DuongNAD/Project_IoT/slides/preview/slide_07.png

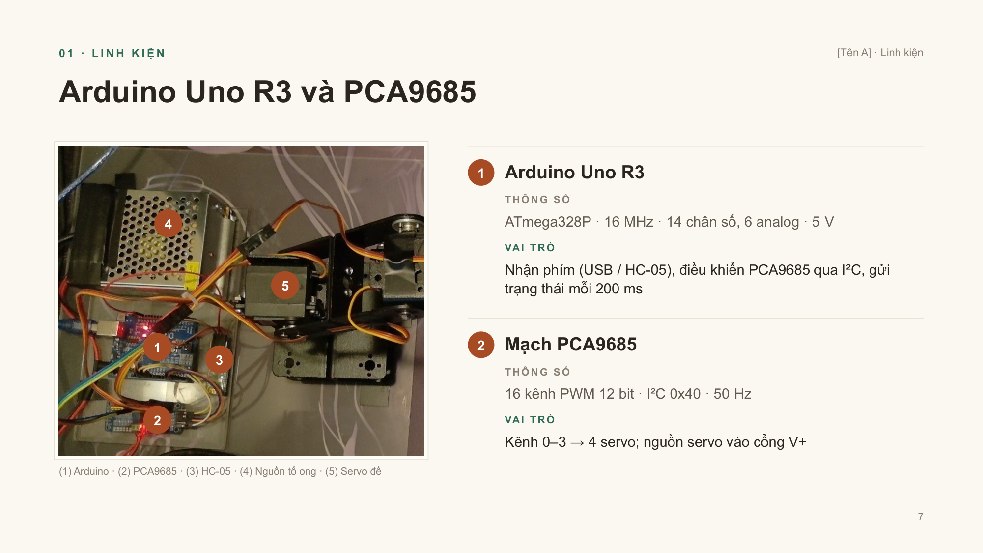
slides/preview/slide_07.png
