DuongNAD/Project_IoT/slides/preview/slide_13.png

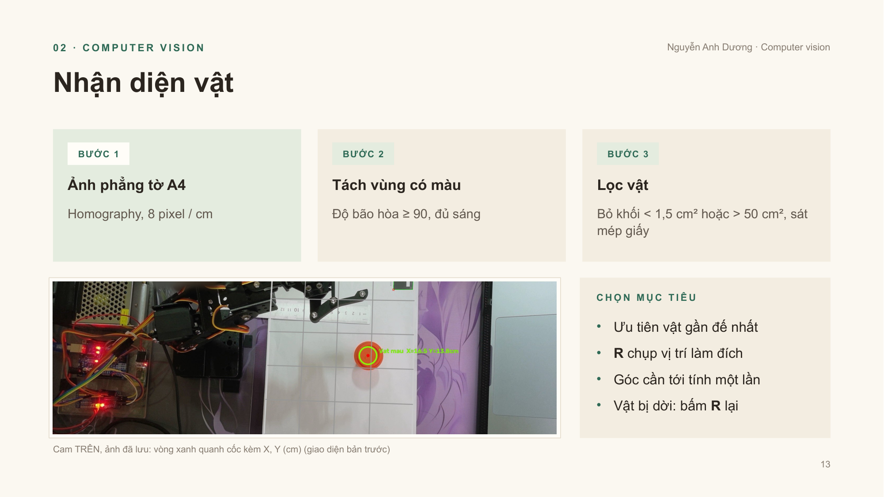
slides/preview/slide_13.png
