DuongNAD/Project_IoT/slides/05_SO_LIEU_VA_NGUON.md

# 05 · Số liệu và nguồn (nguồn sự thật duy nhất cho slide)

Mọi con số, tên linh kiện và nhận định trên slide **chỉ được lấy từ file này**. Kiểm tra lần cuối: **10/11/2026**, sau khi rút gọn mã phần 2
(`vision.py`, `cameras.py`, `screen.py`, `success.py`; bỏ YOLO, điện thoại, xoay hình, tráo camera). Ngày 11/11: đế khởi động ở 180°, điều khiển từ xa bằng máy Dell đưa lại ở dạng gọn (`share.py`, `remote.py`); phím R chụp đích một lần; rút gọn cổng USB (bỏ phần cho firmware cũ), bỏ phím C; bỏ bộ test tự động, nhóm kiểm tra bằng mắt (xem mục 11); các việc làm tay được thì bỏ code: tạo tờ ArUco, công cụ khớp hiệu chỉnh, hiệu chỉnh đế bằng chuột (phím B), chạy không cửa sổ, tự tìm cổng Arduino, báo Arduino reset, tìm camera theo tên. Bộ slide đã dựng: `Project_IoT_ThuyetTrinh.pptx` (26 slide, 3 phần cho 4 người, `build_slides.py`).

Kiểm lại bằng máy sau mỗi lần sửa mã: `.venv/bin/python -B slides/tools/check_facts.py` (so các hằng số ở mục 17 và mọi dẫn `file:dòng` trong các file `.md` với mã hiện tại).

Nhãn trạng thái:

| Nhãn | Nghĩa |
|---|---|
| **[CODE]** | đọc trực tiếp từ mã nguồn, firmware hoặc `calibration.json` (có dòng dẫn) |
| **[ĐO]** | đo hoặc quan sát trên phần cứng thật (ảnh, hoặc ghi chú của phiên làm việc ngày 02/11 khi không có ảnh) |
| **[MÔ PHỎNG]** | chạy trên ảnh đã lưu, hoặc với cánh tay mô phỏng (không cắm USB) |
| **[ƯỚC LƯỢNG]** | suy ra từ ảnh, sai số ± đã ghi; phải nói "khoảng" |
| **[CHƯA]** | chưa làm hoặc chưa kiểm chứng; chỉ được nói là "chưa" |

---

## 1. Phần cứng

| Mục | Giá trị | Nhãn | Nguồn |
|---|---|---|---|
| Vi điều khiển | Arduino Uno (board `arduino:avr:uno`) | CODE | `robot_arm_4dof/flash.sh:19`; `README.md` mục 1 |
| Mạch PWM | PCA9685, địa chỉ I²C 0x40, xung 50 Hz | CODE | `robot_arm_4dof.ino:8,90` |
| Servo | 4 × MG996R: kênh 0 đế, 1 vai, 2 khuỷu, 3 kẹp | CODE | `README.md` mục 1; `robot_arm_4dof.ino:26-29`; `control.py:44` |
| Bước mỗi phím | đế, vai, khuỷu **2°**; kẹp **5°** | CODE | `robot_arm_4dof.ino:13-14`; `control.py:51` |
| Giới hạn góc | đế 0–180°, vai 25–155°, khuỷu 25–155°, kẹp 95–**160°** | CODE | `control.py:45-50`; `robot_arm_4dof.ino:19-21,121-152` |
| Góc khởi động / Home | **180** / 90 / 90 / 95° (phím `H` đưa về): đế quay hết sang phải (nhìn theo cam NGANG) để cánh tay không che vật ở cam TRÊN; trước 11/11 là 90 / 90 / 90 / 95° | CODE | `robot_arm_4dof.ino:26-29,154-158`; `control.py:45-50` |
| Nguồn servo | nguồn tổ ong riêng 5–6 V vào cổng xanh PCA9685, **không** lấy từ cổng USB | CODE (tài liệu) | `README.md` mục 1 |
| Bluetooth | HC-05 qua `SoftwareSerial` chân D2/D3, 9600 baud; nhận phím từ máy Dell khi điều khiển từ xa (mục 5) | CODE | `robot_arm_4dof.ino:6,87` |
| Cổng USB tới laptop | Serial 9600 baud; cổng ghi tay khi chạy (`--port /dev/cu.usbmodem…` trên macOS, `--port COM3` trên Windows), không ghi thì chạy mô phỏng | CODE | `robot_arm_4dof.ino:86`; `control.py:186`; `main.py` (`--port`) |
| Gói trạng thái Arduino → laptop | JSON `{"t":…,"servo":[đế,vai,khuỷu,kẹp],"relax":0\|1,"armrelax":0\|1}`; gửi ngay sau mỗi phím và mỗi 200 ms (5 gói/giây danh định, **đo thực tế 4–5 gói/giây**) | CODE + ĐO | `robot_arm_4dof.ino:70-83,186-188,203-207` |
| **Góc servo báo về là góc LỆNH** | gói JSON in các biến `angleBase`, `angleShoulder`… mà firmware đã gán; MG996R không báo vị trí thật. "Đã tới góc" nghĩa là lệnh đã tới góc, **không** phải đã đo thấy cánh tay ở đó | CODE | `robot_arm_4dof.ino:70-83` |
| Cam TRÊN | OBSBOT Meet SE treo phía trên tờ giấy, nhìn xuống, 1920×1080 | CODE + ĐO | `README.md` mục 1; ghi chú phiên 02/11 (memory `project-iot-camera-setup`) |
| Cam NGANG | camera tích hợp MacBook đặt thấp trước tờ giấy, 1920×1080 | CODE + ĐO | `README.md` mục 1; `cameras.py:1-7` |
| Hệ điều hành và thư viện | macOS, Python ≥ 3.12, OpenCV, pyserial; chạy được cả trên Windows (camera mở bằng DirectShow, cổng `COMx`); camera chọn bằng chỉ số OpenCV (`--top`, `--side`); **mọi ảnh và số đo trong slide đều làm trên macOS** | CODE | `pyproject.toml`; `cameras.py:19-28` |

## 2. Tờ A4, hệ tọa độ và nhận diện vật

| Mục | Giá trị | Nhãn | Nguồn |
|---|---|---|---|
| Tờ giấy | A4 đặt ngang 29,7 × 21,0 cm, in đúng 100% (đo cạnh một mã phải đúng 2,8 cm) | CODE | `vision.py:16`; `README.md` mục 1 |
| Mã ArUco của tờ | 4 mã `DICT_4X4_50` (bộ mã có sẵn của OpenCV), ID 0–3, cạnh 2,8 cm, cách mép 0,25 cm, sát 4 góc; tờ in là `aruco_A4_clean.pdf`; dò mã bằng hàm có sẵn `cv2.aruco` | CODE | `vision.py:17-19` |
| Hệ tọa độ | gốc ở góc ngoài mã ID 0; X chạy ID 0 → ID 1 (29,7 cm); Y chạy ID 0 → ID 3 (21,0 cm); gắn với **tờ giấy**, không phụ thuộc camera nào nhìn | CODE | `README.md` mục 4; `calibration.py:5` |
| Homography | từ các mã ArUco 0–3 (cần ≥ 2 mã), cho **cả hai camera**; ảnh phẳng của tờ giấy dựng bằng `warpPerspective` | CODE | `vision.py:45-62,71` |
| Che mất mã | nhớ vị trí từng mã nên che 1–3 mã vẫn còn lưới; dời camera hoặc tờ giấy thì bấm `U` để quên | CODE + MÔ PHỎNG | `README.md` mục 4; `main.py:100-102` |
| **Cách tìm vật** | tách màu HSV trên ảnh phẳng của tờ giấy: độ bão hòa ≥ 90, sáng ≥ 60; bỏ khối < 1,5 cm² (nhiễu, dây điện) hoặc > 50 cm² (bàn tay, không lọt miệng kẹp), khối cách mép giấy dưới 1 cm (bỏ lọc "dính thân robot" ngày 12/11: đích chỉ chụp một lần khi bấm R) | CODE | `vision.py:68-91` |
| YOLO | **đã bỏ** ngày 10/11 khi rút gọn phần 2 (trước đó là tùy chọn `--yolo`, mặc định tắt, bản COCO chưa fine-tune, có nhận nhầm) | CODE | `README.md` mục 9 |
| Kích thước cốc đỏ số 3 | thân 34 mm, nắp ≈ 40 mm, cao 50 mm (độ cao dùng để bù thị sai) | ĐO | `vision.py:23` |
| Chọn vật (phím `R`) | bấm `R`: vật gần đế nhất trong ảnh lúc bấm thành đích, góc cần tới tính **một lần** lúc bấm, sau đó không theo camera nữa (tay kẹp che hay đẩy lệch vật cũng không đổi đích); vật bị dời thì bấm `R` lại; chưa bấm `R` thì chưa có lệnh. Bỏ ngày 11/11: theo dõi vật liên tục (trung bình 10 khung, nhớ 120 s khi bị che, `R` bỏ chốt) | CODE | `control.py:253-275` |
| **Hiệu chỉnh phối cảnh cam TRÊN** | cam treo cao ≈ 46 cm nhìn xuống; vật cao 5 cm hiện lệch ≈ 1 cm; công thức `p_thật = n + (p_đo − n)·(H − h)/H` (n: tâm ảnh, H: 46 cm, h: độ cao vật). Một phép đo ngày 02/11: cam TRÊN (20,6; 6,8) cm, cam MacBook (20,0; 7,8) cm, lệch **1,2 cm**; sau hiệu chỉnh còn **0,2 cm** | CODE + ĐO (một vị trí cốc) | `vision.py:22-23,76-89` |
| Độ cao 46 cm của cam TRÊN | ước từ ảnh (≈ 27 px/cm ở mặt bàn); không đo bằng thước | ƯỚC LƯỢNG | `vision.py:22`; ghi chú phiên 02/11 |

## 3. Khối điều khiển (`control.py`): từ vật tới phím cần bấm

| Mục | Giá trị | Nhãn | Nguồn |
|---|---|---|---|
| Việc của khối điều khiển | vật ở (X, Y) cm → góc ba servo cần tới (IK) → danh sách phím cần bấm; giữ cổng USB tới Arduino. **Không biết** thế nào là "xong" | CODE | `control.py:-1-11`; `README.md` (đầu trang, bảng hai nhóm) |
| Số đo cánh tay mặc định (`ARM_CONFIG`) | d₁ = 70 mm (mặt bàn → trục vai), L₂ = 105 mm (vai → khuỷu), L₃ = 100 mm (khuỷu → cổ tay), tâm hai ngón kẹp lệch L₄ᵣ = 65 mm ra trước và L₄z = 25 mm xuống dưới | CODE (số đo thước) | `control.py:26-31` |
| Góc chuẩn khi servo 90° (mặc định) | khâu L₂ nghiêng +45°, khâu L₃ gập −45° so với L₂; **thực tế khác** (xem mục 8) | CODE | `control.py:39-40` |
| Mô hình | đế quay θ₁ = atan2(y, x); vai + khuỷu giải tam giác hai khâu (nghiệm khuỷu hướng lên); **không có servo cổ tay** nên hướng ngón kẹp không chọn được | CODE | `control.py:60-96` |
| Điểm kẹp mục tiêu | cao **25 mm** (nửa thân cốc cao 50 mm) | CODE | `control.py:54` |
| Đổi sang servo | đế = 90 + θ₁; vai = 90 + (θ₂ − θ₂@90); khuỷu = 90 + (θ₃ − θ₃@90); làm tròn về bội số của bước (2°) quanh neo 90°, kẹp trong giới hạn | CODE | `control.py:99-116` |
| Đổi tọa độ | giấy (cm) ↔ hệ robot (mm) theo vị trí và hướng của đế | CODE | `control.py:119-131` |
| Phím và hướng | `A` / `D` xoay đế **sang phải / sang trái, nhìn theo cam NGANG (MacBook)**; `W` / `S` nâng / hạ vai; `I` / `K` khuỷu lên / xuống; `J` / `L` mở / khép kẹp; `H` Home; `X` kẹp nghỉ | CODE | `control.py:138-143`; `README.md` mục 2 |
| Lưu ý chú thích | chú thích trong firmware ghi `a (Trái)` theo hướng nhìn của chính robot; trên màn hình và slide dùng hướng nhìn theo cam NGANG, ngược lại | CODE | `robot_arm_4dof.ino:120`; `screen.py:51` |
| Kế hoạch bấm (`Plan`, `Move`) | mỗi servo một `Move` gồm phím, số lần (= độ lệch ÷ bước, làm tròn xuống), hướng, số độ; **kẹp không bao giờ nằm trong Plan** | CODE | `control.py:147-169,232-241` |
| Ngoài tầm với | IK báo `reachable = False` và dời vật thêm bao nhiêu mm; màn hình ghi `Vat ngoai tam voi` | CODE | `control.py:60-96`; `screen.py:21-25` |
| **Ví dụ tính được** | với `calibration.json` hiện tại, cốc ở **(20,1; 7,4) cm** → robot x = 240 mm, y = −73 mm → gợi ý **đế 74°, vai 58°, khuỷu 90°**. Từ tư thế 90/90/90: đế −16° = phím **D × 8**, vai −32° = phím **S × 16**, khuỷu 0 (đã đúng) | CODE (tính lại 02/11 23:07) | mục 16 |
| Ví dụ trên ảnh màn hình (slide 8) | khung camera thật 20:27: cốc ở **(16,5; 13,8) cm** → gợi ý **[đế 88°, vai 60°, khuỷu 84°]**; từ 90/90/90 (Home của bản trước 11/11): **S × 15** (hạ vai 30°), **K × 3** (khuỷu xuống 6°), đế lệch 2° nên `DA DUNG`; còn **18 lần bấm** | MÔ PHỎNG (chương trình chạy trên ảnh đã lưu; đế đổi sang hệ lúc chụp, xem mục 5) | ảnh `ui_screen_before.png`; `slides/tools/make_screen_images.py` |
| Cổng USB | 9600 baud, đọc nền; **mở cổng một lần** lúc chạy và không mở lại (mỗi lần mở cổng Uno tự reset); rút cáp USB thì chạy lại chương trình; Arduino reset thì nhìn thấy cánh tay giật về Home (không có cảnh báo trên màn hình) | CODE | `control.py:175-226` |
| Gửi phím | app chỉ gửi phím khi **người bấm**; không còn chế độ tự gửi (Auto-Step đã bỏ) | CODE | `control.py:277-283`; `main.py:90-103` |

## 4. Khối success (`success.py`): đã tới chưa?

| Mục | Giá trị | Nhãn | Nguồn |
|---|---|---|---|
| Việc của khối success | nhận `Plan` của khối điều khiển, trả lời một câu: ba servo đế / vai / khuỷu đã tới góc gợi ý chưa. **Không biết** gì về camera, IK hay cổng USB | CODE | `success.py:1-6` |
| Quy tắc "đã tới" | mỗi servo lệch **≤ 1 bước bấm (2°)** so với góc gợi ý (lệch 3° là chưa) | CODE | `success.py:11,27` |
| Quy tắc "một lần thành công" | cả ba servo đã tới và **giữ liên tục ≥ 1,0 giây** thì đếm thêm 1; giữ thêm không đếm nữa; lướt qua chưa đủ 1 s không đếm; rời góc rồi tới lại đủ lâu thì đếm lần hai | CODE | `success.py:12,38-56` |
| Kẹp **không tính** | kẹp lệch 55° vẫn XONG; bản đơn giản chỉ cần đưa đầu kẹp tới đúng chỗ của vật | CODE | `success.py:4` |
| Bốn trạng thái | `done` (xong) · `moving` (còn phải bấm) · `no_target` (chưa có đích: chưa bấm `R`) · `unreachable` (vật ngoài tầm); `no_target` được xét trước, rồi `unreachable` (trạng thái `relaxed` đã bỏ ngày 12/11 cùng phím `Z`); chưa có đích thì không được báo xong | CODE | `success.py:17,25-35` |
| Kết quả (`Result`) | `state`, `done`, `joints_ok` (3 giá trị), `next_move` (việc đầu tiên chưa xong theo thứ tự đế → vai → khuỷu), `remaining` (tổng số lần bấm còn lại), `count` | CODE | `success.py:15-22` |
| Vì sao dung sai 2° | "mô hình hình học chỉ chính xác cỡ đó"; bắt căn tới 0° chỉ làm người dùng đuổi theo nhiễu | CODE (chú thích) | `success.py:11` |
| Hai khối chỉ nói chuyện qua một đối tượng | `Plan` (khối điều khiển sinh ra, khối success đọc); cùng một `Plan` cho cùng một kết luận, không cần camera hay cổng USB | CODE | `README.md` (đầu trang) |
| **Giới hạn của "XONG"** | góc servo là **góc lệnh** (mục 1): XONG chứng minh phím đã được bấm đúng số lần, **không** chứng minh hai ngón kẹp thật đang ở sát vật. Độ đúng của gợi ý phụ thuộc mô hình hình học (mục 8) | CODE | `robot_arm_4dof.ino:70-83`; `success.py:30` |
| **Trạng thái thật** | **chưa có lần đếm thành công nào trên cánh tay thật**: bản này mới chạy trên ảnh đã lưu với cánh tay mô phỏng (`slides/tools/make_screen_images.py`); Arduino được rút ra lúc ≈ 22:40 | MÔ PHỎNG / CHƯA | ghi chú phiên 02/11; `ls logs` (không có thư mục) |

## 5. Màn hình (`screen.py`, `main.py`)

| Mục | Giá trị | Nhãn | Nguồn |
|---|---|---|---|
| Bố cục | cửa sổ rộng 1280 px: hai camera ở trên (mỗi ô 640 × 360), bên dưới **ô 1 · ĐIỀU KHIỂN** (trái) và **ô 2 · SUCCESS** (phải), chân trang; chỉ có chữ, không trang trí | CODE | `screen.py:1-10,45-75` |
| Ô 1 | lệnh to màu cam: `BAM D x8: SANG TRAI 16 do`; ba dòng servo (`DE (xoay): 90 -> 74 do bam D x8`), dòng đã tới ghi `DA DUNG` màu xanh | CODE | `screen.py:50-59` |
| Ô 2 | `CHUA XONG` + `con N lan bam`, hoặc **`XONG!`** màu xanh khi cả ba servo tới góc; `Thanh cong: N lan` | CODE | `screen.py:61-70` |
| Trạng thái khác | ô 1 ghi `Chua co dich: ... roi bam R`, `Vat ngoai tam voi` hoặc `Khong can bam them`; ô 2 ghi `CHUA XONG` | CODE | `screen.py:21-25` |
| Trên hai camera | vòng **DICH** (chỗ vật lúc bấm `R`) vẽ trên mặt giấy (dấu **KEP** đã bỏ ngày 12/11); lưới 5 cm; viền tờ giấy; dòng `Luoi A4: thay n/4 ma ArUco` | CODE | `main.py:65-71`; `vision.py:108-121,135-157` |
| Chân trang | trạng thái USB (`DA KET NOI` hoặc `MO PHONG`), hàng phím tắt | CODE | `screen.py:72-74` |
| **Điều khiển từ xa** | máy Dell cách ≈ 2 m: `remote.py` lấy ảnh màn hình Mac qua Wi-Fi (`share.py`, `http://<ip Mac>:8000/screen.jpg`, chỉ cho xem, không nhận lệnh) và gửi phím `A D W S I K J L H X` qua Bluetooth HC-05 thẳng tới Arduino; `H` phải bấm 2 lần trong 2 giây; `R` bấm trên bàn phím Mac. Mac vẫn nối USB để nhận góc servo và tính lệnh, success | CODE | `share.py`; `remote.py`; `main.py:106-118` |
| Điều khiển từ xa trên phần cứng | bản rút gọn 11/11 **chưa chạy với HC-05 và máy Dell thật** | CHƯA | — |
| Chữ **không dấu** | OpenCV `putText` không vẽ được dấu tiếng Việt: giữ nguyên, nói rõ khi thuyết trình | CODE | `screen.py:10` |
| Ảnh màn hình trên slide | `ui_screen_before.png` (khung camera 20:27) và `ui_screen_done.png` (khung 20:32:52, sau khi **mô phỏng** bấm 21 phím theo lệnh) là màn hình **thật của chương trình (giao diện trước khi rút gọn `screen.py` ngày 10/11, còn dấu `KEP` đã bỏ ngày 12/11; chạy lại `make_screen_images.py` trên Mac để có giao diện mới), chạy trên ảnh camera thật đã lưu, cánh tay MÔ PHỎNG** (chân trang ghi `USB Arduino: MO PHONG`, tiêu đề camera ghi `anh da luu`): không phải lần chạy trực tiếp. Ảnh chụp lúc tờ giấy còn hướng ban đầu còn `calibration.json` ghi theo tờ đã xoay 180°, nên script đổi đế về hệ lúc chụp rồi tự kiểm (dấu `KEP` đã hiệu chỉnh cách cốc ≤ 2 cm, không thì dừng). Hai ảnh cho cốc lệch 1,5 cm vì hai ngón kẹp che cốc ở khung 20:32:52 | MÔ PHỎNG | `slides/tools/make_screen_images.py` |

## 6. Firmware bảo vệ servo (tránh nóng)

| Mục | Giá trị | Nhãn | Nguồn |
|---|---|---|---|
| Nguyên nhân nóng | firmware cũ không ngắt xung PWM: kẹp giữ vật hoặc chạm chốt chặn thì servo bị ép liên tục; lệnh đóng cũ 175° ứng xung ≈ 2,74 ms, vượt dải 0,5–2,5 ms của MG996R | CODE (chú thích) | `robot_arm_4dof.ino:16-18,21`; `README.md` mục 6 |
| Giới hạn kẹp hiện tại | **160°** (xung ≈ 2,56 ms, **hơi vượt** dải danh định 2,5 ms); nâng từ 150° lên 160° theo chủ máy vì ở 150° khe giữa hai ngón bằng bề rộng nắp cốc nên không siết được; vẫn có tự nhả xung | CODE + ĐO | `robot_arm_4dof.ino:21`; ghi chú phiên 02/11 21:4x |
| Ngắt xung tự động | kẹp **mở hết cỡ (đúng 95°)** 5 giây không có lệnh kẹp → ngắt xung; kẹp **đã khép (> 95°)** quá 60 giây → ngắt xung (vật có thể tuột) | CODE | `robot_arm_4dof.ino:22-23,191-201` |
| Phím nghỉ | `X` nghỉ servo kẹp ngay; firmware vẫn còn lệnh `z` (nghỉ cả 4 servo) nhưng app không gửi phím này (bỏ ngày 12/11); chỉ phím di chuyển mới cấp xung lại | CODE | `robot_arm_4dof.ino:160-176`; `README.md` mục 6 |
| Cờ trong JSON | `relax` (kẹp nghỉ), `armrelax` (ba servo còn lại nghỉ) | CODE | `robot_arm_4dof.ino:78-82` |
| Chương trình biết tay đang nghỉ | đã bỏ ngày 12/11 cùng phím `Z`: app không còn trạng thái `relaxed`, chỉ đọc `servo` trong gói JSON | QUYẾT ĐỊNH | `success.py:25-35` |
| **Đã nạp và kiểm** | firmware cuối (phím Z, bước 2°/5°, giới hạn 160°) nạp lúc 21:42:45 và 21:54:48 ngày 02/11, kiểm trên mạch thật: banner kết thúc `+ Z (nghi het)`, JSON có `armrelax`. Trước đó (17:35) bản chống nóng kênh kẹp: `relax` chuyển 0 → 1 sau 5 giây ở 95° | ĐO (ghi chú phiên) | memory `project-iot-arduino-firmware`; `robot_arm_4dof.ino:99` |
| Kẹp đã ngắt xung thì tự khép | khi PWM kênh kẹp bị cắt, hai hàm rơi thành hình chữ V hẹp (khe ≈ 1–2 cm), trong khi kẹp có xung ở 95° thì mở rộng ≈ 7 cm. Hệ quả: ngắt xung sau 5 s ở 95° làm hàm sập nếu không bấm `J` lại | ƯỚC LƯỢNG (ảnh zoom ±30%) | ghi chú phiên 02/11 20:18 |
| Nhiệt độ servo | **chưa đo**; chưa có số "nguội đi bao nhiêu độ" | CHƯA | — |
| Màn hình cảnh báo "GIU 31s" | **không còn** (thuộc giao diện cũ đã bỏ) | — | `screen.py` không có |

## 7. Buổi thử trên cánh tay thật, 02/11/2026

| Mục | Giá trị | Nhãn | Nguồn |
|---|---|---|---|
| Thử 18:10–18:28 | một hướng tiếp cận, dừng trước khi kẹp. Kết luận "cốc ở mép tầm với, dời cốc 3 cm" **đã bị rút lại**; ảnh buổi này không dùng | — | ghi chú phiên (đính chính 20:25) |
| **Kẹp bằng bàn phím 20:32–20:36** | người bấm phím theo hình hai camera (và màn hình bản cũ): cốc đỏ ở giữa giấy được kẹp, chuyển sang trái, đặt xuống, lặp lại nhiều lần; cốc đổ khoảng 3 lần và được dựng lại bằng tay | ĐO | ảnh `demo_*` (khung cắt từ video, mỗi cặp cách 10 giây: 20:32:52, 20:33:02, 20:33:12) |
| Góc servo lúc kẹp | đế ≈ 85°, vai ≈ 60–65°, khuỷu ≈ 85–90°, kẹp ≈ 145–150°; đế ≈ 60° khi mang cốc sang trái (đọc từ màn hình bản cũ) | ĐO | ghi chú phiên 02/11 20:32–20:35 |
| Tay kẹp không giữ chắc cốc thon | ở 150° khe giữa hai ngón bằng bề rộng nắp cốc (≈ 3,9 cm) nên cốc bị đẩy ra; cốc thon dần xuống đáy nên hai mặt kẹp đẩy nó ra "như hạt dưa"; **nâng giới hạn lên 160° cũng chưa giữ chắc**. Cách chữa đề xuất: dán ma sát (băng keo hai mặt / xốp mỏng) lên mặt trong hai ngón, hoặc dùng vật thân thẳng | ĐO + CODE (tài liệu) | `README.md` mục 6; `robot_arm_4dof.ino:21`; ghi chú phiên 21:42–21:58 |
| **Quyết định của đề tài** | vì vậy "thành công" chỉ xét **ba góc servo đế / vai / khuỷu** tới góc gợi ý, kẹp không tính | QUYẾT ĐỊNH | `success.py:4`; ghi chú phiên 22:00 |
| Tự động | **không**: app chỉ gửi phím khi người bấm | CODE | mục 3 |
| Tỉ lệ thành công | **chưa đo**; kế hoạch 28/10 đặt mục tiêu ≥ 80% trên 30 lần, chưa chạy | CHƯA | kế hoạch PDF; không có thư mục `logs/` |

## 8. Mô hình lệch cánh tay thật và hiệu chỉnh bằng các lần "ôm" cốc

| Mục | Giá trị | Nhãn | Nguồn |
|---|---|---|---|
| **Mô hình mặc định lệch** | ba lần ôm đầu (người bấm phím cho hai ngón bao quanh cốc): servo [85, 60, 90] lúc 20:32:50, [80, 70, 75] lúc 20:46, [75, 85, 50] lúc 21:03:35. Mô hình mặc định đặt đầu kẹp ở (12,6; 17,7), (10,6; 16,3), (9,3; 13,4) cm, còn cốc thật ở (16,9; 14,4), (13,3; 14,0), (10,8; 7,7) cm → lệch **5,4 · 3,5 · 5,9 cm**, luôn về một phía (hệ thống) | CODE (tính lại 02/11 23:07) + ĐO (vị trí cốc đo bằng camera) | mục 16; ghi chú phiên 02/11 |
| Cùng ý với màn hình cũ | màn hình bản cũ lúc 20:32:05 báo `Sai so dau kep: 56 mm` khi cốc đã nằm giữa hai ngón kẹp thật | ĐO | ảnh `ui_status_bar.png` (không dùng trên slide) |
| Nguyên nhân (đã tìm ra) | (1) vị trí và hướng đế lệch so với mặc định; (2) hai góc chuẩn vai / khuỷu khi servo ở 90° khác 45° / −45° (phụ thuộc cách lắp cần servo, thước không đo được); (3) **càng kẹp gắn cứng vào khâu khuỷu** nên độ lệch của điểm kẹp quay theo khâu đó, trong khi mô hình cũ giữ độ lệch cố định theo phương ngang | CODE (tài liệu) | `calibration.py:16-20`; `README.md` mục 4 |
| Cách sửa | **hiệu chỉnh bằng trình diễn**: người đưa hai ngón kẹp bao quanh cốc, ghi góc ba servo + vị trí cốc; từ ≥ 2 mẫu cách nhau ≥ 5 cm, khớp 5 thông số (x, y, hướng của đế; hai góc chuẩn vai, khuỷu) bằng bình phương tối thiểu (Levenberg–Marquardt); kèm mô hình càng kẹp quay theo khâu khuỷu (gộp vào chiều dài khâu 3). Công cụ khớp `arm_fit.py` đã bỏ khỏi repo ngày 11/11 (còn trong lịch sử git); kết quả nằm trong `calibration.json` | CODE (lịch sử) | `calibration.py:2-12` |
| **Kết quả** | **10 mẫu**, sai số khớp (RMS trong mặt phẳng) **8,5 mm**, bỏ-một-mẫu (leave-one-out) **11,6 mm** | CODE (file) | `calibration.json` mục `arm_fit` |
| Giá trị đã lưu | đế (13,83; 31,67) cm, hướng −92,4°; θ₂@90 = 60,2° (mặc định 45°), θ₃@90 = −58,6° (mặc định −45°); càng kẹp gộp vào khâu 3: L₃ = 183,7 mm, L₄ᵣ = L₄z = 0 (mặc định 100 / 65 / 25 mm) | CODE (file) | `calibration.json`; `calibration.py:35-60` |
| **Hiệu lực hạn chế** | chỉ đúng với tờ giấy dùng lúc đo (tờ cũ in nhỏ hơn đúng cỡ ≈ 4,5%, nên mọi số cm đo trên đó lớn hơn thật ≈ 4,7%) và với vị trí robot lúc đo; **đổi tờ giấy hoặc dời robot thì phải đo lại** | CODE + ĐO | `README.md` mục 4; `calibration.json` mục `arm_fit.to_giay` |
| Ví dụ sau hiệu chỉnh | cốc (20,1; 7,4) → gợi ý [74°, 58°, 90°]. Hai tư thế người căn tay quanh cốc ở chỗ đó, [72, 54, 92] và [74, 60, 86], cho đầu kẹp theo mô hình ở (20,6; 7,5) và (19,6; 7,8) cm, cách cốc **0,5 và 0,6 cm**; gợi ý lệch chúng 0–4° mỗi servo. Chưa rõ hai tư thế này có nằm trong 10 mẫu khớp không: **chỉ nói "gần", không nói "kiểm độc lập"** | CODE (tính lại) + ĐO (tư thế, ghi chú phiên) | mục 16 |
| Ảnh minh họa (slide 11) | khung cam NGANG lúc ôm cốc 21:03:35, servo [75, 85, 50]: dấu mô hình mặc định cách cốc ≈ **5,3 cm**, dấu mô hình đã hiệu chỉnh ≈ **0,95 cm** (cốc đo từ cam ngang, ± 1 cm). Lần ôm này nằm trong bộ mẫu khớp: **không phải kiểm độc lập**; số 5,9 cm ở hàng trên dùng vị trí cốc ghi lúc ôm (cùng cỡ) | ĐO (ảnh) | ảnh `calib_before_after_side.jpg`; `slides/tools/make_screen_images.py` |
| Gợi ý trên ảnh 20:27 so với tư thế thật | gợi ý [88°, 60°, 84°] cho cốc ở (16,5; 13,8) cm, so với tư thế người thật sự ôm cốc lúc 20:32:50: [85°, 60°, 90°] (đọc từ màn hình bản cũ): lệch 3° / 0° / 6°. **Chưa rõ lần ôm 20:32 có trong 10 mẫu khớp không**: chỉ nói "gần", không nói "kiểm độc lập" | MÔ PHỎNG + ĐO | ảnh `ui_screen_before.png`; mục 7 |
| Đo lại khi dời robot | đo vị trí đế trên tờ giấy bằng thước rồi sửa tay mục `base` trong `calibration.json`; hiệu chỉnh bằng chuột (phím `B`) đã bỏ ngày 11/11 | QUYẾT ĐỊNH | `README.md` mục 4 |
| **Chưa làm** | chưa thử chuỗi đầy đủ trên cánh tay thật: bấm đúng theo gợi ý của bản mới rồi xem hai ngón có bao quanh cốc không; chưa hiệu chỉnh lại cho tờ giấy mới | CHƯA | — |

## 9. Tay kẹp phi tuyến

| Mục | Giá trị | Nhãn | Nguồn |
|---|---|---|---|
| Cơ cấu | kẹp song song hai ngón, **phi tuyến** theo góc servo | ĐO | ảnh `hw_gripper_95_vs_125.jpg` |
| Số đo | mở hết cỡ (95°): hai hàm cách ≈ 7,5 cm; từ 95° lên 125°: ngón vươn ra trước ≈ 1,7 cm nhưng khe chỉ hẹp ≈ 0,5 cm | ĐO (3 điểm 95 / 110 / 125°) | `README.md` mục 6; ghi chú phiên 02/11 18:2x |
| Ảnh zoom từ trên | khe giữa hai đầu ngón ≈ 7 cm ở 95°, ≈ 5–6 cm ở 125°, ≈ 3,3–4 cm ở 150° (độ lớn biểu kiến, ± 30% do phối cảnh) | ƯỚC LƯỢNG | ghi chú phiên 02/11 20:20 |
| Vật rộng ≈ 4 cm | (như cốc đỏ) bị đẩy ra khi khép tới 150–160° | ĐO | `README.md` mục 6 |
| Không nói | "cần 155–165° để kẹp" là ngoại suy từ 3 điểm, **chưa được xác nhận**; giới hạn 160° là quyết định của chủ máy, không phải góc kẹp "đúng" | — | mục 14 |

## 10. Lỗi tích hợp khó thấy

| Mục | Giá trị | Nhãn | Nguồn |
|---|---|---|---|
| Chỉ số camera trên macOS | `cv2.VideoCapture(i)` sắp camera theo `uniqueID`; danh sách của AVFoundation / `system_profiler` xếp camera "dùng gần nhất" lên đầu nên đổi thứ tự giữa các lần chạy (đã thấy: lúc `[OBSBOT, MacBook]`, lúc `[MacBook, OBSBOT]`; có lúc hai khung cùng là OBSBOT). Cách xử lý (từ 11/11): chọn camera bằng chỉ số khi chạy (`--top`, `--side`), nhìn hai khung hình, thấy đảo thì đổi hai số; trước đó chương trình tìm camera theo tên | ĐO + CODE | `cameras.py:1-7`; `README.md` mục 5 |
| Arduino Uno tự reset | mở rồi đóng cổng USB làm đường DTR hạ xuống rồi nâng lên → Uno reset → 4 servo giật về Home 180/90/90/95. Thường do **một chương trình thứ hai** mở cổng khi `main.py` đang chạy. Cách xử lý: chương trình chỉ mở cổng **một lần** lúc chạy và không mở lại; đừng mở cổng bằng chương trình khác khi `main.py` đang chạy; reset thì nhìn thấy cánh tay giật về Home | ĐO + CODE | `control.py:175-185`; `README.md` mục 6 |

## 11. Mã nguồn và cách kiểm tra

| Mục | Giá trị | Nhãn | Nguồn |
|---|---|---|---|
| Cách kiểm tra | **bằng mắt** khi chạy chương trình: lưới 5 cm có bám tờ giấy, vòng xanh có nằm trên cốc, bấm theo lệnh thì cánh tay đi đúng hướng. Bộ test tự động (100 test) đã bỏ ngày 11/11, còn trong lịch sử git | QUYẾT ĐỊNH | — |
| Quy mô | 7 module Python ≈ **823 dòng** (`main.py` 144 · `control.py` 286 · `success.py` 56 · `screen.py` 75 · `vision.py` 157 · `cameras.py` 45 · `calibration.py` 60) + điều khiển từ xa (`share.py` 66 · `remote.py` 99) + firmware 208 dòng. Phần 2 (vision, cameras, screen, success) từ 1 677 dòng (10/11) còn 377 dòng (12/11) | CODE | `wc -l` (11/11) |
| Chạy không cần phần cứng | `main.py --top a.jpg --side b.jpg` (không ghi `--port`): chương trình đọc ảnh như camera và mô phỏng cánh tay; chế độ không cửa sổ `--headless` đã bỏ ngày 11/11 | CODE | `README.md` mục 7; `cameras.py:19-35` |
| Mỗi khung hình là ba dòng | `plan = control.update(vision.objects)` → `result = success.update(plan)` → `build_screen(…, plan, result)` | CODE | `README.md` mục 3; `main.py:76-79` |
| Repo | `github.com/DuongNAD/Project_IoT`: nhánh `main` (`e3f2d85`, 03/11/2026) đã có bản hai khối (`control.py`, `success.py`, `screen.py`, `vision.py`, `cameras.py`, `calibration.py`, `arm_fit.py`, `tests/`, `README.md`) và phần gộp từ máy Windows. `captures/`, `calibration.json` và `slides/assets/real/` nằm trong `.gitignore`; riêng `slides/Project_IoT_ThuyetTrinh.pptx`, `.pdf` và `slides/preview/` **đang được git theo dõi và có nhúng ảnh thật** | CODE | `git log`; `.gitignore`; `slides/.gitignore` |
| Sao lưu bản trước khi đơn giản hóa | `~/Documents/project/Project_IoT_backup_truoc_don_gian_hoa_2026-11-02.tgz` (14 MB, ngoài repo) | CODE | `README.md` mục 9 |

## 12. Đã bỏ khi đơn giản hóa (02/11, khoảng 22:00–22:50)

Mục đích: mã và màn hình giải thích được trong một phút. Chỉ nhắc ở phụ lục I như lịch sử, **không** như tính năng hiện có.

| Đã bỏ | Thay bằng |
|---|---|
| quy trình gắp 5 bước (điểm chờ +60 mm, hạ, đóng kẹp, nâng +80 mm, kiểm 3 giây) | một đích duy nhất: ba servo tới góc gợi ý |
| kiểm tra thành công S1 (cam NGANG thấy vật nhấc ≥ 20 mm) và S2 (cam TRÊN thấy chỗ cũ không còn nguyên) | `success.py`: ba góc servo trong ±2°, giữ 1 s |
| `logs/attempts.csv` | số lần thành công đếm trên màn hình (`Thanh cong: N lan`) |
| Auto-Step (phím `P`, tự gửi phím) | app chỉ gửi phím người bấm |
| cửa sổ HƯỚNG DẪN GẮP và thanh gợi ý 4 servo | màn hình hai phần (điều khiển → success) |
| ước lượng tư thế cam NGANG (tiêu cự, độ cao, góc ngẩng) | không cần: vị trí vật chỉ lấy từ homography của tờ giấy |
| YOLO là mặc định | tách màu là mặc định; YOLO tùy chọn `--yolo` |
| hiệu chỉnh trong chương trình bằng phím `Y` / `E` | công cụ ngoài `arm_fit.py` (cũng bỏ ngày 11/11), kết quả lưu `calibration.json` |

Nguồn: `README.md` mục 9; các tệp bị xóa khỏi thư mục làm việc: `grasp_assist_4dof.py`, `guide_screen.py`, `test_ik.py` (`git status`).

## 13. Kế hoạch ngày 28/10 so với thực tế

Kế hoạch (`Kế hoạch Camera & Gợi ý gắp — Cánh tay robot IoT.pdf`, 28/10/2026) đặt giả định phần cứng chưa biết; phần cứng thật khác:

| | Kế hoạch 28/10 | Thực tế 02/11 |
|---|---|---|
| Vi điều khiển | ESP32 | Arduino Uno |
| Servo | 6 (có cổ tay gập, cổ tay xoay) | 4 (đế, vai, khuỷu, kẹp) |
| Camera | 2 webcam USB 1280×720 | OBSBOT Meet SE + MacBook, 1920×1080 |
| Giao tiếp | USB Serial 115200 baud + MQTT | USB Serial 9600 baud + HC-05 (phím từ máy Dell); **không có MQTT** |
| Nhận diện | ArUco chính; mở rộng YOLO26n-seg | ArUco 4 góc tờ giấy + tách màu (YOLO11s tùy chọn đã bỏ ngày 10/11) |
| Giám sát | dashboard Node-RED / web trên điện thoại | màn hình OpenCV hai phần (lệnh bấm → đã tới chưa) |
| Xác nhận | S1 + S2 (+ S3 cảm biến lực FSR) | **ba góc servo tới góc gợi ý**; không dùng camera để xác nhận gắp, **không có FSR** |
| Mục tiêu đo | ≥ 80% thành công / 30 lần; sai số định vị ≤ 3 mm; kết luận ≤ 2 s; ≥ 20 fps | **chưa đo** (sai số khớp mô hình 8,5 mm là số khác, xem mục 8) |

Kết quả `grep` MQTT, paho, ESP32, FSR, dashboard trong mã nguồn (`*.py`, `*.ino`, `*.toml`, `*.sh`): **không có kết quả**.

---

## 14. CẤM NÓI (và lý do)

| Không được viết hoặc nói | Vì sao | Được nói thay bằng |
|---|---|---|
| "Robot tự động gắp", "tự động hoàn toàn" | app chỉ cho biết bấm phím nào; người bấm; chế độ tự gửi phím đã bỏ | "Hệ thống chỉ cho bạn bấm phím nào, mấy lần; người bấm" |
| "Máy Dell điều khiển cánh tay qua Wi-Fi", "điều khiển từ xa đã chạy ổn trên cánh tay" | Wi-Fi chỉ mang ảnh màn hình; phím đi qua Bluetooth HC-05. Bản rút gọn 11/11 chưa chạy với HC-05 thật | "Dell xem màn hình qua Wi-Fi, gửi phím qua Bluetooth"; nếu chưa thử: "chưa thử trên phần cứng" |
| "Gắp thành công" cho một lần XONG | XONG = ba góc servo tới góc gợi ý (kẹp không tính, góc là góc lệnh); không có camera xác nhận vật được nhấc | "Thành công = ba servo tới góc gợi ý" |
| Bất kỳ **tỉ lệ thành công** nào (VD "9/10", "90%") | chưa có lần đếm nào trên cánh tay thật | "Chưa đo" |
| "Mô hình đã chính xác dưới 1 cm" | 8,5 mm là sai số khớp trên **chính 10 mẫu** (bỏ-một-mẫu 11,6 mm), chỉ cho tờ giấy cũ và vị trí robot lúc đo; chưa kiểm bằng cách bấm theo gợi ý trên cánh tay thật | "Sai số khớp 8,5 mm trên 10 lần ôm (bỏ-một-mẫu 11,6 mm); chưa thử bấm theo gợi ý trên cánh tay thật" |
| "Hiệu chỉnh dùng cho mọi tờ giấy / mọi vị trí robot" | `calibration.json` gắn với tờ giấy và chỗ đặt robot lúc đo | "Đổi tờ giấy hoặc dời robot thì phải đo lại" |
| "Servo hết nóng", "nhiệt độ giảm N°C" | chưa đo nhiệt độ | "Đã thêm ngắt xung, giới hạn góc và phím nghỉ; chưa đo nhiệt độ" |
| "Kẹp giữ cốc chắc", "nhấc cốc ổn định" | cốc thon bị đẩy ra ở 150–160°; cốc đổ khoảng 3 lần trong buổi 20:32–20:36 | "Kẹp chưa giữ chắc cốc thon nên đề tài chỉ xét ba góc servo" |
| S1/S2, "5 bước", Auto-Step, `attempts.csv`, phím `Y`/`E`, cửa sổ HƯỚNG DẪN GẮP như tính năng đang có | đã bỏ khi đơn giản hóa | chỉ nhắc ở phụ lục I như lịch sử, có sao lưu |
| "Phím `A` quay đế sang trái" | trên màn hình và slide, trái / phải **nhìn theo cam NGANG (MacBook)**: `A` = sang phải, `D` = sang trái | "A sang phải, D sang trái, nhìn theo cam ngang" |
| MQTT, dashboard, ESP32, 6 servo, FSR, YOLO26 là "đã làm" | chỉ có trong kế hoạch | chỉ nhắc ở phụ lục J như "điều chỉnh so với kế hoạch" |
| "Tìm vật bằng YOLO" | YOLO đã bỏ ngày 10/11; chương trình chỉ tách màu | "Tìm vật bằng tách màu trên ảnh phẳng của tờ giấy" |
| "Cốc nằm ở mép tầm với", "dời cốc gần đế 3 cm" | đã bị đính chính 20:25 | không nhắc |
| "Cần 155–165° để kẹp cốc" | ngoại suy từ 3 điểm, chưa xác nhận | "Giới hạn kẹp 160°; cốc thon vẫn bị đẩy ra" |
| "Phím Z chưa nạp" | **đã nạp và kiểm** lúc 21:42 và 21:54 | "Phím Z (nghỉ cả 4 servo) đã nạp và kiểm trên mạch" |
| Ảnh AI ở slide kết quả hay bằng chứng | gây hiểu nhầm | ảnh AI chỉ ở slide 2 và 14 và luôn ghi "Minh họa (AI)" |
| Gọi ảnh `ui_screen_*` là "lần chạy trực tiếp" | đó là màn hình thật chạy trên ảnh đã lưu, cánh tay mô phỏng | "Chạy trên ảnh thật đã lưu, cánh tay mô phỏng" |

## 15. Cần bạn xác nhận (không suy ra được từ máy)

1. Tên môn học hoặc sự kiện, ngày giờ, địa điểm, thời lượng được phép.
2. Tên và vai trò các thành viên; ai nói slide nào; ~~"nhóm 1 · điều khiển" và "nhóm 2 · success" là hai phần mã hay hai nhóm người?~~ Ngày 11/11 mã đổi tên thành **khối điều khiển / khối success** (slide gọi chúng là nhóm 1 và nhóm 2).
3. ~~Đã commit và push mã nguồn mới lên GitHub chưa?~~ Đã xong: `main` = `e3f2d85` (03/11/2026) có bản hai khối; slide 15 trỏ tới repo.
4. Giảng viên có **bắt buộc dashboard IoT / MQTT** hoặc **mô hình học máy** không (kế hoạch 28/10 còn hỏi điều này).
5. **Đã chạy bản mới trực tiếp với cánh tay thật chưa?** Nếu rồi, cho mình số `Thanh cong` và ảnh màn hình để đổi các dòng "chưa" ở slide 9, 11, 13.
6. Tờ giấy đang dùng là tờ cũ (in nhỏ) hay tờ mới? Hiệu chỉnh hiện tại chỉ đúng cho tờ cũ.
7. Có quay được video 20–30 giây không (slide 10).

## 16. Tái tạo các số tính được

Chạy từ thư mục dự án; chỉ đọc mã và `calibration.json`, **không** đụng camera hay cổng USB:

```bash
.venv/bin/python -B - <<'EOF'
import math, control as c
from calibration import apply_calibration

# 1. Mô hình MẶC ĐỊNH (chưa nạp calibration.json) trên ba lần ôm đầu: servo -> đầu kẹp theo mô hình, so với cốc đo bằng camera
hugs = {"20:32": ((85, 60, 90), (16.9, 14.4)), "20:46": ((80, 70, 75), (13.3, 14.0)), "21:03": ((75, 85, 50), (10.8, 7.7))}
for name, (servo, cup) in hugs.items():
    x, y, z = c.predict_tip(servo)
    print(name, servo, "-> (%.1f, %.1f) cm; cốc %s; lệch %.1f cm" % (x, y, cup, math.hypot(x - cup[0], y - cup[1])))   # 5.4, 3.5, 5.9

# 2. Nạp calibration.json rồi tính gợi ý cho cốc ở (20,1; 7,4) cm
apply_calibration(c.ARM_CONFIG)
rx, ry = c.table_cm_to_robot_mm(20.1, 7.4)                                  # -> 240, -73 (mm)
ik = c.ik_4dof_joint(rx, ry, c.GRASP_Z_MM)
goal = c.joint_to_servo(ik["theta1_deg"], ik["theta2_deg"], ik["theta3_deg"])
print("gợi ý", goal)                                                        # [74, 58, 90]
for m in c.plan_moves([90, 90, 90, 95], goal):
    print(m.label, m.key, m.steps, m.words, m.degrees)                      # D x8 (16°), S x16 (32°), khuỷu không phím
for pose in ((72, 54, 92), (74, 60, 86)):
    print(pose, "-> (%.1f, %.1f) cm" % c.predict_tip(pose)[:2])             # (20.6, 7.5) và (19.6, 7.8)
EOF
```

## 17. Khối kiểm tự động (đọc bởi `tools/check_facts.py`)

Mỗi dòng `tên = giá trị` được so với mã hiện tại. Sửa mã thì chạy `check_facts.py`; dòng nào báo `LỆCH` thì sửa ở **đây trước**, rồi sửa `build_slides.py`.

```facts
STEP_ARM = 2
STEP_GRIP = 5
GRIP_CLOSE_LIMIT = 160
GRIP_IDLE_RELAX_MS = 5000
GRIP_HOLD_MAX_MS = 60000
JSON_PERIOD_MS = 200
TOLERANCE_STEPS = 1
HOLD_S = 1.0
SERVO_STEPS = base:2 shoulder:2 elbow:2 grip:5
SERVO_LIMITS_GRIP = 95 160
GRASP_Z_MM = 25.0
ARM_DEFAULT = d1:70 L2:105 L3:100 L4_r:65 L4_z:25 theta2_90:45 theta3_90:-45
CAM_HEIGHT_CM = 46.0
CALIB_BASE = 13.83 31.67 -92.4
CALIB_THETA = 60.2 -58.6
CALIB_CLAW = 183.7 0.0 0.0
CALIB_FIT = n:10 rms:8.5 loo:11.6
PY_LINES = 823
FIRMWARE_LINES = 208
HUG_ERR_CM = 5.4 3.5 5.9
GOAL_CUP_20_1_7_4 = 74 58 90
KEYS_FROM_HOME = d:8 s:16
```

Ba dòng cuối chỉ được kiểm khi chạy `check_facts.py --deep`.
