DuongNAD/Project_IoT/slides/KetLuan.pptx

ĐỒ ÁN IOT · NHÓM 3

Kết luận

Qua đề tài này, nhóm hiểu rõ hơn cách thị giác máy tính xác định vị trí vật trong thế giới thật: dùng tờ A4 in mã ArUco làm hệ tọa độ, đổi pixel sang xăng-ti-mét bằng homography và tách vật theo màu. Nhóm cũng nắm được cách tính góc cho cánh tay 4 bậc tự do bằng động học ngược, và cách Arduino Uno, mạch PCA9685 và servo MG996R phối hợp với nhau. Khi ghép các phần lại, nhóm học được cách tìm và sửa lỗi tích hợp như thứ tự camera thay đổi hay Arduino tự khởi động lại, cách hiệu chỉnh mô hình từ số đo thật Đề tài là nền tảng để nhóm phát triển các hệ thống nhúng và IoT phức tạp hơn, như điều khiển vòng kín bằng camera.

Hệ thống hỗ trợ gắp vật cho cánh tay robot bằng computer vision

Notes: Để kết luận, em xin nói về những gì nhóm học được qua đề tài.

Về thị giác máy tính, nhóm hiểu cách xác định vị trí vật trong thế giới thật: tờ A4 in bốn mã ArUco làm hệ tọa độ chung, homography đổi pixel sang xăng-ti-mét, và tách vật theo màu. Về điều khiển, nhóm nắm được cách tính góc cho cánh tay bốn bậc tự do bằng động học ngược, và cách Arduino Uno, mạch PCA9685 và servo MG996R phối hợp với nhau.

Khi ghép các phần lại, nhóm gặp những lỗi chỉ xuất hiện khi chạy cả hệ thống: thứ tự camera trên macOS thay đổi giữa các lần chạy, và Arduino tự khởi động lại khi cổng USB được mở lại. Nhóm cũng học cách hiệu chỉnh mô hình cánh tay từ số đo thật.

Đề tài là nền tảng để nhóm phát triển các hệ thống nhúng và IoT phức tạp hơn, ví dụ dùng camera đo vị trí đầu kẹp để điều khiển vòng kín.

Nếu được hỏi: phần khó nhất là gì? Làm cho mô hình hình học khớp với cánh tay thật: mô hình mặc định lệch 3,5 đến 5,9 cm, sau hiệu chỉnh từ 10 mẫu còn sai số khớp 8,5 mm.

Nguồn: 05_SO_LIEU_VA_NGUON.md mục 2, 8, 10, 11; README.md.

## Slide 2

ĐỒ ÁN IOT · NHÓM 3

Tóm tắt và hỏi đáp

1

Vị trí vật theo cm

Tờ A4 in 4 mã ArUco là hệ tọa độ chung cho hai camera; tách màu tìm vật, bù thị sai

TIẾP THEO

- Chạy bản mới trên cánh tay thật, đếm số lần XONG
- Tay kẹp giữ chắc vật thon
- Đo vị trí đầu kẹp bằng camera (vòng kín)

2

Bấm phím nào, mấy lần

Động học ngược tính góc 3 servo; mô hình hiệu chỉnh từ 10 mẫu, sai số khớp 8,5 mm

3

Đã tới đúng góc chưa

Ba servo lệch ≤ 2°, giữ 1 giây; XONG là góc đã ra lệnh, không phải đã gắp

Cảm ơn thầy cô và các bạn đã lắng nghe

Nguyễn Anh Dương · Nguyễn Minh Hiển · Trần Trọng Nghĩa · Phạm Trương Vũ · hỏi đáp

github.com/DuongNAD/Project_IoT

Notes: Tóm tắt lại, hệ thống của nhóm trả lời ba câu hỏi khi điều khiển cánh tay bằng bàn phím.

Một: vật ở đâu. Tờ A4 in bốn mã ArUco là hệ tọa độ chung cho hai camera; chương trình tách màu để tìm vật và bù thị sai, cho vị trí theo xăng-ti-mét. Hai: bấm phím nào, mấy lần. Động học ngược tính góc ba servo; mô hình cánh tay được hiệu chỉnh từ 10 mẫu, sai số khớp 8,5 mm. Ba: đã tới đúng góc chưa. Ba servo lệch không quá 2 độ và giữ 1 giây thì báo XONG; XONG nghĩa là góc đã ra lệnh tới góc gợi ý, không có nghĩa là đã gắp được vật.

Việc tiếp theo: chạy bản mới trên cánh tay thật để có số lần XONG đầu tiên, cải thiện tay kẹp để giữ chắc vật thon, và đo vị trí đầu kẹp bằng camera để có phản hồi vòng kín.

Nhóm em cảm ơn thầy cô và các bạn đã lắng nghe, và xin nhận câu hỏi; câu hỏi phần nào thì thành viên phụ trách phần đó trả lời. Mã nguồn có trên GitHub theo đường dẫn trên slide.

Nếu được hỏi: hệ thống đã gắp thành công bao nhiêu lần? Nhóm chưa có số liệu về tỉ lệ thành công. Trong buổi thử ngày 2/11, người điều khiển bấm phím đã kẹp và chuyển được cốc. Vì sao không cho chương trình tự điều khiển? Mô hình chỉ khớp cánh tay thật ở mức khoảng 1 cm và tay kẹp chưa giữ chắc vật thon, nên nhóm chọn hướng hỗ trợ người điều khiển.

Nguồn: README.md; 05_SO_LIEU_VA_NGUON.md mục 4 đến 8, 14.
