DuongNAD/Project_IoT/slides/Phan2_LuongDuLieu_Code.pptx

PHẦN 02

02

PHẦN NÀY GỒM

Sơ đồ luồng dữ liệu

Vòng lặp mỗi khung hình · main.py

Đọc camera · cameras.py

Hệ tọa độ từ tờ A4 · vision.py

Nhận diện vật · vision.py

Điều kiện hoàn thành · success.py

Màn hình · screen.py

Thử nghiệm, kết quả, hạn chế

01

02

03

Computer vision &
Hỗ trợ gắp

Nguyễn Anh Dương – Phạm Trương Vũ

04

05

06

07

08

01 Linh kiện

02 Computer vision & Hỗ trợ gắp

03 Code điều khiển

Notes: Phần hai do Nguyễn Anh Dương và Phạm Trương Vũ trình bày. Nguyễn Anh Dương trình bày computer vision: sơ đồ luồng dữ liệu của cả chương trình, vòng lặp mỗi khung hình, cách đọc camera, hệ tọa độ từ tờ A4 và nhận diện vật. Phạm Trương Vũ trình bày hỗ trợ gắp: điều kiện hoàn thành, màn hình, rồi thử nghiệm, cách kiểm tra bằng mắt, kết quả và hạn chế.

Mỗi slide code lấy nguyên văn từ mã nguồn trên GitHub, có ghi tên tệp và số dòng ở góc trên khung code.

Nguồn: main.py, cameras.py, vision.py, success.py, screen.py (nhánh main).

## Slide 2

02 · COMPUTER VISION & HỖ TRỢ GẮP

Sơ đồ luồng dữ liệu

Nguyễn Anh Dương · Computer vision

CAMERA · cameras.py

Camera.get_raw_frame()

Dương

mảng numpy cao × rộng × 3 (BGR), mỗi camera một ảnh; cam TRÊN để tìm vật, cam NGANG để người nhìn

ảnh

VISION · vision.py

Vision.process_frame(ảnh)

ảnh (BGR)

Dương

vision.objects

danh sách vật [{"name", "x_cm", "y_cm", "px"}]: tọa độ trên tờ A4 (cm), đã bù thị sai

vision.objects

ĐIỀU KHIỂN · control.py

Control.update(objects)

phần 3

Arduino · USB 9600

phím ↓ · JSON góc ↑

plan

now: 4 góc servo hiện tại · goal: 3 góc cần tới · moves: phím, số lần, hướng, độ · found, reachable

Plan

SUCCESS · success.py

Success.update(plan)

Vũ

state, done, joints_ok, next_move, remaining (số lần bấm còn lại), count

Lặp lại mỗi khung hình: main.py · App.render()

Result

MÀN HÌNH · screen.py

build_screen(..., plan, result)

result

Vũ

Notes: Đây là sơ đồ luồng dữ liệu của chương trình trên laptop. Mỗi khung hình, dữ liệu đi một chiều qua năm khối, đọc từ trên xuống; mũi tên ghi tên biến thật trong mã.

Hai camera cho ảnh. vision.py dò bốn mã ArUco để có lưới tọa độ, rồi tìm vật có màu trên ảnh cam TRÊN; kết quả là vision.objects, danh sách vật với tọa độ X, Y theo xăng-ti-mét trên tờ A4. control.py, phần ba, tính góc servo cần tới và phím cần bấm, đóng gói thành một đối tượng Plan; góc cần tới chỉ có sau khi người điều khiển bấm R để chụp vị trí vật. success.py chỉ đọc Plan và trả về Result: đã tới chưa, còn bao nhiêu lần bấm, đã thành công mấy lần. screen.py vẽ hai camera và hai ô chữ từ Plan và Result.

Bên phải: người dùng bấm phím, phím được gửi xuống Arduino qua USB 9600 baud; Arduino gửi lại góc servo dạng JSON năm lần mỗi giây, khối điều khiển dùng góc này làm góc hiện tại. Khi điều khiển từ xa, máy Dell xem đúng màn hình này qua Wi-Fi (share.py) và gửi phím thẳng tới Arduino qua Bluetooth HC-05; phím R vẫn bấm trên Mac.

Nếu được hỏi: vì sao chia thành các khối như vậy? Mỗi khối chỉ nhận một loại dữ liệu và trả một loại dữ liệu, nên làm và sửa riêng được từng khối; ví dụ success.py chỉ cần một Plan, không cần camera hay Arduino. Dữ liệu có được lưu lại không? Không; mỗi khung hình tính lại từ đầu, chỉ có vị trí mã ArUco, đích đã chụp bằng phím R và số lần thành công được nhớ.

Nguồn: main.py:73-80; success.py:16-22; robot_arm_4dof.ino (gói JSON mỗi 200 ms).

## Slide 3

02 · COMPUTER VISION & HỖ TRỢ GẮP

Vòng lặp mỗi khung hình · main.py

Nguyễn Anh Dương · Computer vision

1

Đọc khung camera

2

vision

3

control → Plan

4

success → Result

5

Vẽ màn hình

main.py · dòng 56–63, 73–80

def _frame(self, cam, mode):
"""Khung camera đã vẽ lớp phủ (mã ArUco, lưới 5 cm, vật). Mất tín hiệu: hiện "Dang cho tin hieu" và
quên vật cũ."""
raw = cam.get_raw_frame()
if raw is None:
if mode == "topdown":
self.vision.objects = [] # Không có hình thì không gợi ý theo vật đã thấy từ trước
return cam.waiting_image()
return self.vision.process_frame(raw, mode=mode)
def render(self):
"""Dựng một khung màn hình: (ảnh màn hình, Plan của control, Result của success)."""
left, right = self._frame(self.cam_side, "side"), self._frame(self.cam_top, "topdown")
plan = self.control.update(self.vision.objects) # Khối điều khiển: vật ở đâu -> góc cần tới -> bấm
phím gì
result = self.success.update(plan) # Khối success: đã tới chưa
titles = (f"CAM NGANG: {self.cam_side.label}", f"CAM TREN: {self.cam_top.label} (nhin tu tren)")
screen = build_screen(self._with_target(left, "side", plan), self._with_target(right, "topdown",
plan), plan, result, titles=titles)
return screen, plan, result

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
Notes: Đây là phần chạy ở mỗi khung hình trong main.py, nối các khối của sơ đồ trước.

Hàm _frame lấy ảnh của một camera. Số 1: đọc khung mới nhất của camera; nếu chưa có hình hoặc mất tín hiệu thì hiện ô "Dang cho tin hieu" và xóa danh sách vật cũ, để không gợi ý theo dữ liệu đã cũ. Số 2: ảnh được đưa vào vision.process_frame để dò mã ArUco và tìm vật.

Hàm render: số 3, khối điều khiển nhận vision.objects và trả về plan; số 4, khối success nhận plan và trả về result; số 5, build_screen vẽ màn hình từ hai ảnh camera, plan và result.

Nếu được hỏi: một giây chạy bao nhiêu khung? Tùy camera và máy: mỗi vòng đọc một khung của mỗi camera rồi xử lý ngay. Mất tín hiệu thì sao? Ô camera hiện "Dang cho tin hieu"; cắm lại cáp rồi chạy lại chương trình.

Nguồn: main.py:56-63,73-80.

## Slide 4

02 · COMPUTER VISION & HỖ TRỢ GẮP

Đọc camera · cameras.py

Nguyễn Anh Dương · Computer vision

1

Ảnh tĩnh để chạy thử

2

Mở camera theo chỉ số

3

Đọc khung mới nhất

cameras.py · dòng 19–28, 30–35

def __init__(self, source, role):
self.role = role
self.label = f"camera {source}" if source.isdigit() else os.path.basename(source)
self.cap = self.image = None
if source.lower().endswith((".png", ".jpg", ".jpeg")): # Ảnh tĩnh: lần đọc nào cũng trả lại đúng
ảnh đó
self.image = cv2.imread(source)
elif source.isdigit(): # Windows mở qua DirectShow (cv2.CAP_DSHOW), macOS dùng mặc định của OpenCV
index = int(source)
self.cap = cv2.VideoCapture(index, cv2.CAP_DSHOW) if sys.platform == "win32" else
cv2.VideoCapture(index)
self.cap.set(cv2.CAP_PROP_BUFFERSIZE, 1) # Giữ ít khung trong bộ đệm để hình không bị trễ
def get_raw_frame(self):
"""Khung mới nhất của camera, None nếu chưa mở được camera hoặc mất tín hiệu."""
if self.image is not None:
return self.image.copy()
ok, frame = self.cap.read() if self.cap is not None else (False, None)
return frame if ok else None

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
Notes: Phần này trả lời: hai camera được đọc thế nào.

Số 1: nguồn có thể là một ảnh .png hoặc .jpg; lần đọc nào cũng trả lại đúng ảnh đó, để chạy thử không cần camera. Số 2: camera mở theo chỉ số OpenCV: số ghi ở --top là cam TRÊN, số ghi ở --side là cam NGANG; trên Windows mở qua DirectShow. Bộ đệm chỉ giữ một khung để hình không bị trễ. Số 3: mỗi vòng lặp, get_raw_frame đọc khung mới nhất; không có hình thì trả về None và main.py hiện ô "Dang cho tin hieu".

Nếu được hỏi: camera nào là cam TRÊN? Chọn bằng chỉ số khi chạy, ví dụ --top 0 --side 1; macOS có thể đổi thứ tự camera giữa các lần chạy, nên nhìn hai khung hình, thấy đảo thì chạy lại với hai số đổi chỗ. Rút cáp camera thì sao? Ô camera hiện "Dang cho tin hieu"; cắm lại rồi chạy lại chương trình, bản này không tự mở lại camera.

Nguồn: cameras.py:19-28,30-35.

## Slide 5

02 · COMPUTER VISION & HỖ TRỢ GẮP

Hệ tọa độ từ tờ A4 · vision.py

Nguyễn Anh Dương · Computer vision

1

1

Góc mã theo cm

2

Dò mã ArUco

3

Nhớ mã bị che

4

Tính homography

vision.py · dòng 26–31, 45–62

def marker_corners_cm(i):
"""4 góc (cm) của mã ID i (0-3) theo thứ tự OpenCV trả về: trên-trái, trên-phải, dưới-phải, dưới-trái."""
s, m = MARKER_SIZE_CM, MARKER_MARGIN_CM
x = m if i in (0, 3) else SHEET_W_CM - m - s
y = m if i in (0, 1) else SHEET_H_CM - m - s
return np.float32([[x, y], [x + s, y], [x + s, y + s], [x, y + s]])
class Sheet:
def __init__(self):
self.markers = {} # ID mã -> 4 góc pixel lần cuối thấy (mã đang bị che thì dùng vị trí đã nhớ)
self.n_seen = 0 # Số mã thấy trong khung vừa xử lý
self.H_px2cm = self.H_cm2px = None
def update(self, frame):
corners, ids, _ = DETECTOR.detectMarkers(frame)
ids = [] if ids is None else ids.ravel()
seen = {int(i): c.reshape(4, 2) for c, i in zip(corners, ids) if i in (0, 1, 2, 3)}
self.markers.update(seen)
self.n_seen = len(seen)
if len(self.markers) >= 2: # 2 mã = 8 góc, đủ tính homography
px = np.concatenate(list(self.markers.values()))
cm = np.concatenate([marker_corners_cm(i) for i in self.markers])
self.H_px2cm = cv2.findHomography(px, cm)[0]
self.H_cm2px = np.linalg.inv(self.H_px2cm)
return corners

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
Notes: Phần này dựng hệ tọa độ xăng-ti-mét trên tờ A4 cho cả hai camera.

Số 1: marker_corners_cm cho tọa độ thật bốn góc của mỗi mã ArUco trên tờ giấy: mã cạnh 2,8 cm, cách mép giấy 0,25 cm, gốc tọa độ ở góc ngoài mã số 0. Số 2: mỗi khung hình, OpenCV dò các mã ArUco và trả về bốn góc pixel của từng mã. Số 3: vị trí mã được nhớ trong self.markers; khi cánh tay che mất một vài mã, chương trình dùng vị trí đã nhớ. Số 4: có từ hai mã trở lên, tức tám cặp điểm pixel và xăng-ti-mét, findHomography tính ma trận đổi pixel sang xăng-ti-mét; ma trận nghịch đảo đổi ngược lại để vẽ lưới.

Nếu được hỏi: vì sao hai mã là đủ? Homography cần ít nhất bốn cặp điểm; mỗi mã cho bốn góc, hai mã cho tám. Dời camera thì sao? Bấm phím U để quên vị trí mã đã nhớ và dò lại.

Nguồn: vision.py:26-31,45-62.

## Slide 6

02 · COMPUTER VISION

Nhận diện vật

Nguyễn Anh Dương · Computer vision

Ảnh phẳng tờ A4

Homography, 8 pixel / cm

BƯỚC 1

Tách vùng có màu

Độ bão hòa ≥ 90, đủ sáng

BƯỚC 2

Lọc vật

Bỏ khối < 1,5 cm² hoặc > 50 cm², sát mép giấy

BƯỚC 3

Cam TRÊN, ảnh đã lưu: vòng xanh quanh cốc kèm X, Y (cm) (giao diện bản trước)

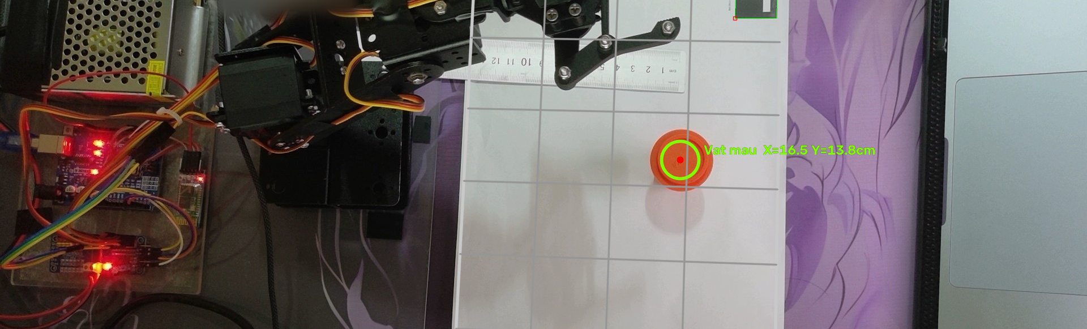
[picture p3: figure]

CHỌN MỤC TIÊU

- Ưu tiên vật gần đế nhất
- R chụp vị trí làm đích
- Góc cần tới tính một lần
- Vật bị dời: bấm R lại

Notes: Sau khi có hệ tọa độ, chương trình tìm vật bằng cách tách màu, gồm ba bước. Bước một: dùng homography dựng ảnh phẳng của tờ A4, mỗi xăng-ti-mét là 8 pixel. Bước hai: giữ các vùng có màu đậm như cốc đỏ; giấy trắng, bóng xám và thân robot đen bị bỏ. Bước ba: lọc vật. Khối nhỏ hơn 1,5 cm² là nhiễu hoặc dây điện; khối lớn hơn 50 cm² là bàn tay, không lọt miệng kẹp; khối sát mép giấy là vật thò từ ngoài vào.

Tâm của khối màu đổi ra xăng-ti-mét, rồi được bù thị sai như slide trước. Ảnh bên dưới là khung camera trên: vòng xanh quanh cốc kèm tọa độ X, Y.

Khi có nhiều vật, vật gần đế nhất được chọn. Người điều khiển bấm phím R để chụp vị trí vật lúc đó làm đích; góc cần tới được tính một lần và không theo camera nữa, nên khi tay kẹp che hoặc đẩy lệch vật, đích không đổi. Vật bị dời thì bấm R lại.

Slide sau là đoạn code thật của ba bước này trong vision.py.

Nếu được hỏi: vì sao không dùng YOLO? Bản trước có YOLO11 nhưng hay nhận nhầm bộ phận robot, nên nhóm bỏ để mã đơn giản; tách màu đủ cho cốc màu đậm. Vật màu trắng hoặc xám thì sao? Chưa nhận được; đây là một hạn chế. Vì sao phải bấm R mà không theo camera liên tục? Khi tay kẹp tiến vào, nó che và đẩy cốc nên vị trí camera thấy bị nhảy; chụp một lần thì đích đứng yên và mã đơn giản hơn.

Nguồn: vision.py:68-91; control.py:253-263 (phím R).

## Slide 7

02 · COMPUTER VISION & HỖ TRỢ GẮP

Nhận diện vật · vision.py

Nguyễn Anh Dương · Computer vision

1

Ảnh phẳng tờ A4

2

Tách vùng có màu

3

Lọc vật

4

Bù thị sai

vision.py · dòng 68–91

def find_objects(frame, sheet):
"""Danh sách vật [{"name", "x_cm", "y_cm", "px"}]; px là tâm vật trên ảnh, để vẽ."""
W, H = round(SHEET_W_CM * PPC), round(SHEET_H_CM * PPC)
flat = cv2.warpPerspective(frame, np.diag([PPC, PPC, 1.0]) @ sheet.H_px2cm, (W, H)) # Ảnh phẳng tờ giấy: 1
cm = PPC pixel
hsv = cv2.cvtColor(flat, cv2.COLOR_BGR2HSV)
colored = cv2.inRange(hsv, (0, 90, 60), (180, 255, 255)) # Có màu: độ bão hòa >= 90, đủ
sáng
colored = cv2.morphologyEx(colored, cv2.MORPH_OPEN, np.ones((5, 5), np.uint8)) # Bỏ nhiễu và dây điện mảnh
h, w = frame.shape[:2]
nadir = px_to_cm(sheet.H_px2cm, w / 2, h / 2) # Điểm cam TREN nhìn thẳng xuống = tâm ảnh
k = (CAM_HEIGHT_CM - OBJECT_HEIGHT_CM) / CAM_HEIGHT_CM if CAM_HEIGHT_CM > 0 else 1.0
objects = []
for c in cv2.findContours(colored, cv2.RETR_EXTERNAL, cv2.CHAIN_APPROX_SIMPLE)[0]:
x, y, bw, bh = cv2.boundingRect(c)
if not 1.5 <= cv2.contourArea(c) / PPC**2 <= 50:
continue # Nhỏ hơn 1,5 cm² là nhiễu; to hơn 50 cm² là bàn tay, không lọt miệng kẹp
if x < PPC or y < PPC or x + bw > W - PPC or y + bh > H - PPC:
continue # Sát mép giấy (dưới 1 cm): tay hoặc đồ vật thò từ ngoài vào
m = cv2.moments(c)
top = (m["m10"] / m["m00"] / PPC, m["m01"] / m["m00"] / PPC) # Tâm khối màu (cm) = nắp vật nhìn từ trên
# Bù thị sai: vị trí thật = nadir + (vị trí đo - nadir) * (H - h) / H

x_cm, y_cm = (nadir[j] + (top[j] - nadir[j]) * k for j in (0, 1))
objects.append({"name": "Vat mau", "x_cm": x_cm, "y_cm": y_cm, "px": cm_to_px(sheet.H_cm2px, *top)})
return objects

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
Notes: Sau khi có homography, find_objects tìm vật trên ảnh cam TRÊN.

Số 1: warpPerspective dựng ảnh phẳng của tờ A4, mỗi xăng-ti-mét là 8 pixel, nên mọi phép đo sau đó tính thẳng bằng xăng-ti-mét. Số 2: chuyển sang không gian màu HSV và giữ các điểm có độ bão hòa từ 90 trở lên; giấy trắng, bóng xám và thân robot đen bị bỏ. Phép mở ảnh bỏ nhiễu và dây điện mảnh.

Số 3: lọc từng khối màu. Nhỏ hơn 1,5 cm² là nhiễu; lớn hơn 50 cm² là bàn tay, không lọt miệng kẹp; cách mép giấy dưới 1 cm là vật thò từ ngoài vào.

Số 4: bù thị sai. Cam TRÊN treo cao 46 cm, nắp cốc cao 5 cm nên bị lệch ra xa tâm ảnh. Vị trí thật bằng điểm nhìn thẳng xuống cộng khoảng cách đo được nhân với (46 − 5) / 46. Ở một vị trí đã đo, sai lệch giữa hai camera giảm từ 1,2 cm xuống 0,2 cm.

Nếu được hỏi: vật màu trắng hoặc xám thì sao? Chưa nhận được, đây là một hạn chế. Vì sao không dùng YOLO? Bản trước có YOLO nhưng hay nhận nhầm bộ phận robot, nên nhóm bỏ để mã đơn giản.

Nguồn: vision.py:68-91.

## Slide 8

02 · COMPUTER VISION & HỖ TRỢ GẮP

Điều kiện hoàn thành · success.py

Phạm Trương Vũ · Hỗ trợ gắp

1

1

Lệch ≤ 2°, giữ 1 giây

2

Servo nào đã tới

3

Trạng thái

4

Đếm lần thành công

success.py · dòng 11–12, 25–35, 46–56

TOLERANCE_STEPS = 1 # Lệch không quá 1 bước bấm (2°) là "đã tới": mô hình hình học chỉ chính xác cỡ đó
HOLD_S = 1.0 # Giữ đúng liên tục 1 giây mới đếm 1 lần thành công (khỏi đếm khi chỉ lướt qua)
def check(plan):
"""Đánh giá một Plan (không nhớ gì giữa hai lần gọi)."""
joints = [m.degrees <= TOLERANCE_STEPS * m.step for m in plan.moves]
pending = [m for m, ok in zip(plan.moves, joints) if not ok]
if not plan.found:
state = "no_target"
elif not plan.reachable:
state = "unreachable"
else:
state = "moving" if pending else "done"
return Result(state, state == "done", joints, pending[0] if pending else None, sum(m.steps for m in pending))
def update(self, plan, now=None):
now = time.time() if now is None else now
result = check(plan)
if result.done:
self.since = now if self.since is None else self.since
if not self.counted and now - self.since >= HOLD_S:
self.count, self.counted = self.count + 1, True
else:
self.since, self.counted = None, False
result.count = self.count
return result

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
Notes: Em là Phạm Trương Vũ, trình bày phần hỗ trợ gắp, bắt đầu từ success.py.

Số 1: hai hằng số. Một servo được coi là đã tới nếu lệch không quá một bước bấm, tức 2 độ; cả ba servo phải giữ đúng liên tục 1 giây mới tính một lần thành công. Số 2: hàm check đọc Plan của khối điều khiển, so từng servo đế, vai, khuỷu với góc gợi ý, và cộng số lần bấm còn lại. Số 3: xếp trạng thái theo ưu tiên: chưa có đích (chưa bấm R), vật ngoài tầm với, còn phải bấm, hoặc xong. Hàm check không nhớ gì giữa hai lần gọi.

Số 4: lớp Success gọi check mỗi khung hình và đếm số lần thành công: bắt đầu tính giờ khi vừa xong, đủ 1 giây thì cộng một, giữ thêm không cộng nữa, rời góc thì tính lại từ đầu.

Nếu được hỏi: vì sao không xét tay kẹp? Kẹp chưa giữ chắc vật thon, nên đề tài chỉ xét ba góc servo. XONG có nghĩa là đã gắp được không? Không; XONG nghĩa là ba góc đã ra lệnh tới góc gợi ý, vì MG996R không báo vị trí thật.

Nguồn: success.py:11-12,25-35,46-56.

## Slide 9

02 · COMPUTER VISION & HỖ TRỢ GẮP

Màn hình · screen.py

Phạm Trương Vũ · Hỗ trợ gắp

1

Hai camera

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
Ô 1: lệnh bấm phím

3

Ba dòng servo

4

Ô 2: XONG / CHUA XONG

screen.py · dòng 45–70

def build_screen(view_left, view_right, plan, result, titles=("CAM NGANG", "CAM TREN")):
img = np.full((SCREEN_H, SCREEN_W, 3), 30, np.uint8)
img[:CAM_H] = np.hstack([cam_cell(view_left, titles[0]), cam_cell(view_right, titles[1])])
y = CAM_H + 40
# Ô 1: ĐIỀU KHIỂN

put(img, "1. DIEU KHIEN (trai / phai nhin theo cam NGANG)", 20, y, 0.8, ORANGE)
if result.state == "moving":
m = result.next_move
put(img, f"BAM {m.key.upper()} x{m.steps}: {m.words} {m.degrees} do", 20, y + 50, 1.2, ORANGE, 3)
else:
put(img, MESSAGES[result.state], 20, y + 50)
for i, (m, ok) in enumerate(zip(plan.moves, result.joints_ok)): # Đế, vai, khuỷu
todo = "DA DUNG" if ok else f"bam {m.key.upper()} x{m.steps}"
put(img, f"{m.label}: {m.now} -> {m.goal} do {todo}", 20, y + 100 + 36 * i, 0.7, GREEN if ok else WHITE)
# Ô 2: SUCCESS

x = 840
put(img, "2. SUCCESS", x, y, 0.8, GREEN if result.done else ORANGE)
if result.done:
put(img, "XONG!", x, y + 70, 2.0, GREEN, 5)
else:
put(img, "CHUA XONG", x, y + 60, 1.2, ORANGE, 3)
if result.state == "moving":
put(img, f"con {result.remaining} lan bam", x, y + 100)
put(img, f"Thanh cong: {result.count} lan", x, y + 150)

1

2

3

4

Notes: screen.py chỉ vẽ, không tính gì; mọi chữ trên màn hình lấy từ Plan và Result.

Số 1: ghép hai ảnh camera thành hàng trên, mỗi ô 640 × 360. Số 2: ô một, điều khiển: nếu còn phải bấm thì hiện lệnh lớn, ví dụ "BAM S x15: HA XUONG 30 do"; các trạng thái khác hiện một câu nhắc. Số 3: ba dòng servo đế, vai, khuỷu với góc hiện tại, góc đích, và phím cần bấm; dòng đã tới ghi DA DUNG màu xanh. Số 4: ô hai, success: XONG màu xanh khi cả ba servo đã tới, không thì CHUA XONG kèm số lần bấm còn lại, và số lần thành công.

Nếu được hỏi: vì sao chữ không dấu? Phông chữ của OpenCV không vẽ được dấu tiếng Việt. Trái, phải theo hướng nào? Theo cam NGANG đặt trước robot: phím A sang phải, D sang trái.

Nguồn: screen.py:45-70.
