DuongNAD/Project_IoT/slides/Project_IoT_ThuyetTrinh.pptx

Ảnh từ hai camera của hệ thống · 02/11/2026

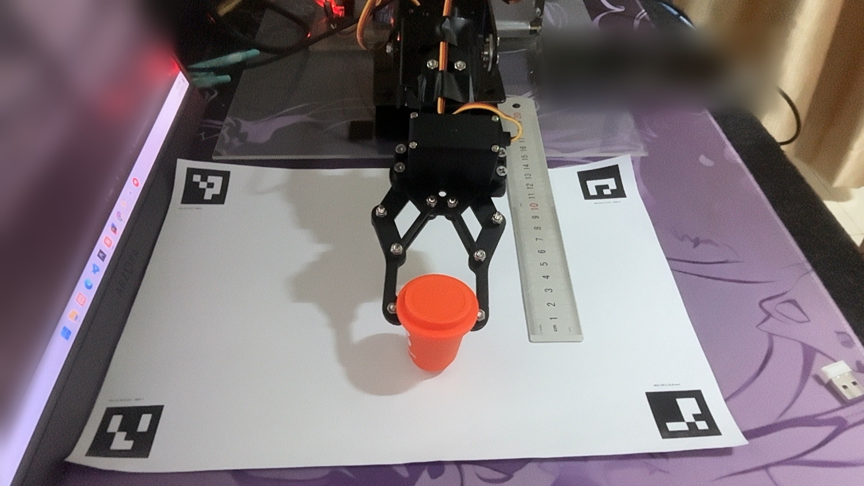
[picture p4: figure]

ĐỒ ÁN IOT · [MÔN HỌC] · [NGÀY BÁO CÁO]

Hệ thống hỗ trợ gắp vật cho cánh tay robot 4 bậc tự do bằng thị giác máy tính

Hai camera · gợi ý phím bấm · kiểm tra góc servo

NHÓM THỰC HIỆN

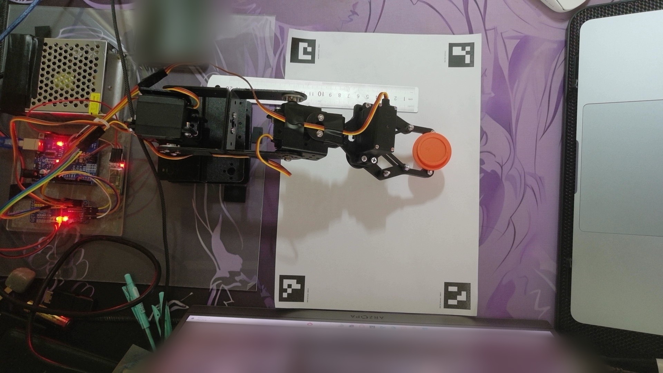
[picture p5: figure]

[Tên A]
Linh kiện

Phạm Trương Vũ
Hỗ trợ gắp

Nguyễn Anh Dương
Computer vision

[Tên C]
Code điều khiển

Giảng viên hướng dẫn: [...] · Lớp: [...]

Notes: Em chào thầy cô và các bạn. Nhóm em gồm bốn thành viên, xin trình bày đề tài: hệ thống hỗ trợ gắp vật cho cánh tay robot bốn bậc tự do bằng thị giác máy tính. Hai camera xác định vị trí vật; chương trình gợi ý phím cần bấm và kiểm tra ba servo đã tới góc gợi ý hay chưa.

Hai ảnh bên phải được chụp từ hai camera của hệ thống trong buổi thử ngày 2/11.

Nếu được hỏi: vì sao chọn đề tài này? [...điền lý do của nhóm].

Nguồn: ảnh demo_06_grip_side, demo_06_grip_top (khung cắt từ video buổi thử 02/11/2026, 20:32:52).

## Slide 2

NHÓM 4 NGƯỜI

Thành viên và phân công

01 · LINH KIỆN

[Tên A]

Linh kiện, sơ đồ mạch, lắp ráp cánh tay và camera

Arduino Uno · PCA9685 · MG996R

Slide 3–10 · ≈ 5 phút

02 · COMPUTER VISION

Nguyễn Anh Dương

Hệ tọa độ từ tờ A4, nhận diện vật

vision.py · cameras.py

Slide 11–13 · ≈ 2 phút

02 · HỖ TRỢ GẮP

Phạm Trương Vũ

Điều kiện hoàn thành, giao diện, thử nghiệm

success.py · screen.py

Slide 14–18 · ≈ 4 phút

03 · CODE ĐIỀU KHIỂN

[Tên C]

Firmware Arduino, động học ngược, lệnh bấm phím, hiệu chỉnh

robot_arm_4dof.ino · control.py

Slide 19–24 · ≈ 4 phút

Thứ tự trình bày: phần cứng → computer vision & hỗ trợ gắp → điều khiển

2

Notes: Nhóm có bốn thành viên. [Tên A] phụ trách linh kiện, sơ đồ mạch và lắp ráp. Nguyễn Anh Dương phụ trách computer vision: hệ tọa độ từ tờ A4 và nhận diện vật. Phạm Trương Vũ phụ trách hỗ trợ gắp: khối success, giao diện và thử nghiệm; Nguyễn Anh Dương và Phạm Trương Vũ cùng thực hiện và cùng trình bày phần hai. [Tên C] phụ trách firmware Arduino và code điều khiển trên laptop.

Bài trình bày gồm ba phần: phần cứng; computer vision và hỗ trợ gắp; code điều khiển. Mở đầu, [Tên A] trình bày bài toán, sơ đồ khối và phần linh kiện.

Nếu được hỏi: ai làm firmware? [Tên C]. Phần hai chia thế nào? Hai bạn làm chung; khi trình bày, Nguyễn Anh Dương nói phần computer vision, Phạm Trương Vũ nói phần hỗ trợ gắp.

Nguồn: README.md (các khối của mã); phân công do nhóm tự khai.

## Slide 3

MỞ ĐẦU

Bài toán

[Tên A] · Linh kiện

BA CÂU HỎI KHI ĐIỀU KHIỂN BẰNG BÀN PHÍM

Vật ở đâu trên bàn?

KHÓ KHĂN

Mỗi phím chỉ quay 2°
Khó ước lượng độ sâu bằng mắt
Cần mô hình khớp cánh tay thật

VÍ DỤ Ở SLIDE 22

1

Bấm phím nào, bao nhiêu lần?

02 · COMPUTER VISION

2

03 · ĐIỀU KHIỂN

Đã tới đúng góc chưa?

3

D

× 8

S

× 16

= 24 lần bấm

02 · HỖ TRỢ GẮP

Hệ thống gợi ý; người dùng bấm phím.

3

Notes: Em là [Tên A], phụ trách linh kiện. Em xin mở đầu bằng bài toán.

Cánh tay có bốn servo, điều khiển bằng bàn phím; mỗi lần bấm, một servo quay 2 độ. Người điều khiển cần biết ba điều: vật ở đâu, cần bấm phím nào và bao nhiêu lần, và cánh tay đã tới đúng góc chưa.

Khó khăn là mắt người khó ước lượng độ sâu, và mỗi bước chỉ 2 độ nên một lần tiếp cận có thể cần hơn 20 lần bấm, như ví dụ 24 lần ở phần điều khiển. Ngoài ra, gợi ý chỉ chính xác khi mô hình hình học khớp với cánh tay thật.

Hệ thống giải quyết ba câu hỏi bằng ba khối: computer vision, điều khiển và success. Hệ thống chỉ gợi ý; người dùng là người bấm phím.

Nếu được hỏi: vì sao không để chương trình tự điều khiển? Mô hình hình học hiện chỉ khớp cánh tay thật ở mức khoảng 1 cm và tay kẹp chưa giữ chắc vật thon, nên nhóm chọn hướng hỗ trợ người điều khiển. Bản trước có chế độ tự gửi phím; nhóm đã bỏ để mã nguồn đơn giản hơn.

Nguồn: README.md mục 3; control.py; success.py.

## Slide 4

MỞ ĐẦU

Sơ đồ khối hệ thống

[Tên A] · Linh kiện

người dùng bấm phím

CẢM BIẾN

Hai camera

OBSBOT (trên), MacBook (ngang)

NHÌN · vision.py

Tìm vật

ArUco, tách màu
→ (X, Y) cm

phím · USB 9600 baud

02

ĐIỀU KHIỂN · control.py

Điều khiển

góc 3 servo
→ phím cần bấm

03

SUCCESS · success.py

Success

kiểm tra góc 3 servo

02

MÀN HÌNH · screen.py

Hiển thị

lệnh bấm, kết quả

ảnh

(X, Y)

Plan

Result

PLAN NỐI HAI KHỐI

Góc hiện tại, góc cần tới, lệnh bấm. Khối điều khiển tạo, khối success đọc.

Arduino Uno

nhận phím, gửi JSON

JSON ~5 gói/giây

PCA9685

I²C 0x40 · xung 50 Hz

4 servo MG996R

đế · vai · khuỷu · kẹp

01

plan = self.control.update(self.vision.objects) # khối điều khiển
result = self.success.update(plan) # khối success
screen = build_screen(..., plan, result) # màn hình (main.py:76-79)

4

Notes: Đây là sơ đồ khối của hệ thống, đọc từ trái sang phải; số trên mỗi khối là phần trình bày tương ứng.

Hai camera cùng quan sát tờ A4: OBSBOT đặt phía trên để tính vị trí vật, camera MacBook đặt phía trước để quan sát độ cao của tay kẹp. Khối computer vision dò bốn mã ArUco để đổi pixel sang xăng-ti-mét, rồi tách màu để xác định vị trí X, Y của vật.

Khối điều khiển tính góc cần tới của ba servo và lập danh sách phím cần bấm. Khối success kiểm tra ba servo đã tới các góc đó chưa. Hai khối trao đổi qua một đối tượng duy nhất là Plan, nên có thể làm và sửa riêng từng khối. Ba dòng mã bên dưới là phần chương trình chạy ở mỗi khung hình.

Người dùng bấm phím theo gợi ý. Phím được gửi xuống Arduino qua USB ở 9600 baud; Arduino điều khiển bốn servo qua PCA9685 và gửi lại gói JSON chứa bốn góc servo, khoảng 5 gói mỗi giây. Phần cứng này là phần một, em trình bày tiếp theo.

Nếu được hỏi: chương trình có tự gửi phím không? Không, chỉ gửi khi người dùng bấm. Có dùng Bluetooth không? Có: khi điều khiển từ xa, máy Dell xem màn hình Mac qua Wi-Fi và gửi phím qua module HC-05 ở chân D2, D3; Mac vẫn nối cáp USB để nhận góc servo.

Nguồn: README.md (sơ đồ đầu trang, mục 1 và 3); main.py:76-79; robot_arm_4dof.ino:6,8,86,203-207; control.py (ArduinoSerialLink).

## Slide 5

PHẦN 01 / 03

01

PHẦN NÀY GỒM

Danh sách linh kiện

Arduino Uno R3 và PCA9685

Servo, nguồn, HC-05, camera

Sơ đồ mạch

Bảo vệ servo kẹp

6

7

Linh kiện

[Tên A]

8

9

10

01 Linh kiện

02 Computer vision & Hỗ trợ gắp

03 Code điều khiển

5

Notes: Tiếp theo là phần linh kiện, gồm: danh sách linh kiện, giới thiệu các linh kiện chính, sơ đồ mạch và giải pháp bảo vệ servo kẹp. Mỗi linh kiện được trình bày theo thông số và vai trò trong hệ thống.

Nếu được hỏi: phần này nằm ở đâu trong mã nguồn? Xem tên tệp trên slide nhóm (slide 2).

Nguồn: phân công của nhóm; README.md (các khối của mã).

## Slide 6

01 · LINH KIỆN

Danh sách linh kiện

[Tên A] · Linh kiện

1

LINH KIỆN

Arduino Uno R3

SL

1

VAI TRÒ

Vi điều khiển chính

Tạo xung PWM cho servo

2

Mạch PCA9685 (16 kênh PWM)

1

Đế, vai, khuỷu, kẹp

3

4

Servo MG996R

Nguồn tổ ong 5–6 V

4

1

Cấp nguồn cho servo

Nhận phím từ máy Dell

5

Module Bluetooth HC-05

1

6

7

Khung cánh tay 4 bậc tự do, tay kẹp

Camera OBSBOT Meet SE

1

1

Cơ khí

Camera phía trên

8

Camera MacBook (có sẵn)

1

Camera phía trước

Hệ tọa độ (cm)

Chạy chương trình, cấp nguồn Arduino

9

10

Tờ A4 in 4 mã ArUco

Laptop, cáp USB, dây cắm

1

—

6

Notes: Đây là danh sách linh kiện. Arduino Uno R3 là vi điều khiển chính: nhận phím từ laptop và điều khiển mạch PCA9685. PCA9685 tạo xung PWM cho bốn servo MG996R ở đế, vai, khuỷu và kẹp. Nguồn tổ ong 5–6 V cấp riêng cho servo. Module HC-05 dùng để nhận phím qua Bluetooth, không bắt buộc. Phần quan sát gồm camera OBSBOT phía trên, camera MacBook phía trước và tờ A4 in bốn mã ArUco. Laptop chạy chương trình Python và cấp nguồn cho Arduino qua USB.

Nếu được hỏi: mua linh kiện ở đâu, giá bao nhiêu? [...điền nếu thầy cô hỏi]. Khung cánh tay làm bằng vật liệu gì? [...điền].

Nguồn: README.md mục 1; robot_arm_4dof/robot_arm_4dof.ino:1-8,86-90; robot_arm_4dof/flash.sh:19 (arduino:avr:uno); cameras.py.

## Slide 7

01 · LINH KIỆN

Arduino Uno R3 và PCA9685

[Tên A] · Linh kiện

(1) Arduino · (2) PCA9685 · (3) HC-05 · (4) Nguồn tổ ong · (5) Servo đế

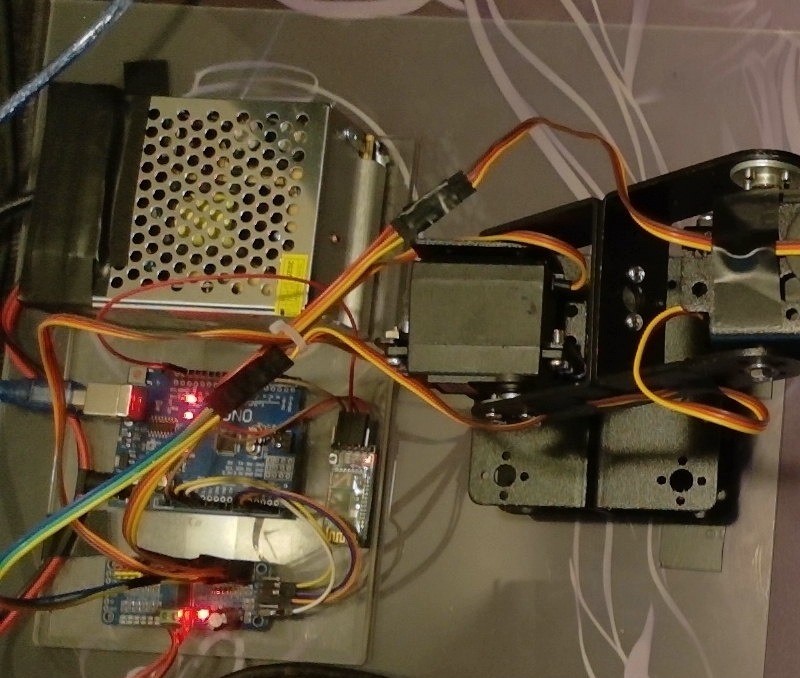
[picture p6: figure]

1

Arduino Uno R3

THÔNG SỐ

4

ATmega328P · 16 MHz · 14 chân số, 6 analog · 5 V

5

VAI TRÒ

Nhận phím (USB / HC-05), điều khiển PCA9685 qua I²C, gửi trạng thái mỗi 200 ms

1

3

2

Mạch PCA9685

THÔNG SỐ

2

16 kênh PWM 12 bit · I²C 0x40 · 50 Hz

VAI TRÒ

Kênh 0–3 → 4 servo; nguồn servo vào cổng V+

7

Notes: Ảnh bên trái là mạch của nhóm, các linh kiện được đánh số: (1) Arduino Uno R3, (2) PCA9685, (3) HC-05, (4) nguồn tổ ong, (5) servo MG996R ở đế.

Arduino Uno R3 dùng vi điều khiển ATmega328P, 16 MHz, 14 chân số và 6 chân analog, cấp nguồn 5 V qua USB. Trong hệ thống, Arduino nhận phím từ Mac qua USB ở 9600 baud hoặc từ máy Dell qua HC-05, giới hạn góc servo, gửi lệnh cho PCA9685 qua I²C, và gửi gói JSON chứa bốn góc servo mỗi 200 ms.

PCA9685 là mạch 16 kênh PWM 12 bit, giao tiếp I²C ở địa chỉ 0x40, đặt tần số 50 Hz cho servo. Kênh 0 đến 3 nối với đế, vai, khuỷu và kẹp; góc 0–180 độ được đổi thành độ rộng xung 125–575 trên thang 4096. Nguồn servo cấp vào cổng V+ của mạch.

Nếu được hỏi: vì sao dùng PCA9685 thay vì nối servo trực tiếp vào Arduino? PCA9685 tạo xung cho nhiều servo cùng lúc và có cổng nguồn riêng cho servo; Arduino chỉ cần gửi lệnh qua hai dây I²C.

Nguồn: robot_arm_4dof.ino:1-12,41-45,86-90 (Wire, Adafruit_PWMServoDriver 0x40, setPWMFreq 50, SERVOMIN 125, SERVOMAX 575); README.md mục 1; thông số Arduino Uno R3 theo trang sản phẩm của Arduino; ảnh hw_electronics.

## Slide 8

01 · LINH KIỆN

Servo, nguồn, HC-05 và camera

[Tên A] · Linh kiện

Servo MG996R × 4

Bánh răng kim loại · 0–180° · xung 0,5–2,5 ms

Đế, vai, khuỷu, kẹp · mỗi phím 2° (kẹp 5°)

Nguồn tổ ong 5–6 V

Nguồn xung 5–6 V

Cấp riêng cho servo qua PCA9685 · chung GND

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
Module Bluetooth HC-05

Bluetooth SPP · UART 9600 baud

Nối D2, D3 · nhận phím từ máy Dell

Hai camera 1920 × 1080

OBSBOT Meet SE (trên) · camera MacBook (ngang)

Cùng quan sát tờ A4 có 4 mã ArUco

8

Notes: Tiếp theo là các linh kiện còn lại. Bốn servo MG996R dùng bánh răng kim loại, góc quay 0–180 độ, độ rộng xung 0,5–2,5 ms. Mỗi lần bấm, đế, vai và khuỷu quay 2 độ, kẹp quay 5 độ; tám phím bên dưới là cặp phím của từng servo. Servo này không phản hồi vị trí, nên trạng thái XONG ở phần hỗ trợ gắp dựa trên góc đã ra lệnh.

Nguồn tổ ong 5–6 V cấp riêng cho servo qua cổng V+ của PCA9685, vì servo tiêu thụ dòng lớn; GND được nối chung.

HC-05 là module Bluetooth nối chân D2, D3 của Arduino. Firmware nhận phím từ HC-05 giống như từ USB. Khi điều khiển từ xa, máy Dell cách khoảng 2 m gửi phím qua HC-05; Mac vẫn nối USB để nhận góc servo và tính lệnh.

Hai camera có độ phân giải 1920 × 1080: OBSBOT Meet SE đặt phía trên để tính vị trí vật, camera MacBook đặt phía trước để quan sát độ cao tay kẹp.

Nếu được hỏi: mô-men xoắn của MG996R là bao nhiêu? Theo datasheet khoảng 10 kg·cm ở 6 V; nhóm chưa đo. Vì sao không dùng servo có phản hồi vị trí? Ngoài phạm vi linh kiện hiện có; đây là một hướng phát triển.

Nguồn: robot_arm_4dof.ino:5-6,13-21,86-87,121-152; README.md mục 1; cameras.py; datasheet MG996R (dải xung).

## Slide 9

01 · LINH KIỆN

Sơ đồ mạch

[Tên A] · Linh kiện

Laptop

MacBook · main.py

USB 9600 baud

phím ↓ JSON ↑

Arduino Uno R3

5V

GND

A4 · SDA

A5 · SCL

D2 · RX

D3 · TX

USB

PCA9685

4 SERVO MG996R

Kênh 0 · Đế

A/D

I²C

VCC

GND

kênh 0

kênh 1

Kênh 1 · Vai

W/S

USB

SDA

SCL

kênh 2

kênh 3

V+ / GND · cổng xanh

Kênh 2 · Khuỷu

Kênh 3 · Kẹp

mỗi servo 3 dây: xung, V+, GND

I/K

J/L

Cam TRÊN

OBSBOT Meet SE

Cam NGANG: camera MacBook

Nguồn tổ ong

5–6 V cho servo

tín hiệu: I²C, xung servo

nguồn servo 5–6 V

USB, 5 V logic

HC-05 (máy Dell)

TXD → D2 · RXD ← D3

Theo firmware và README; I²C của Arduino Uno: A4 (SDA), A5 (SCL).

GND (nối chung)

HC-05 (máy Dell)

9

Notes: Đây là sơ đồ đấu dây. Laptop nối Arduino qua USB ở 9600 baud: phím đi xuống, gói JSON đi lên; cáp này cũng cấp nguồn cho Arduino. Arduino nối PCA9685 bằng bốn dây: 5 V, GND, SDA ở chân A4 và SCL ở chân A5.

PCA9685 xuất xung ở kênh 0–3 cho bốn servo đế, vai, khuỷu và kẹp; mỗi servo có ba dây: tín hiệu, V+ và GND. Nguồn tổ ong 5–6 V cấp vào cổng V+ của PCA9685, chỉ dùng cho servo. HC-05 nối TXD vào D2 và RXD vào D3 của Arduino. Camera OBSBOT nối laptop qua USB. GND của Arduino, PCA9685 và nguồn servo được nối chung.

Nếu được hỏi: vì sao dùng A4 và A5? Đây là hai chân I²C (SDA, SCL) của Arduino Uno. Chân RXD của HC-05 có dùng cầu chia áp không? [...điền theo mạch thật]. Vì sao phải nối chung GND? Để tín hiệu xung và nguồn servo có cùng mức tham chiếu.

Nguồn: robot_arm_4dof.ino:1-8,86-90 (Wire, SoftwareSerial BT(2, 3), PCA9685 0x40); README.md mục 1 (nguồn riêng vào cổng xanh); ảnh hw_electronics.

## Slide 10

01 · LINH KIỆN

Bảo vệ servo kẹp khỏi quá nhiệt

[Tên A] · Linh kiện

NGUYÊN NHÂN

Firmware cũ giữ xung liên tục

Kẹp bị chặn, servo vẫn chịu tải

Lệnh 175°: xung vượt mức 2,5 ms

ĐÃ NẠP VÀ KIỂM TRA TRÊN MẠCH (02/11)

GIẢI PHÁP TRONG FIRMWARE

Giới hạn góc kẹp 160°, bước 5°

Mở hết (95°), 5 s không có lệnh → ngắt xung

Khép liên tục quá 60 s → ngắt xung

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
nghỉ kẹp

10

Notes: Phần cuối của linh kiện là bảo vệ servo kẹp khỏi quá nhiệt. Có hai nguyên nhân: firmware cũ giữ xung PWM liên tục, nên khi kẹp bị chặn servo vẫn chịu tải; và lệnh đóng 175 độ tương ứng xung khoảng 2,74 ms, vượt dải 0,5–2,5 ms của MG996R.

Firmware mới có các biện pháp: giới hạn góc kẹp 160 độ; mở hết mà 5 giây không có lệnh thì ngắt xung; khép liên tục quá 60 giây cũng ngắt xung; và phím X cho servo kẹp nghỉ.

Firmware này đã được nạp và kiểm tra trên mạch ngày 2/11. Nhóm chưa đo nhiệt độ servo sau thay đổi.

Tiếp theo, Nguyễn Anh Dương và Phạm Trương Vũ trình bày phần computer vision và hỗ trợ gắp.

Nếu được hỏi: Giới hạn 160 độ có vượt dải xung không? Có, xung khoảng 2,56 ms, hơi vượt dải danh định 2,5 ms; nhóm chấp nhận để kẹp chặt hơn, kèm cơ chế tự ngắt xung sau 60 giây. Vì sao khi ngắt xung lúc mở hết thì hàm kẹp khép lại? Khi mất xung, hai hàm kẹp khép thành hình chữ V hẹp, khe còn khoảng 1–2 cm (ước lượng từ ảnh), nên khi tiếp cận cần bấm J để mở lại.

Nguồn: robot_arm_4dof.ino:16-23,160-176,191-201; README.md mục 6; 05_SO_LIEU_VA_NGUON.md mục 6.

## Slide 11

PHẦN 02 / 03

02

PHẦN NÀY GỒM

Hệ tọa độ từ tờ A4

Nhận diện vật

Điều kiện hoàn thành

Thử nghiệm trên cánh tay thật

Kiểm tra

Kết quả

Hạn chế, hướng phát triển

12

13

Computer vision &
Hỗ trợ gắp

Nguyễn Anh Dương – Phạm Trương Vũ

14

15

16

17

18

01 Linh kiện

02 Computer vision & Hỗ trợ gắp

03 Code điều khiển

11

Notes: Em là Nguyễn Anh Dương. Phần hai do em và Phạm Trương Vũ trình bày, gồm hai nửa. Nửa đầu em trình bày computer vision: xác định vị trí vật trên bàn theo xăng-ti-mét, gồm hệ tọa độ từ tờ A4 với bốn mã ArUco và nhận diện vật. Nửa sau Phạm Trương Vũ trình bày hỗ trợ gắp: điều kiện hoàn thành, thử nghiệm trên cánh tay thật, cách kiểm tra bằng mắt, kết quả, hạn chế và hướng phát triển.

Nếu được hỏi: phần này nằm ở đâu trong mã nguồn? Xem tên tệp trên slide nhóm (slide 2).

Nguồn: phân công của nhóm; README.md (các khối của mã).

## Slide 12

02 · COMPUTER VISION

Hệ tọa độ từ tờ A4 và mã ArUco

Nguyễn Anh Dương · Computer vision

Cam TRÊN: lưới 5 cm; cốc ở X = 16,5 cm, Y = 13,8 cm (giao diện bản trước)

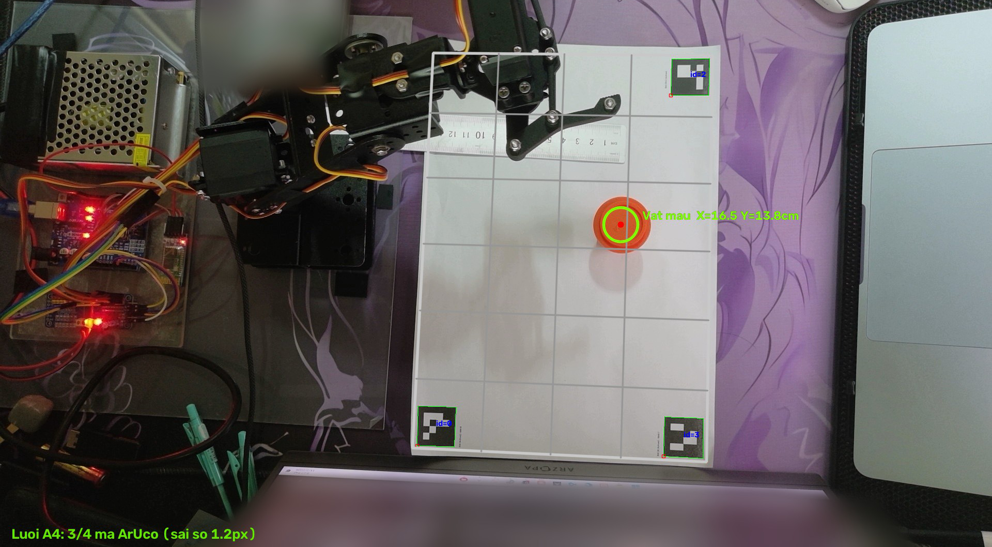
[picture p7: figure]

Cam NGANG: cùng lưới tọa độ

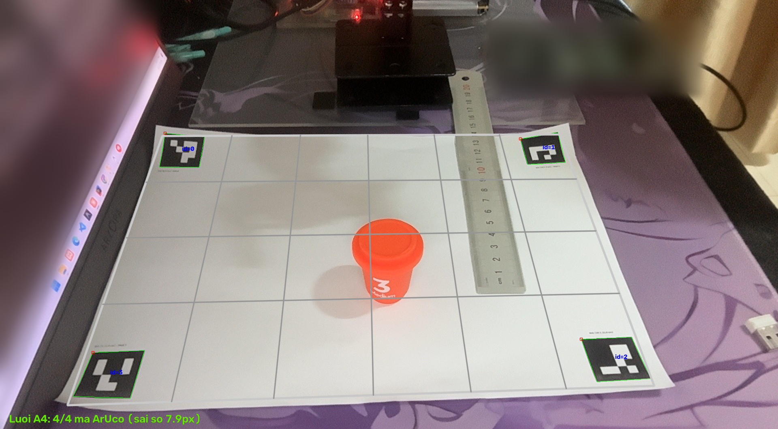
[picture p8: figure]

1

4 mã ở 4 góc

DICT_4X4_50 · ID 0–3
cạnh 2,8 cm

2

Homography

pixel ↔ cm, hai camera

3

Khi mã bị che

dùng vị trí đã lưu

4

Bù thị sai

sai lệch 1,2 → 0,2 cm
(một phép đo)

12

Notes: Trước hết, hệ thống cần biết vị trí vật theo xăng-ti-mét. Nhóm in tờ A4 có bốn mã ArUco ở bốn góc; mỗi mã có số định danh, và OpenCV xác định được bốn góc của từng mã.

Từ kích thước thật của tờ giấy, 29,7 × 21 cm, chương trình tính phép biến đổi homography để đổi pixel sang tọa độ trên tờ giấy, cho cả hai camera. Gốc tọa độ đặt ở mã số 0. Khi một vài mã bị che, chương trình dùng vị trí đã lưu.

Camera phía trên đặt cao khoảng 46 cm, nên phần trên của vật cao 5 cm bị lệch khoảng 1 cm so với vị trí thật; đây là sai số thị sai. Nhóm bù sai số này theo độ cao vật; ở một vị trí đã đo, sai lệch giữa hai camera giảm từ 1,2 cm xuống 0,2 cm. Hai ảnh là lưới tọa độ chương trình vẽ trên khung hình camera đã lưu.

Nếu được hỏi: vì sao dùng ArUco? Mã có số định danh, xác định rõ bốn góc, nhận được khi nhìn nghiêng và có sẵn trong OpenCV. Tờ giấy là hệ quy chiếu chung cho cả hai camera, nên khi đổi vị trí camera không cần đo lại bằng thước. Độ cao 46 cm đo thế nào? Ước lượng từ ảnh, chưa đo bằng thước; con số 0,2 cm là kết quả của một phép đo.

Nguồn: vision.py:16-23,45-62,76-89; README.md mục 4.

## Slide 13

02 · COMPUTER VISION

Nhận diện vật

Nguyễn Anh Dương · Computer vision

Ảnh phẳng tờ A4

Homography, 8 pixel / cm

BƯỚC 1

Tách vùng có màu

Độ bão hòa ≥ 90, đủ sáng

BƯỚC 2

Lọc vật

Bỏ khối < 1,5 cm² hoặc > 50 cm², sát mép giấy

BƯỚC 3

Cam TRÊN, ảnh đã lưu: vòng xanh quanh cốc kèm X, Y (cm) (giao diện bản trước)


CHỌN MỤC TIÊU

- Ưu tiên vật gần đế nhất
- R chụp vị trí làm đích
- Góc cần tới tính một lần
- Vật bị dời: bấm R lại

13

Notes: Sau khi có hệ tọa độ, chương trình tìm vật bằng cách tách màu, gồm ba bước. Bước một: dùng homography dựng ảnh phẳng của tờ A4, mỗi xăng-ti-mét là 8 pixel. Bước hai: giữ các vùng có màu đậm như cốc đỏ; giấy trắng, bóng xám và thân robot đen bị bỏ. Bước ba: lọc vật. Khối nhỏ hơn 1,5 cm² là nhiễu hoặc dây điện; khối lớn hơn 50 cm² là bàn tay, không lọt miệng kẹp; khối sát mép giấy là vật thò từ ngoài vào.

Tâm của khối màu đổi ra xăng-ti-mét, rồi được bù thị sai như slide trước. Ảnh bên dưới là khung camera trên: vòng xanh quanh cốc kèm tọa độ X, Y.

Khi có nhiều vật, vật gần đế nhất được chọn. Người điều khiển bấm phím R để chụp vị trí vật lúc đó làm đích; góc cần tới được tính một lần và không theo camera nữa, nên khi tay kẹp che hoặc đẩy lệch vật, đích không đổi. Vật bị dời thì bấm R lại.

Tiếp theo, Phạm Trương Vũ trình bày nửa sau của phần này: hỗ trợ gắp.

Nếu được hỏi: vì sao không dùng YOLO? Bản trước có YOLO11 nhưng hay nhận nhầm bộ phận robot, nên nhóm bỏ để mã đơn giản; tách màu đủ cho cốc màu đậm. Vật màu trắng hoặc xám thì sao? Chưa nhận được; đây là một hạn chế. Vì sao phải bấm R mà không theo camera liên tục? Khi tay kẹp tiến vào, nó che và đẩy cốc nên vị trí camera thấy bị nhảy; chụp một lần thì đích đứng yên và mã đơn giản hơn.

Nguồn: vision.py:68-91; control.py:253-263 (phím R).

## Slide 14

02 · HỖ TRỢ GẮP

Điều kiện hoàn thành

Phạm Trương Vũ · Hỗ trợ gắp

sai lệch tối đa mỗi servo

± 2°

Mô phỏng trên ảnh đã lưu: đủ phím → XONG (giao diện bản trước)

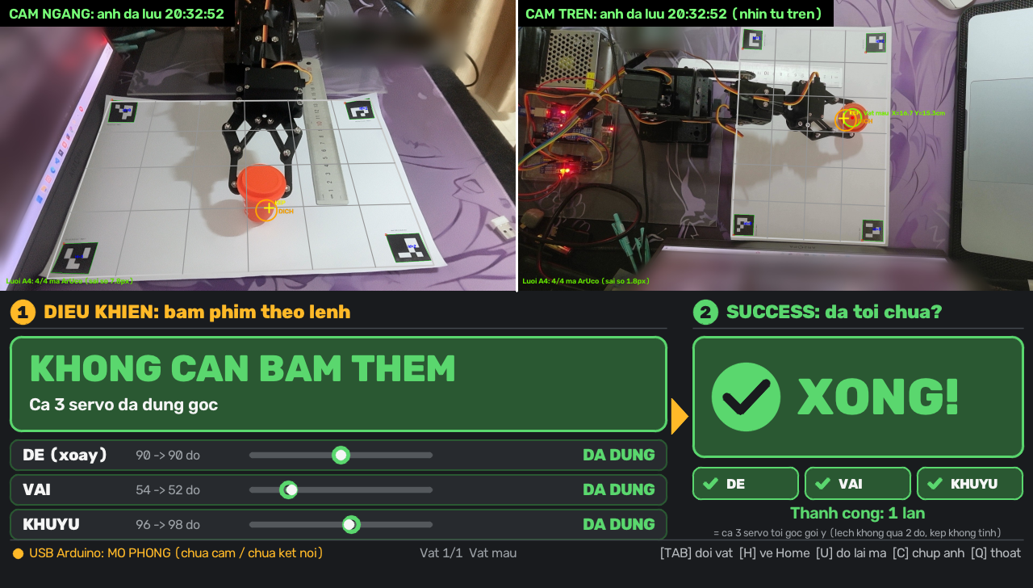
[picture p9: figure]

đế, vai, khuỷu (không xét kẹp)

3 servo

giữ liên tục để tính 1 lần

1 giây

KIỂM TRA: NHÌN Ô SUCCESS TRÊN MÀN HÌNH

PHẠM VI

Không xét tay kẹp: vật thon dễ trượt khi kẹp

LƯU Ý

XONG dựa trên góc đã ra lệnh; servo không phản hồi vị trí

14

Notes: Em là Phạm Trương Vũ, trình bày phần hỗ trợ gắp. Khối success kiểm tra ba servo đế, vai, khuỷu đã tới góc mà khối điều khiển gợi ý hay chưa; cách tính góc gợi ý được [Tên C] trình bày ở phần ba. Khối này chỉ đọc Plan, không phụ thuộc vào camera, động học hay cổng USB.

Điều kiện gồm ba ý. Mỗi servo lệch không quá một bước bấm, tức 2 độ; nhóm chọn 2 độ vì mô hình hình học cũng chỉ chính xác ở mức đó. Chỉ xét ba servo của cánh tay, không xét tay kẹp. Cả ba phải giữ đúng liên tục 1 giây mới tính thêm một lần hoàn thành.

Tay kẹp không được xét vì cốc thử nghiệm thon dần về đáy: khi khép đến 150–160 độ, cốc bị đẩy ra; trong buổi thử cốc bị đổ khoảng 3 lần.

Lưu ý: trạng thái XONG nghĩa là ba góc đã ra lệnh đạt mục tiêu, vì MG996R không phản hồi vị trí thật. Ảnh bên phải là mô phỏng trên ảnh đã lưu; bản này chưa được đếm trên cánh tay thật.

Nếu được hỏi: vì sao cần giữ 1 giây? Để trường hợp đi qua mục tiêu không bị tính. Có kiểm tra bằng camera không? Bản trước có, dựa trên hai camera; nhóm đã bỏ để mã đơn giản hơn. Số lần hoàn thành hiển thị ở đâu? Ở dòng Thanh cong: N lan trong ô success; chưa ghi ra file. Khi chưa bấm R? Không báo XONG; trạng thái là chưa có đích.

Nguồn: success.py:11-12,15-56; robot_arm_4dof.ino:70-83; README.md mục 6; ảnh ui_screen_done (tạo bằng slides/tools/make_screen_images.py).

## Slide 15

02 · HỖ TRỢ GẮP

Thử nghiệm trên cánh tay thật

Phạm Trương Vũ · Hỗ trợ gắp

CAM
NGANG

20:32:52 · KẸP

20:33:02 · CHUYỂN SANG TRÁI

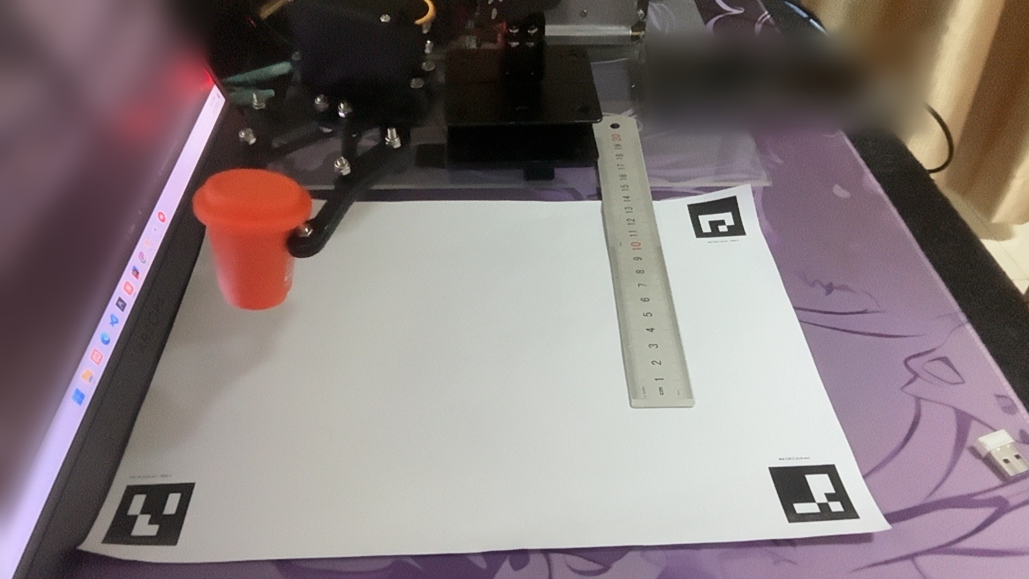
[picture p10: figure]

20:33:12 · ĐẶT XUỐNG

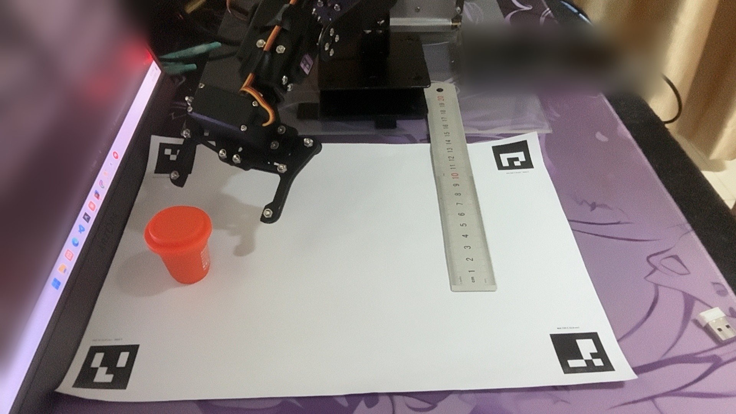
[picture p11: figure]

CAM
TRÊN

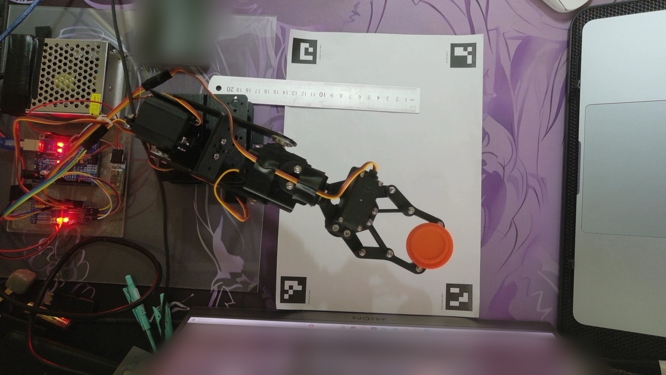
[picture p12: figure]
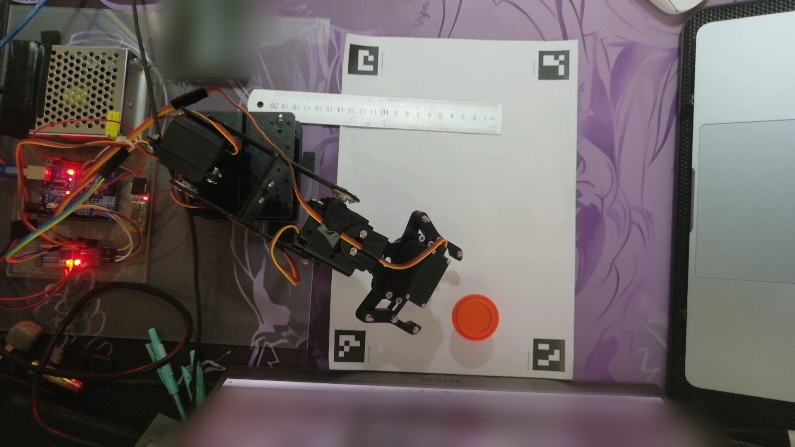
[picture p13: figure]

ĐIỀU KHIỂN BẰNG BÀN PHÍM

02/11/2026 · ba khung hình cách nhau 10 giây · giao diện bản trước

15

Notes: Đây là buổi thử trên cánh tay thật ngày 2/11. Ba cột cách nhau 10 giây; hàng trên là camera ngang, hàng dưới là camera phía trên: cốc nằm giữa hai ngón kẹp, được chuyển sang trái, rồi đặt xuống. Nhóm thực hiện thao tác này nhiều lần.

Người điều khiển bấm phím dựa trên hình ảnh từ hai camera, với giao diện bản trước khi đơn giản hóa. Trong buổi thử, cốc bị đổ khoảng 3 lần và được dựng lại bằng tay. Nhóm chưa có số liệu tỉ lệ thành công.

Góc servo lúc kẹp, đọc từ giao diện bản cũ: đế khoảng 85, vai 60–65, khuỷu 85–90 độ. Các mẫu đặt kẹp quanh cốc trong buổi này cũng là dữ liệu [Tên C] dùng để hiệu chỉnh mô hình ở phần ba.

Nếu được hỏi: có video không? [...điền: có / không; nếu có thì chiếu đoạn 20–30 giây]. Kẹp có giữ chắc không? Chưa: cốc thon bị đẩy ra khi khép đến 150–160 độ.

Nguồn: ảnh demo_06, demo_07, demo_08 (khung cắt từ video 02/11/2026, 20:32:52 đến 20:33:12); 05_SO_LIEU_VA_NGUON.md mục 7.

## Slide 16

02 · HỖ TRỢ GẮP

Kiểm tra

Phạm Trương Vũ · Hỗ trợ gắp

1

CHẠY CHƯƠNG TRÌNH, KIỂM TRA BỐN ĐIỀU

Lưới 5 cm bám tờ giấy: góc dưới ghi Luoi A4: thay 4/4 ma ArUco

Vòng xanh nằm trên cốc, kèm X, Y (cm)

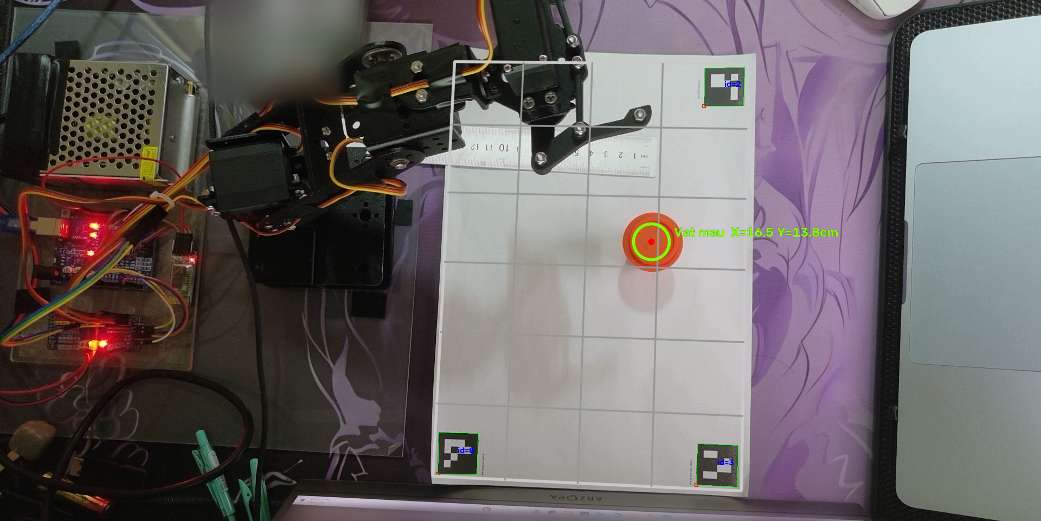
[picture p14: figure]

2

3

Bấm R: hiện lệnh to; bấm đúng phím thì số lần bấm giảm dần

1–2 · Cam TRÊN: lưới 5 cm, vòng xanh quanh cốc

3–4 · Đủ phím → XONG (mô phỏng) (giao diện bản trước)

4

XONG; giữ 1 giây thì Thanh cong cộng 1

CHƯA ĐO TỈ LỆ THÀNH CÔNG

16

Notes: Nhóm kiểm tra hệ thống khi chạy chương trình, theo bốn điều.

Một: lưới 5 cm phải bám đúng tờ giấy, góc dưới ghi Luoi A4: thay 4/4 ma ArUco; lưới lệch là homography sai. Hai: đặt cốc lên giấy, vòng xanh phải nằm trên cốc, kèm tọa độ X, Y theo xăng-ti-mét. Ba: bấm R để chụp đích; ô một hiện lệnh to, ví dụ BAM D x8, và bấm đúng phím thì số lần bấm giảm dần. Bốn: đủ phím thì hiện XONG, giữ 1 giây thì Thanh cong cộng một.

Ảnh trên là khung cam TRÊN với lưới và vòng xanh; ảnh dưới là màn hình khi đủ phím, chạy trên ảnh đã lưu với cánh tay mô phỏng. Nhóm chưa đo tỉ lệ thành công trên cánh tay thật.

Nếu được hỏi: có test tự động không? Không; nhóm kiểm tra bằng cách chạy chương trình và quan sát. Làm sao biết vị trí cốc đúng? So hai camera: sau bù thị sai, hai camera đo cùng một cốc lệch nhau 0,2 cm ở một vị trí đã đo. Làm sao biết góc gợi ý đúng? Bấm theo lệnh tới XONG rồi nhìn hai ngón kẹp có ôm được cốc không; sai số của mô hình nằm ở slide hiệu chỉnh.

Nguồn: README.md mục 7; 05_SO_LIEU_VA_NGUON.md mục 2 và 11; ảnh sw_annot_top, ui_screen_done.

## Slide 17

02 · HỖ TRỢ GẮP

Kết quả

Phạm Trương Vũ · Hỗ trợ gắp

ĐÃ THỰC HIỆN

- Hệ tọa độ chung cho hai camera
- Kẹp, di chuyển cốc trên cánh tay thật (02/11)
- Hiệu chỉnh mô hình từ 10 mẫu
- Firmware bảo vệ servo kẹp đã nạp, kiểm tra
- Giao diện gợi ý phím, kiểm tra góc

CHƯA THỰC HIỆN

- Đếm XONG trên cánh tay thật (bản mới)
- Kiểm tra gợi ý mới trên phần cứng
- Kẹp chắc vật thon
- Đo nhiệt độ servo
- Hiệu chỉnh cho tờ giấy mới
- Dashboard IoT / MQTT

thử trên
cánh tay thật

02/11

0,2 cm

lệch giữa 2 camera
sau bù thị sai

8,5 mm

sai số hiệu chỉnh
trên 10 mẫu

17

Notes: Slide này tổng hợp những việc đã thực hiện và chưa thực hiện.

Đã thực hiện: hệ tọa độ chung cho hai camera; kẹp và di chuyển cốc trên cánh tay thật bằng bàn phím; hiệu chỉnh mô hình từ 10 mẫu với sai số 8,5 mm, chi tiết ở phần ba; firmware bảo vệ servo kẹp đã nạp và kiểm tra; giao diện gợi ý phím và kiểm tra góc. Nhóm kiểm tra bằng mắt khi chạy chương trình: lưới 5 cm có bám tờ giấy không, vòng xanh có nằm trên cốc không, bấm theo lệnh thì cánh tay có đi đúng hướng không. Sau bù thị sai, hai camera đo cùng một cốc chỉ lệch nhau 0,2 cm (đo ở một vị trí, ngày 2/11).

Chưa thực hiện: đếm số lần XONG trên cánh tay thật với bản mới; kiểm tra gợi ý mới trên phần cứng; kẹp chắc vật thon; đo nhiệt độ servo; hiệu chỉnh cho tờ giấy mới; dashboard IoT qua MQTT và cảm biến lực, vốn có trong kế hoạch ngày 28/10.

Nếu được hỏi: vì sao chưa chạy bản mới trên cánh tay thật? Mã được đơn giản hóa sau buổi thử 2/11, lần gần nhất ngày 12/11; thử nghiệm bản mới trên cánh tay thật là bước tiếp theo. Kiểm tra thế nào? Bằng mắt khi chạy chương trình, với hai camera và cánh tay thật; chưa có số liệu tỉ lệ thành công. Có bắt buộc dashboard IoT không? [...điền theo yêu cầu đề bài]; nếu có, nhóm có thể thêm MQTT từ gói JSON hiện có.

Nguồn: 05_SO_LIEU_VA_NGUON.md mục 4, 6, 7, 8, 11, 13; 05_SO_LIEU_VA_NGUON.md mục 2 (bù thị sai) và mục 11 (cách kiểm tra).

## Slide 18

02 · HỖ TRỢ GẮP

Hạn chế và hướng phát triển

Phạm Trương Vũ · Hỗ trợ gắp

HẠN CHẾ

- Điều khiển vòng hở (không phản hồi vị trí)
- Hiệu chỉnh phụ thuộc vị trí giấy và robot
- Tay kẹp chưa giữ chắc vật thon
- Chỉ nhận vật có màu trên giấy trắng
- Chưa có số liệu tỉ lệ hoàn thành

HƯỚNG PHÁT TRIỂN

Thử nghiệm bản mới trên cánh tay thật

Cải thiện tay kẹp, đưa kẹp vào success

Hiệu chỉnh lại khi đổi tờ giấy

Phản hồi vị trí đầu kẹp bằng camera

Dashboard IoT (MQTT) từ dữ liệu JSON

1

2

3

4

5

- Thứ tự camera macOS thay đổi: chọn lại chỉ số khi chạy
- Arduino tự reset khi mở lại cổng USB: giữ một kết nối

LỖI TÍCH HỢP ĐÃ XỬ LÝ

18

Notes: Hệ thống hiện có năm hạn chế. Thứ nhất, điều khiển vòng hở: trạng thái XONG dựa trên góc đã ra lệnh vì MG996R không phản hồi vị trí. Thứ hai, kết quả hiệu chỉnh phụ thuộc vị trí tờ giấy và robot. Thứ ba, tay kẹp chưa giữ chắc vật thon. Thứ tư, chương trình chỉ nhận vật có màu đậm đặt trên giấy trắng. Thứ năm, chưa có số liệu tỉ lệ hoàn thành và nhiệt độ servo.

Hướng phát triển: thử nghiệm bản mới trên cánh tay thật và đếm số lần XONG; cải thiện tay kẹp, ví dụ tăng ma sát hoặc dùng vật thân thẳng, rồi đưa kẹp vào điều kiện success; hiệu chỉnh lại khi đổi tờ giấy; đo vị trí đầu kẹp bằng camera để có phản hồi vòng kín; và thêm dashboard IoT qua MQTT nếu đề bài yêu cầu.

Dòng dưới là hai lỗi tích hợp đã xử lý: thứ tự camera trên macOS thay đổi giữa các lần chạy, nên người chạy chọn lại chỉ số camera khi cần; Arduino Uno tự khởi động lại mỗi khi cổng USB được mở lại, nên chương trình giữ một kết nối duy nhất.

Tiếp theo, [Tên C] trình bày phần code điều khiển.

Nếu được hỏi: biết Arduino vừa reset bằng cách nào? Nhìn cánh tay: cả 4 servo giật về Home, đế quay hết sang phải. Vì sao camera đổi thứ tự? OpenCV đánh số camera theo uniqueID, còn danh sách của hệ điều hành xếp camera dùng gần nhất lên đầu. Rút cáp camera hoặc USB giữa chừng thì sao? Bản đơn giản không tự nối lại: cắm lại cáp rồi chạy lại chương trình. Đo đầu kẹp bằng camera thế nào? Ví dụ dán mã ArUco lên càng kẹp và dùng homography của tờ giấy; đây là hướng đề xuất, chưa thực hiện. Có thể chuyển sang tự gửi phím không? Về kỹ thuật là gửi phím theo Plan; nhóm chỉ thực hiện khi đo được độ lệch còn lại.

Nguồn: 05_SO_LIEU_VA_NGUON.md mục 4, 6, 8, 9, 10, 13; cameras.py:1-7,19-35; control.py (ArduinoSerialLink: giữ một kết nối); README.md mục 5 và 6.

## Slide 19

PHẦN 03 / 03

03

PHẦN NÀY GỒM

Lưu đồ thuật toán

Code firmware

Động học ngược

Giao diện chương trình

Hiệu chỉnh mô hình

20

21

Code điều khiển

[Tên C]

22

23

24

01 Linh kiện

02 Computer vision & Hỗ trợ gắp

03 Code điều khiển

19

Notes: Em là [Tên C], phụ trách code điều khiển: firmware trên Arduino và khối điều khiển trên laptop. Phần này gồm lưu đồ thuật toán, code firmware, động học ngược, giao diện chương trình và hiệu chỉnh mô hình cánh tay.

Nếu được hỏi: phần này nằm ở đâu trong mã nguồn? Xem tên tệp trên slide nhóm (slide 2).

Nguồn: phân công của nhóm; README.md (các khối của mã).

## Slide 20

03 · CODE ĐIỀU KHIỂN

Lưu đồ thuật toán

[Tên C] · Code điều khiển

FIRMWARE ARDUINO · ROBOT_ARM_4DOF.INO

Bắt đầu

CHƯƠNG TRÌNH LAPTOP · MAIN.PY, MỖI KHUNG HÌNH

Đọc ảnh hai camera

setup(): USB, HC-05 9600 baud
PCA9685 50 Hz · servo 180/90/90/95

Có phím?

vision.py: tờ A4 và vật → (X, Y) cm

control.py: động học ngược → Plan

lặp lại
mỗi khung hình

có

Đổi góc (có giới hạn)
xuất xung · gửi JSON

Kẹp quá hạn?

không

có

mở 5 s / khép 60 s
→ ngắt xung kẹp

success.py: kiểm tra 3 servo → Result

không

screen.py: hiển thị lệnh và kết quả

Đủ 200 ms?

có

Gửi JSON trạng thái

Khi bấm phím: control.press() gửi ký tự xuống Arduino qua USB

loop()

20

Notes: Bên trái là lưu đồ firmware trên Arduino. Hàm setup mở cổng USB và HC-05 ở 9600 baud, đặt PCA9685 ở 50 Hz và đưa bốn servo về 180, 90, 90, 95 độ; đế quay hết sang phải để cánh tay không che vật ở camera phía trên. Vòng lặp loop thực hiện ba việc: khi có phím thì đổi góc trong giới hạn, xuất xung và gửi trạng thái; khi kẹp giữ quá thời gian thì ngắt xung; và cứ 200 ms gửi một gói JSON.

Bên phải là chương trình Python trên laptop, chạy ở mỗi khung hình: đọc hai camera, tìm tờ giấy và vật, tính góc và lệnh bấm phím, kiểm tra điều kiện hoàn thành, rồi hiển thị. Khi người dùng bấm phím, main.py gọi hàm press của khối điều khiển để gửi ký tự xuống Arduino qua USB; nếu chưa kết nối Arduino, chương trình chạy ở chế độ mô phỏng.

Nếu được hỏi: vì sao firmware đọc HC-05 trước USB? Để phím từ Bluetooth không bị bỏ qua khi USB cũng có dữ liệu; mỗi vòng chỉ đọc một ký tự. Vì sao không gửi trực tiếp lệnh góc? Để Arduino chỉ cần xử lý từng phím, giống khi điều khiển bằng tay.

Nguồn: robot_arm_4dof.ino:84-208; main.py:73-80,90-103; control.py:277-283 (press); success.py.

## Slide 21

03 · CODE ĐIỀU KHIỂN

Code firmware Arduino

[Tên C] · Code điều khiển

1 · NHẬN PHÍM, ĐỔI GÓC (LOOP)

char cmd = 0;
if (BT.available()) {
cmd = BT.read(); // HC-05
} else if (Serial.available()) {
cmd = Serial.read(); // cáp USB
}
switch (cmd) {
case 'a': case 'A':
angleBase = constrain(angleBase + STEP_ARM, 0, 180);
break;
... // d, w, s, i, k, j, l, h, x, z
}
setServoAngle(0, angleBase);

2 · GÓC → XUNG, GỬI TRẠNG THÁI

void setServoAngle(uint8_t channel, int angle) {
int pulse = map(angle, 0, 180, SERVOMIN, SERVOMAX);
pwm.setPWM(channel, 0, pulse);
}
if (millis() - lastReportMs >= 200) {
lastReportMs = millis();
sendServoState(); // 5 lần mỗi giây
}
// ví dụ một gói JSON gửi lên:
// {"t":5120,"servo":[90,90,90,95],
// "relax":0,"armrelax":0}

bước mỗi lần bấm

2° / 5°

xung ứng với 0–180°

125 → 575

USB và HC-05

9600 baud

21

Notes: Đây là phần code chính của firmware, đã rút gọn. Bên trái: mỗi vòng lặp đọc một ký tự, ưu tiên HC-05 rồi đến USB; lệnh switch đổi góc theo từng phím, qua hàm constrain để giữ trong giới hạn: đế 0–180 độ, vai và khuỷu 25–155 độ, kẹp 95–160 độ; sau đó xuất góc mới ra servo.

Bên phải: hàm setServoAngle đổi góc thành độ rộng xung bằng hàm map, từ 125 đến 575, rồi gửi cho PCA9685. Cứ 200 ms, firmware gửi một gói JSON như dòng ví dụ, gồm thời gian chạy, bốn góc servo và hai cờ báo servo kẹp hoặc cả cánh tay đang nghỉ. Chương trình trên laptop đọc gói này để biết góc hiện tại.

Nếu được hỏi: vì sao dùng JSON? Dễ đọc bằng Python và có thể thêm cờ trạng thái. Thời gian chạy t dùng làm gì? Khi t trở về gần 0 nghĩa là Arduino vừa khởi động lại. Dòng JSON trên slide là ví dụ đúng định dạng, giá trị t là giả định.

Nguồn: robot_arm_4dof.ino:9-14,41-45,69-83,101-150,203-207.

## Slide 22

03 · CODE ĐIỀU KHIỂN

Động học ngược

[Tên C] · Code điều khiển

L3 = 100

θ3

L4r = 65

1

Đổi (X, Y) cm sang tọa độ robot (mm)

L4z = 25

2

Đế: θ1 = atan2(y, x)

L2 = 105

θ2

điểm kẹp

3

Vai, khuỷu: tam giác hai khâu, khuỷu hướng lên

4

Làm tròn 2°; số lần bấm = độ lệch ÷ 2°

d1 = 70

VÍ DỤ · CỐC Ở (20,1; 7,4) CM

đế 74° · vai 58° · khuỷu 90°

theo mô hình đã hiệu chỉnh (slide 24)

Mô hình mặc định (mm) · vai 90° ↔ θ2 = 45° · khuỷu 90° ↔ θ3 = −45°

mặt bàn

Từ 90/90/90:

D

× 8

S

× 16

khuỷu đã đúng

22

Notes: Khi biết vị trí X, Y của vật, khối điều khiển tính góc cần tới của ba servo; đây là bài toán động học ngược.

Hình bên trái là cánh tay nhìn ngang: trục vai cao 70 mm so với mặt bàn, khâu vai dài 105 mm, khâu khuỷu dài 100 mm, tâm kẹp lệch 65 mm ra trước và 25 mm xuống dưới. Đây là số đo bằng thước của mô hình mặc định; các thông số này được hiệu chỉnh ở cuối phần.

Thuật toán có bốn bước: đổi tọa độ trên giấy sang tọa độ robot; tính góc đế bằng atan2(y, x); giải tam giác hai khâu cho vai và khuỷu, chọn nghiệm khuỷu hướng lên, với điểm kẹp cao 25 mm; cuối cùng đổi sang góc servo, làm tròn theo bước 2 độ, và số lần bấm bằng độ lệch chia 2.

Ví dụ, cốc ở (20,1; 7,4) cm cho góc gợi ý: đế 74, vai 58, khuỷu 90 độ. Từ tư thế 90/90/90, cần bấm D 8 lần và S 16 lần; khuỷu đã đúng góc. Cánh tay không có servo cổ tay nên không điều chỉnh được hướng tay kẹp.

Nếu được hỏi: công thức được kiểm tra thế nào? Lấy góc servo lúc hai ngón kẹp ôm cốc thật, tính ngược ra chỗ đầu kẹp theo mô hình rồi so với vị trí cốc (ảnh ở slide hiệu chỉnh); chương trình không vẽ dấu này lên màn hình. Vì sao chọn nghiệm khuỷu hướng lên? Tam giác hai khâu có hai nghiệm; chọn một chiều cố định để mỗi điểm chỉ có một bộ góc. Vật ngoài tầm với thì sao? Giao diện báo VAT NGOAI TAM VOI và khoảng cách cần dời vật lại gần.

Nguồn: control.py:26-54,60-116,119-131,147-169; 05_SO_LIEU_VA_NGUON.md mục 3 và 16 (ví dụ tính lại bằng check_facts.py --deep).

## Slide 23

03 · CODE ĐIỀU KHIỂN

Giao diện chương trình

[Tên C] · Code điều khiển

Chạy trên ảnh camera đã lưu, cánh tay mô phỏng; chữ không dấu do OpenCV (giao diện bản trước)

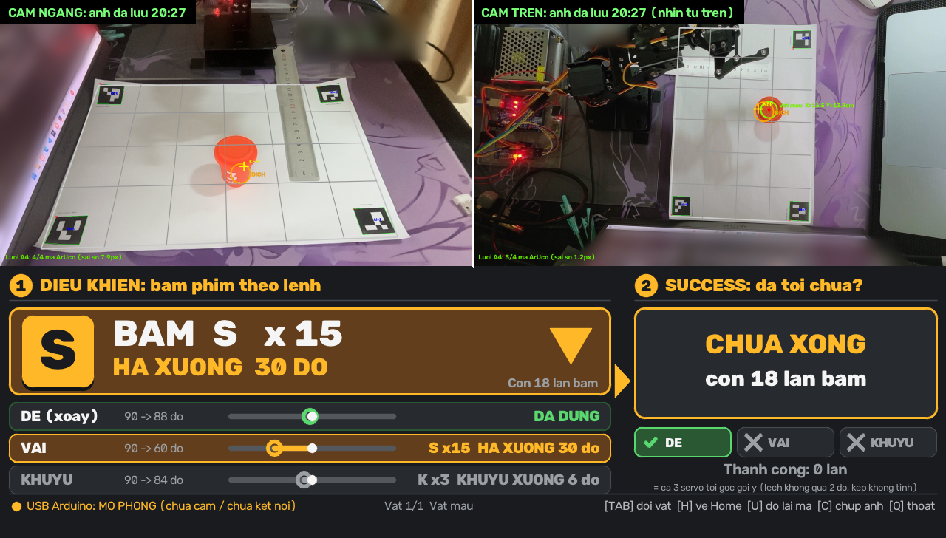
[picture p15: figure]

1

Ô điều khiển

phím, số lần, góc hiện tại → góc đích

2

Ô success

XONG khi cả ba servo tới góc

TRÁI / PHẢI THEO CAM NGANG

W S vai · I K khuỷu · mỗi lần 2°

Ví dụ: BẤM S × 15, còn 18 lần

A

sang phải

D

sang trái

23

Notes: Đây là giao diện chương trình, chạy trên ảnh camera đã lưu với cánh tay mô phỏng. Hai khung camera phía trên có lưới tọa độ và vòng DICH quanh vật; ảnh chụp từ bản trước nên còn dấu KEP vàng, bản hiện tại đã bỏ dấu này.

Bên dưới là hai ô nối nhau. Ô một lấy từ Plan của khối điều khiển: một lệnh chính. Trong ảnh, cốc ở (16,5; 13,8) cm, lệnh là bấm S 15 lần để hạ vai 30 độ, tổng còn 18 lần bấm. Ba hàng bên dưới là ba servo; hàng đã đạt ghi ĐÃ ĐÚNG, như hàng đế chỉ lệch 2 độ. Ô hai lấy từ kết quả của khối success: CHƯA XONG kèm số lần bấm còn lại, hoặc XONG.

Chữ không dấu vì OpenCV không hiển thị được dấu tiếng Việt. Trái, phải tính theo camera MacBook đặt trước robot: phím A quay đế sang phải, phím D sang trái.

Nếu được hỏi: chương trình có tự gửi phím không? Không; chỉ gửi khi người dùng bấm. Vì sao chỉ hiển thị một lệnh chính? Để người điều khiển thực hiện ngay, không cần đọc bảng số. Thứ tự lệnh thế nào? Đế, rồi vai, rồi khuỷu; servo đã đạt được bỏ qua. Ảnh đã lưu thì gợi ý lấy từ đâu? Chương trình đọc khung hình đã lưu như camera đang chạy; cánh tay mô phỏng đặt ở 90/90/90.

Nguồn: screen.py:45-75; main.py:65-80; control.py:138-143; ảnh ui_screen_before (tạo bằng slides/tools/make_screen_images.py).

## Slide 24

03 · CODE ĐIỀU KHIỂN

Hiệu chỉnh mô hình cánh tay

[Tên C] · Code điều khiển

SAI LỆCH CỦA MÔ HÌNH MẶC ĐỊNH

5,4 cm

mẫu 20:32 · servo [85, 60, 90]

Mẫu 21:03 (thuộc tập khớp): MAC DINH lệch ≈ 5 cm, SAU HIEU CHINH ≈ 1 cm

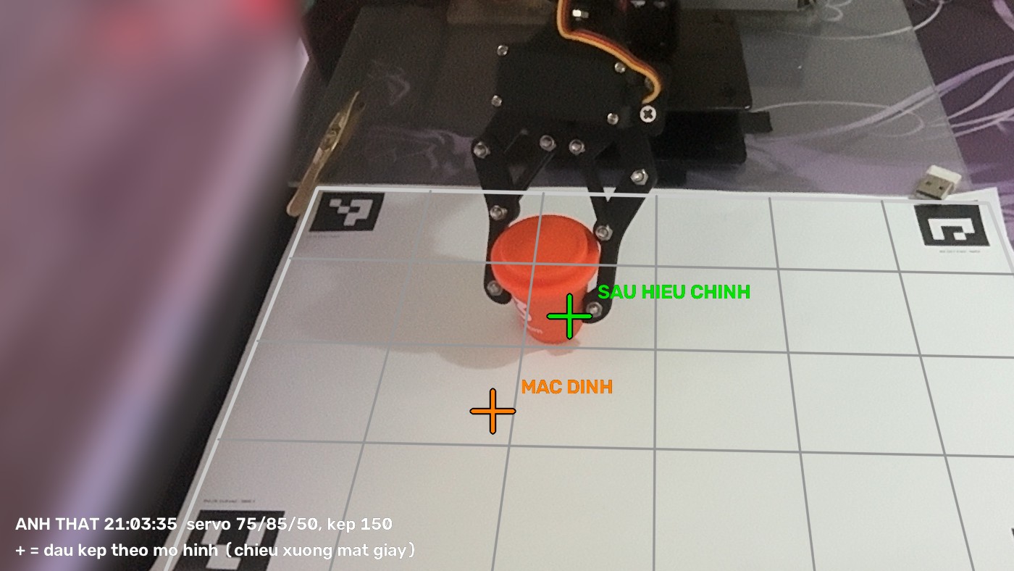
[picture p16: figure]

3,5 cm

mẫu 20:46 · servo [80, 70, 75]

5,9 cm

mẫu 21:03 · servo [75, 85, 50]

Sai lệch có hệ thống, hiệu chỉnh được

CÁCH HIỆU CHỈNH

1

2

Đặt kẹp quanh cốc; ghi góc servo và vị trí cốc

10 mẫu; khớp thông số mô hình (bình phương tối thiểu)

3

Lưu vào calibration.json

sai số khớp RMS
trên 10 mẫu

8,5 mm

11,6 mm

bỏ-một-mẫu
(leave-one-out)

24

Notes: Gợi ý trên màn hình được tính từ mô hình cánh tay, không đo trực tiếp bằng camera, nên độ chính xác của gợi ý phụ thuộc vào mô hình.

Trong buổi thử, người điều khiển đặt hai ngón kẹp quanh cốc, nhóm ghi lại ba góc servo và vị trí cốc. Với ba mẫu đầu, đầu kẹp theo mô hình mặc định cách cốc 5,4 cm, 3,5 cm và 5,9 cm, cùng chiều và cùng độ lớn, tức là sai lệch có hệ thống.

Nhóm hiệu chỉnh bằng 10 mẫu ở các vị trí khác nhau: khớp lại vị trí và hướng đế, góc chuẩn của vai và khuỷu, và độ lệch của càng kẹp, bằng phương pháp bình phương tối thiểu. Sai số khớp còn 8,5 mm, và 11,6 mm khi kiểm tra bỏ-một-mẫu. Trong ảnh, dấu màu cam là mô hình mặc định, dấu màu xanh là sau hiệu chỉnh; mẫu này thuộc tập khớp nên chỉ dùng để minh họa.

Lưu ý: 8,5 mm là sai số trên chính các mẫu dùng để khớp; gợi ý mới chưa được thử trên cánh tay thật; và kết quả hiệu chỉnh chỉ áp dụng cho vị trí tờ giấy và robot lúc đo.

Em xin hết phần code điều khiển. Tiếp theo là phần tổng kết.

Nếu được hỏi: nguyên nhân sai lệch là gì? Có ba: vị trí và hướng đế khác mặc định; góc chuẩn của vai và khuỷu phụ thuộc cách lắp cần servo, thước không đo được; và càng kẹp gắn cứng vào khâu khuỷu nên điểm kẹp quay theo khâu, trong khi mô hình cũ giữ độ lệch cố định. Vì sao không đo lại bằng thước? Thước đo được chiều dài khâu nhưng không đo được góc lắp cần servo; hiệu chỉnh từ các mẫu xử lý được cả hai.

Nguồn: calibration.json (mục arm, claw, arm_fit); calibration.py:2-12,35-60; 05_SO_LIEU_VA_NGUON.md mục 8 và 16; ảnh calib_before_after_side.

## Slide 25

ĐỒ ÁN IOT · NHÓM 3

Kết luận

Qua đề tài này, nhóm hiểu rõ hơn cách thị giác máy tính xác định vị trí vật trong thế giới thật: dùng tờ A4 in mã ArUco làm hệ tọa độ, đổi pixel sang xăng-ti-mét bằng homography và tách vật theo màu. Nhóm cũng nắm được cách tính góc cho cánh tay 4 bậc tự do bằng động học ngược, và cách Arduino Uno, mạch PCA9685 và servo MG996R phối hợp với nhau. Khi ghép các phần lại, nhóm học được cách tìm và sửa lỗi tích hợp như thứ tự camera thay đổi hay Arduino tự khởi động lại, cách hiệu chỉnh mô hình từ số đo thật Đề tài là nền tảng để nhóm phát triển các hệ thống nhúng và IoT phức tạp hơn, như điều khiển vòng kín bằng camera.

Hệ thống hỗ trợ gắp vật cho cánh tay robot bằng computer vision

25

Notes: Để kết luận, em xin nói về những gì nhóm học được qua đề tài.

Về thị giác máy tính, nhóm hiểu cách xác định vị trí vật trong thế giới thật: tờ A4 in bốn mã ArUco làm hệ tọa độ chung, homography đổi pixel sang xăng-ti-mét, và tách vật theo màu. Về điều khiển, nhóm nắm được cách tính góc cho cánh tay bốn bậc tự do bằng động học ngược, và cách Arduino Uno, mạch PCA9685 và servo MG996R phối hợp với nhau.

Khi ghép các phần lại, nhóm gặp những lỗi chỉ xuất hiện khi chạy cả hệ thống: thứ tự camera trên macOS thay đổi giữa các lần chạy, và Arduino tự khởi động lại khi cổng USB được mở lại. Nhóm cũng học cách hiệu chỉnh mô hình cánh tay từ số đo thật.

Đề tài là nền tảng để nhóm phát triển các hệ thống nhúng và IoT phức tạp hơn, ví dụ dùng camera đo vị trí đầu kẹp để điều khiển vòng kín.

Nếu được hỏi: phần khó nhất là gì? Làm cho mô hình hình học khớp với cánh tay thật: mô hình mặc định lệch 3,5 đến 5,9 cm, sau hiệu chỉnh từ 10 mẫu còn sai số khớp 8,5 mm.

Nguồn: 05_SO_LIEU_VA_NGUON.md mục 2, 8, 10, 11; README.md.

## Slide 26

ĐỒ ÁN IOT · NHÓM 3

Tóm tắt và hỏi đáp

1

Vị trí vật theo cm

Tờ A4 in 4 mã ArUco là hệ tọa độ chung cho hai camera; tách màu tìm vật, bù thị sai

TIẾP THEO

- Chạy bản mới trên cánh tay thật, đếm số lần XONG
- Tay kẹp giữ chắc vật thon
- Đo vị trí đầu kẹp bằng camera (vòng kín)

2

Bấm phím nào, mấy lần

Động học ngược tính góc 3 servo; mô hình hiệu chỉnh từ 10 mẫu, sai số khớp 8,5 mm

3

Đã tới đúng góc chưa

Ba servo lệch ≤ 2°, giữ 1 giây; XONG là góc đã ra lệnh, không phải đã gắp

Cảm ơn thầy cô và các bạn đã lắng nghe

Nguyễn Anh Dương · Nguyễn Minh Hiển · Trần Trọng Nghĩa · Phạm Trương Vũ · hỏi đáp

github.com/DuongNAD/Project_IoT

26

Notes: Tóm tắt lại, hệ thống của nhóm trả lời ba câu hỏi khi điều khiển cánh tay bằng bàn phím.

Một: vật ở đâu. Tờ A4 in bốn mã ArUco là hệ tọa độ chung cho hai camera; chương trình tách màu để tìm vật và bù thị sai, cho vị trí theo xăng-ti-mét. Hai: bấm phím nào, mấy lần. Động học ngược tính góc ba servo; mô hình cánh tay được hiệu chỉnh từ 10 mẫu, sai số khớp 8,5 mm. Ba: đã tới đúng góc chưa. Ba servo lệch không quá 2 độ và giữ 1 giây thì báo XONG; XONG nghĩa là góc đã ra lệnh tới góc gợi ý, không có nghĩa là đã gắp được vật.

Việc tiếp theo: chạy bản mới trên cánh tay thật để có số lần XONG đầu tiên, cải thiện tay kẹp để giữ chắc vật thon, và đo vị trí đầu kẹp bằng camera để có phản hồi vòng kín.

Nhóm em cảm ơn thầy cô và các bạn đã lắng nghe, và xin nhận câu hỏi; câu hỏi phần nào thì thành viên phụ trách phần đó trả lời. Mã nguồn có trên GitHub theo đường dẫn trên slide.

Nếu được hỏi: hệ thống đã gắp thành công bao nhiêu lần? Nhóm chưa có số liệu về tỉ lệ thành công. Trong buổi thử ngày 2/11, người điều khiển bấm phím đã kẹp và chuyển được cốc. Vì sao không cho chương trình tự điều khiển? Mô hình chỉ khớp cánh tay thật ở mức khoảng 1 cm và tay kẹp chưa giữ chắc vật thon, nên nhóm chọn hướng hỗ trợ người điều khiển.

Nguồn: README.md; 05_SO_LIEU_VA_NGUON.md mục 4 đến 8, 14.
