DuongNAD/Project_IoT/aruco_A4_clean.pdf

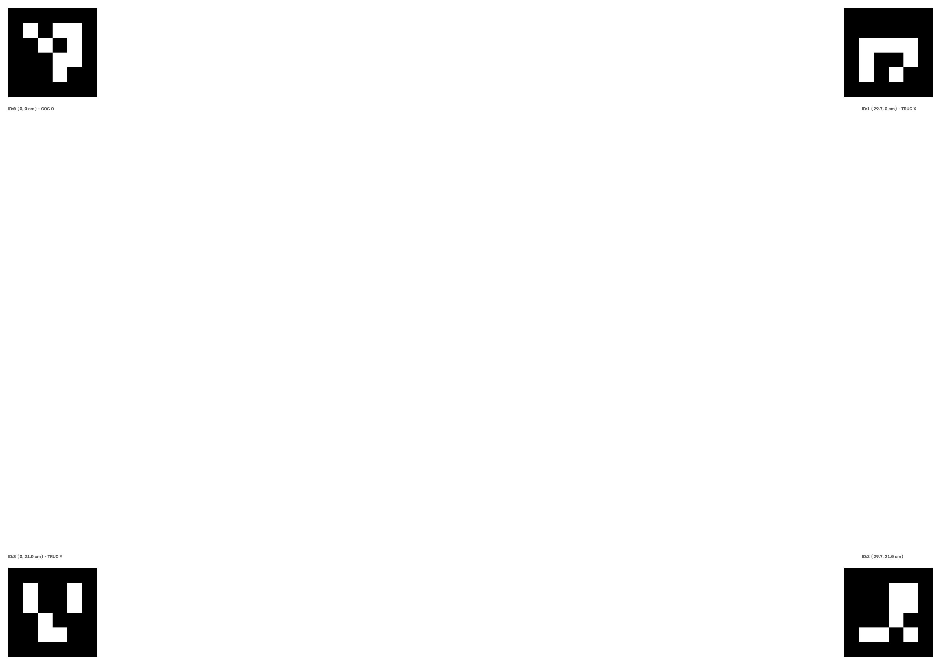
[picture p17: page 1]
