DuongNAD/Project_IoT/slides/preview/slide_01.png

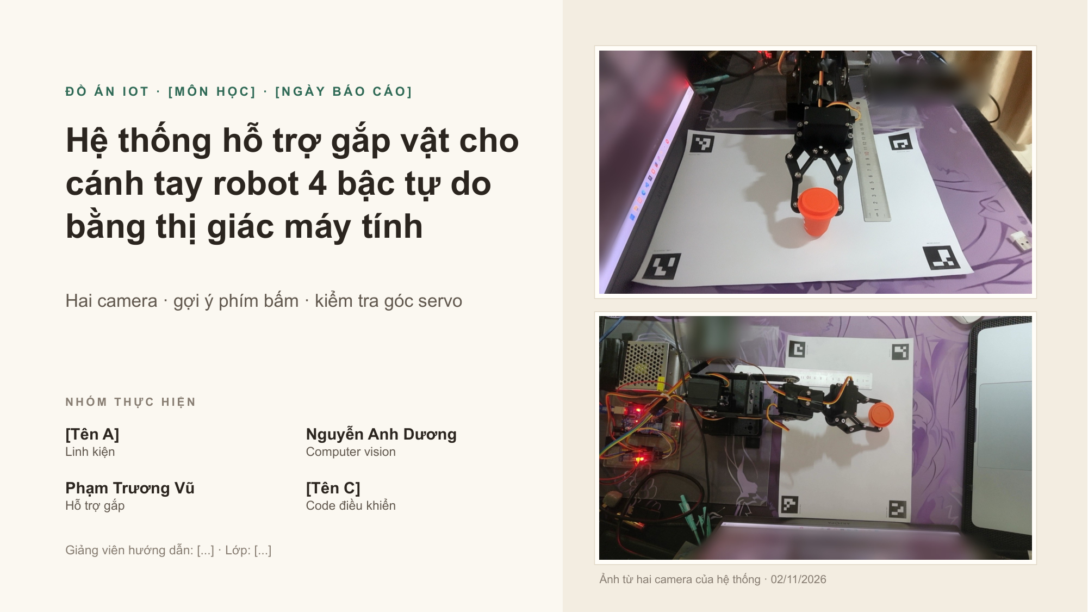
slides/preview/slide_01.png
