DuongNAD/Project_IoT/slides/preview/slide_02.png

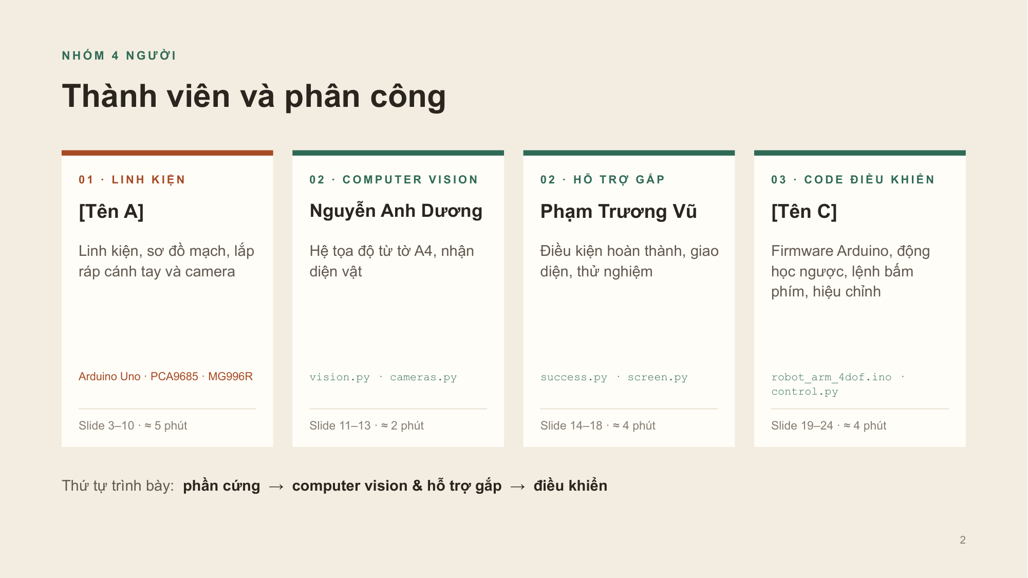
slides/preview/slide_02.png
