DuongNAD/Project_IoT/slides/preview/slide_03.png

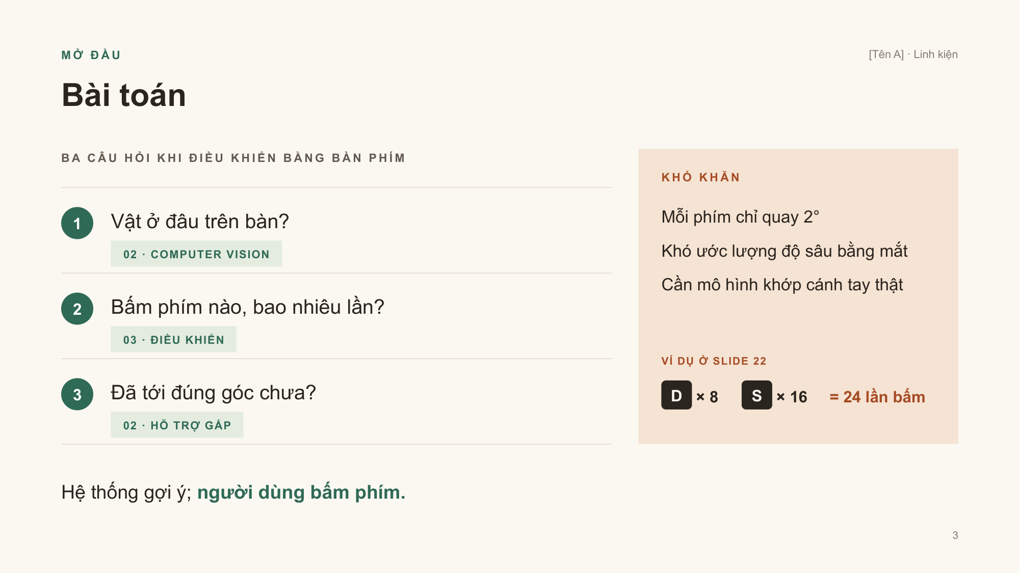
slides/preview/slide_03.png
