DuongNAD/Project_IoT/slides/preview/slide_04.png

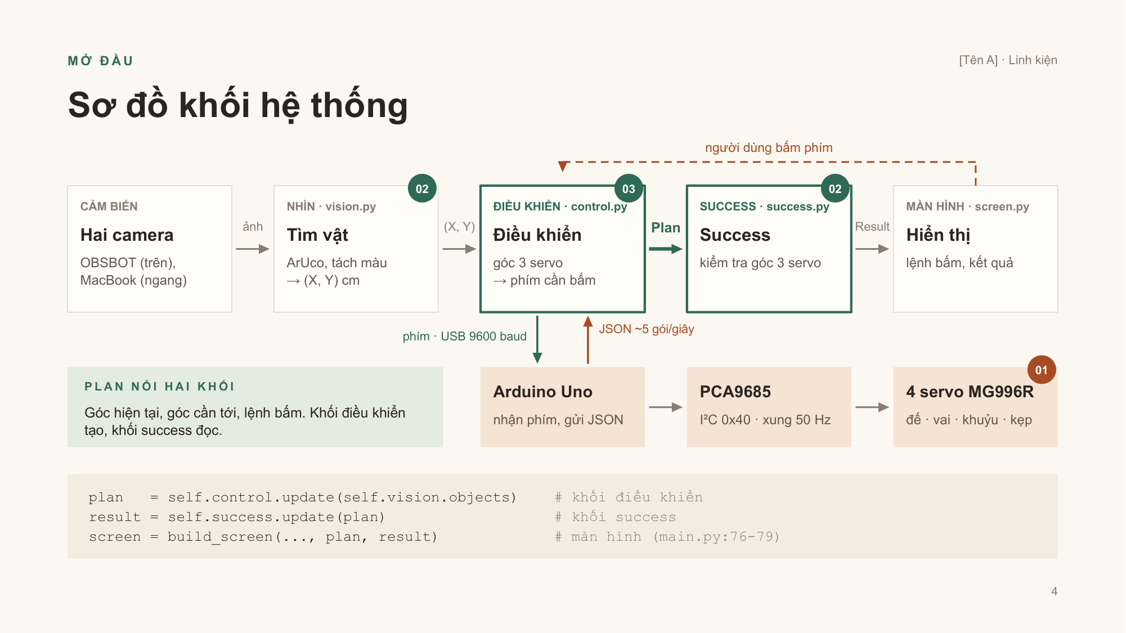
slides/preview/slide_04.png
