DuongNAD/Project_IoT/slides/preview/slide_05.png

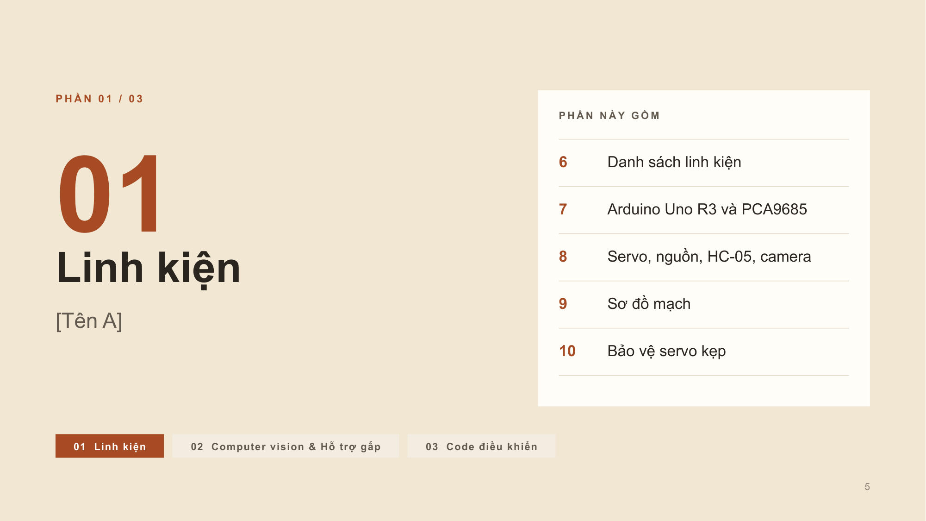
slides/preview/slide_05.png
