DuongNAD/Project_IoT/slides/preview/slide_06.png

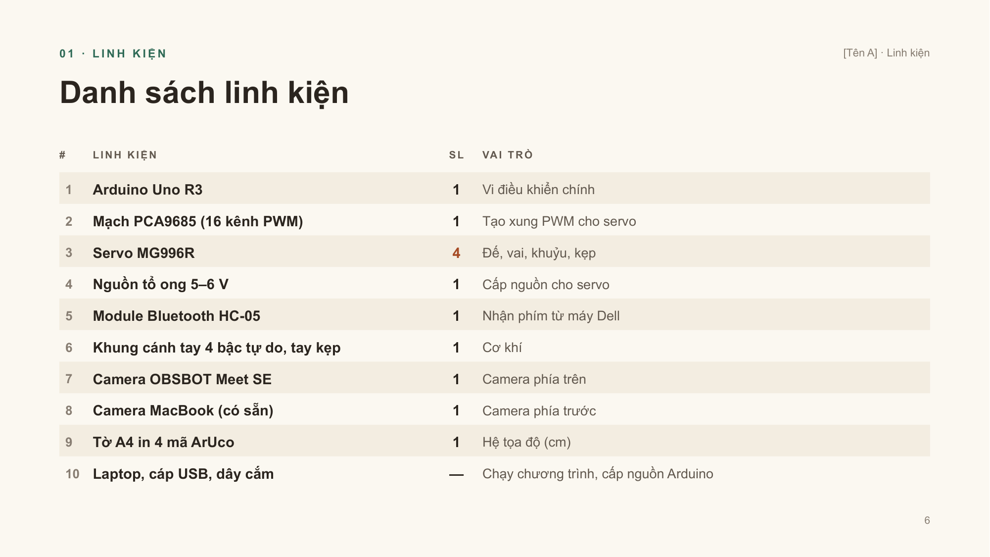
slides/preview/slide_06.png
