DuongNAD/Project_IoT/slides/preview/slide_08.png

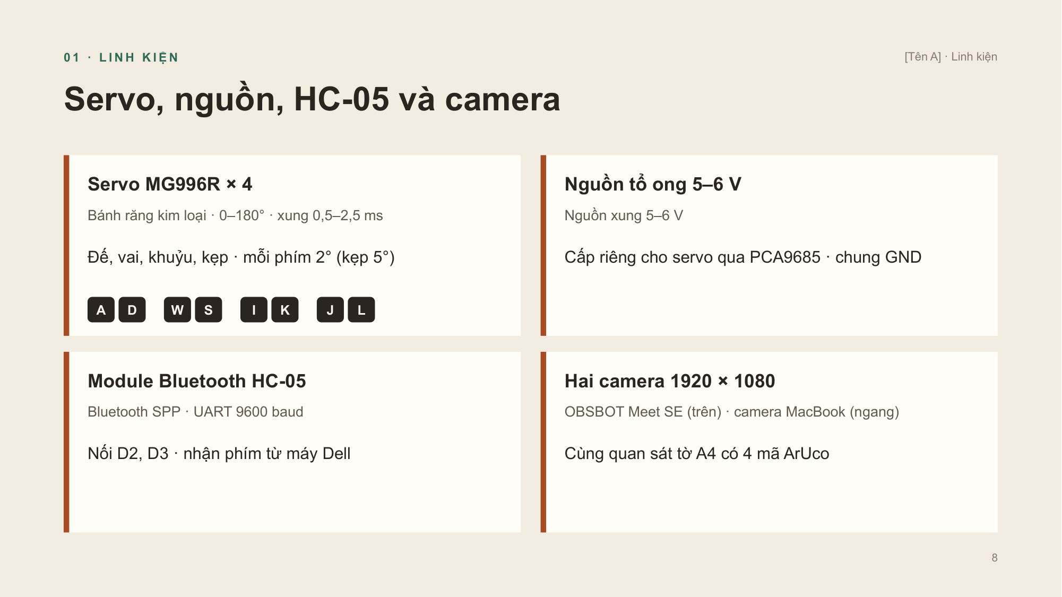
slides/preview/slide_08.png
