DuongNAD/Project_IoT/slides/preview/slide_09.png

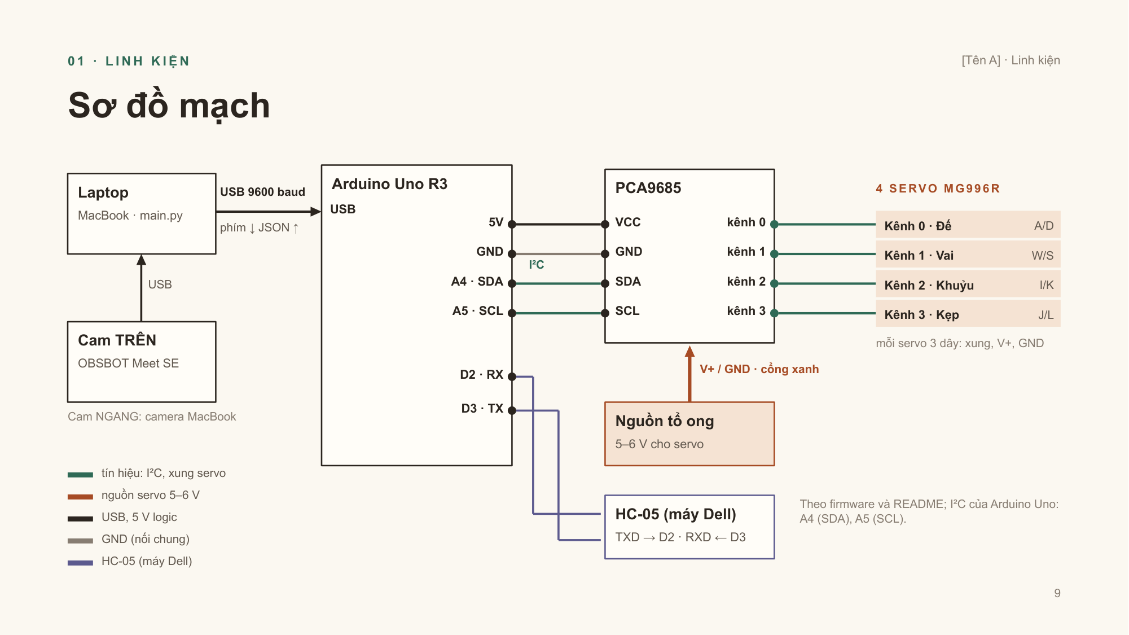
slides/preview/slide_09.png
