DuongNAD/Project_IoT/slides/preview/slide_10.png

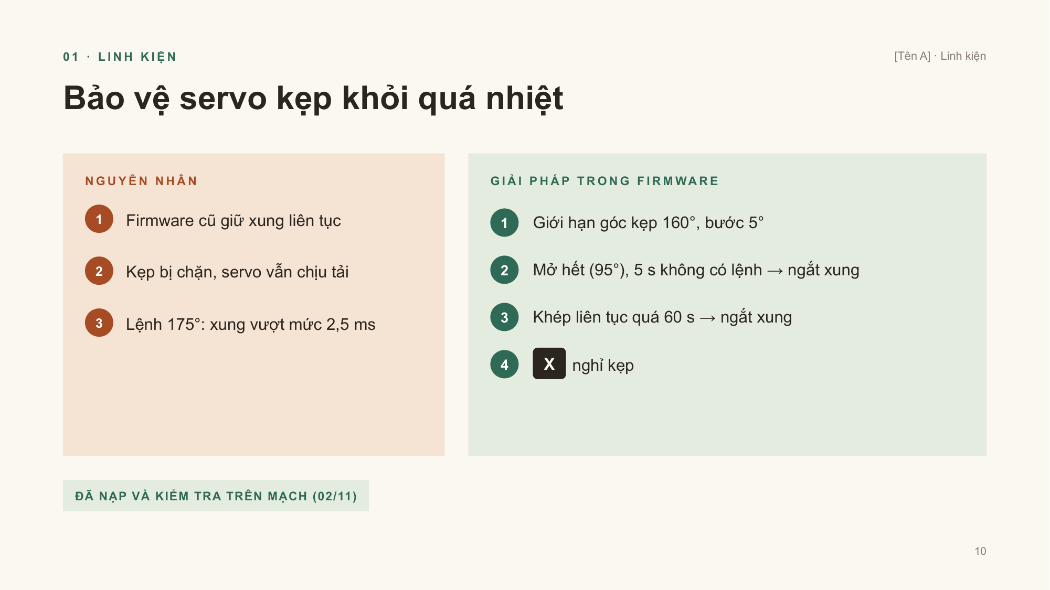
slides/preview/slide_10.png
