DuongNAD/Project_IoT/slides/preview/slide_11.png

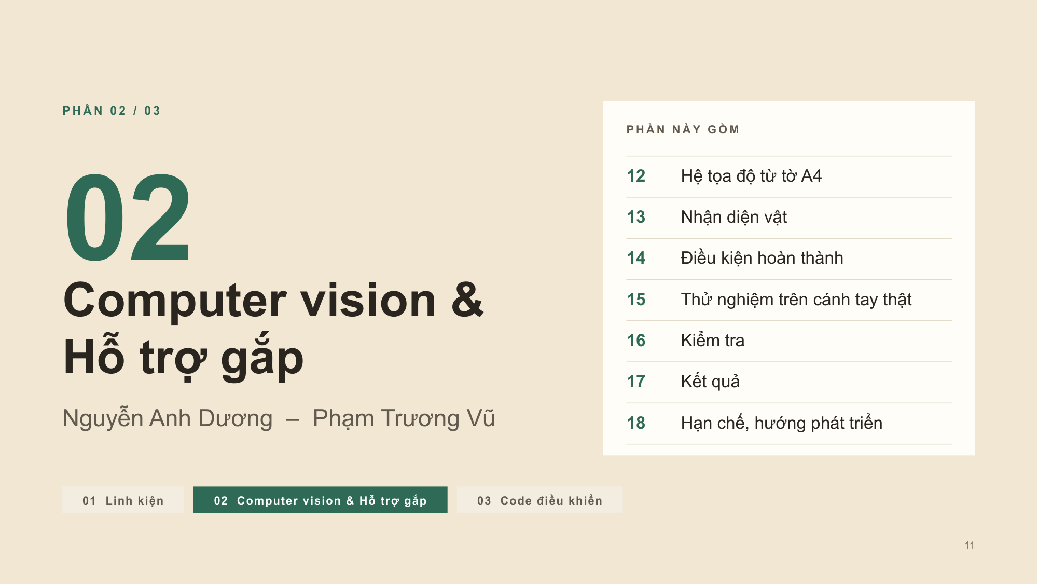
slides/preview/slide_11.png
