DuongNAD/Project_IoT/slides/preview/slide_12.png

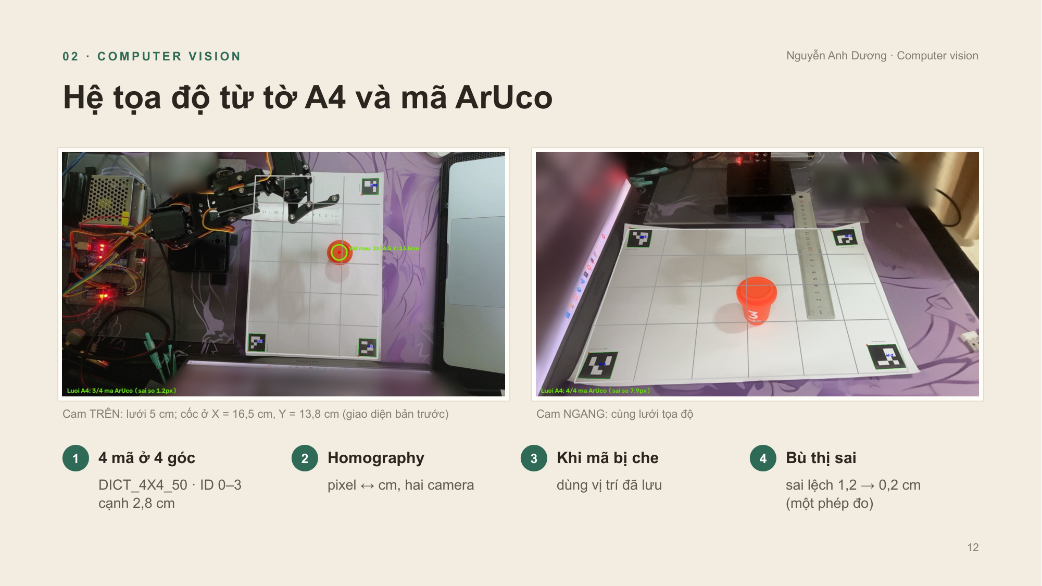
slides/preview/slide_12.png
