DuongNAD/Project_IoT/slides/preview/slide_14.png

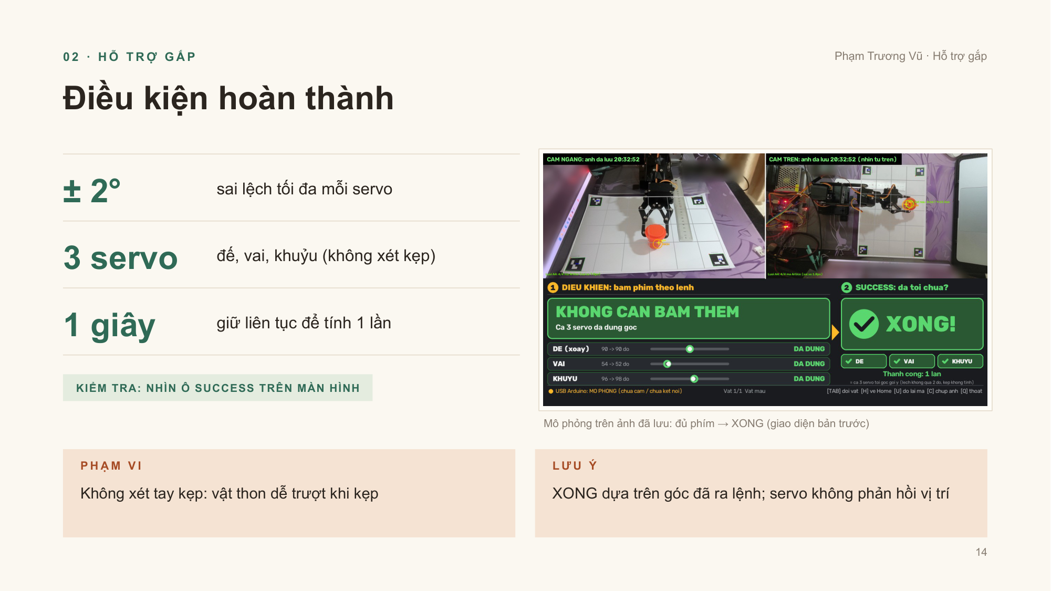
slides/preview/slide_14.png
