DuongNAD/Project_IoT/slides/preview/slide_15.png

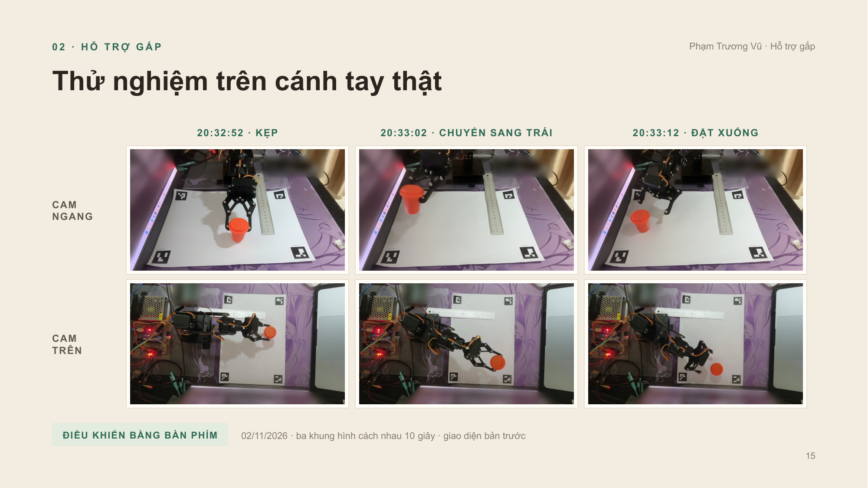
slides/preview/slide_15.png
