DuongNAD/Project_IoT/slides/preview/slide_16.png

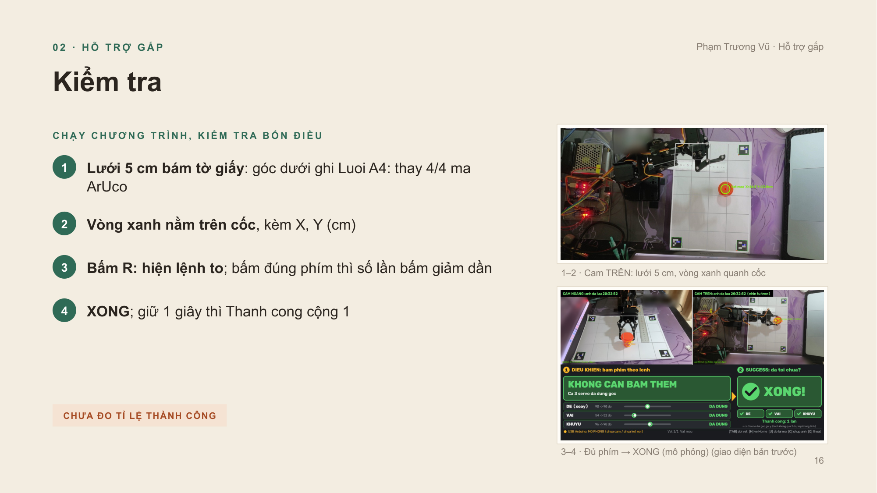
slides/preview/slide_16.png
