DuongNAD/Project_IoT/slides/preview/slide_17.png

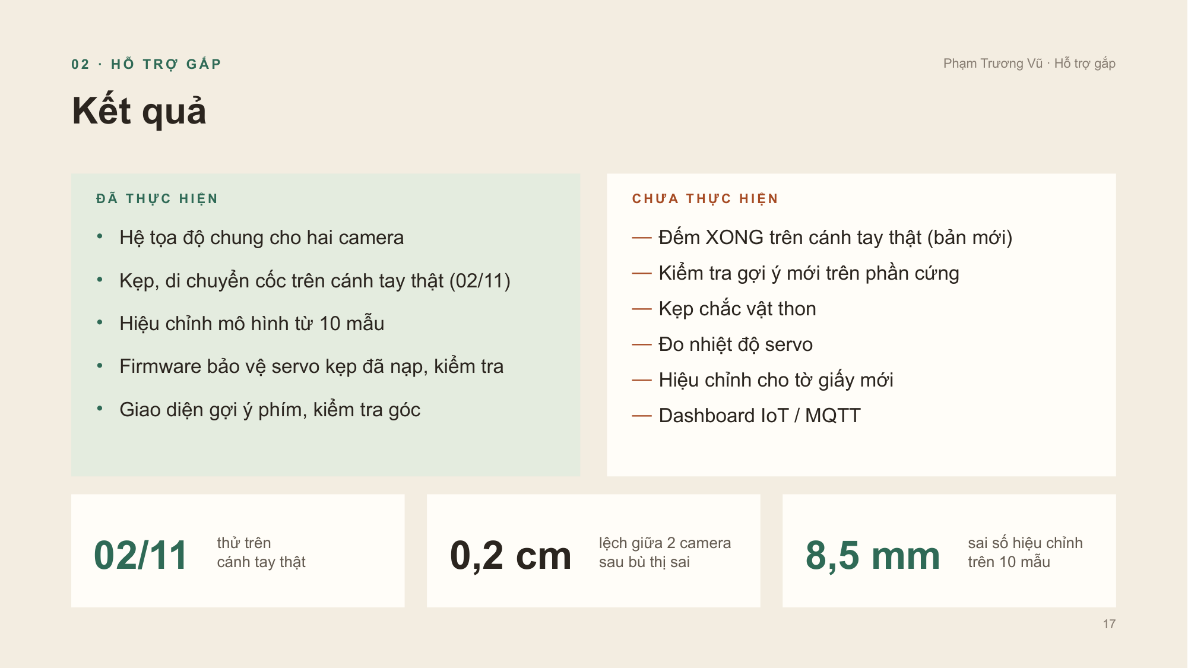
slides/preview/slide_17.png
