DuongNAD/Project_IoT/slides/preview/slide_18.png

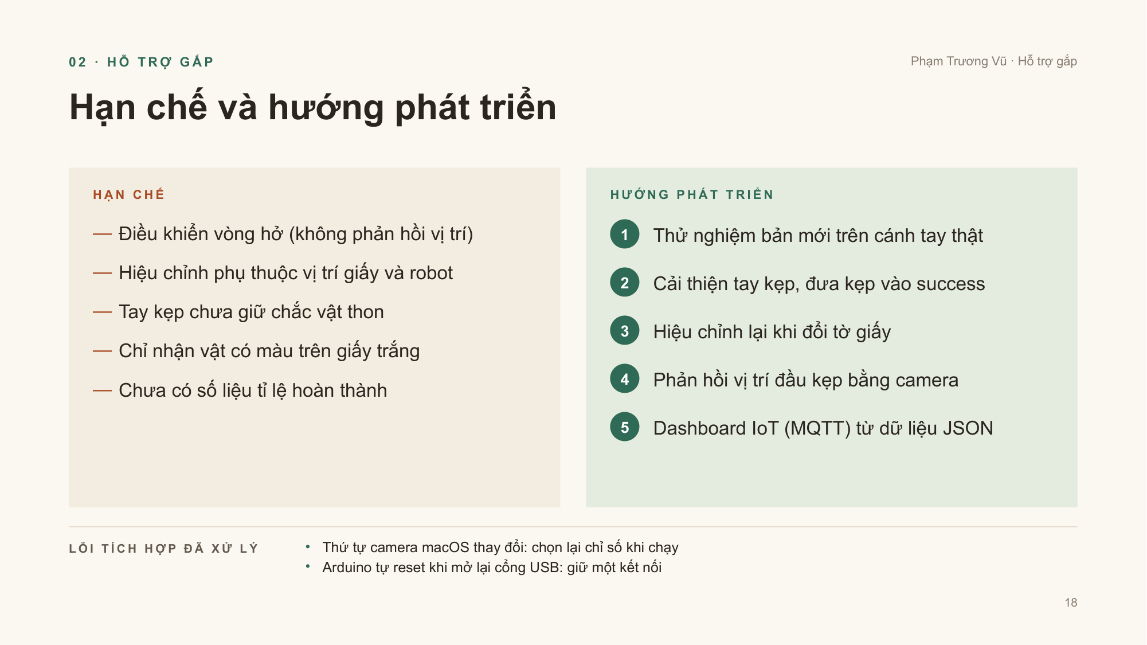
slides/preview/slide_18.png
