DuongNAD/Project_IoT/slides/preview/slide_19.png

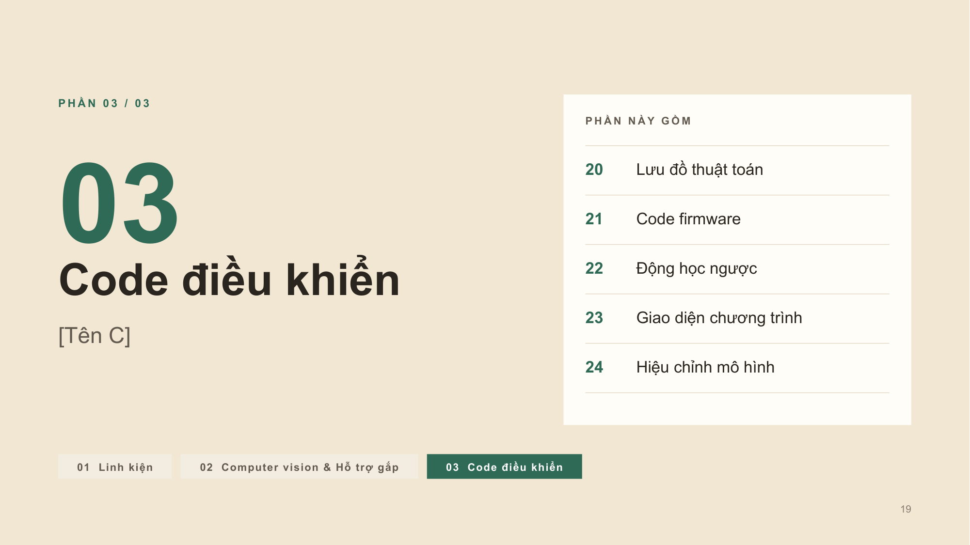
slides/preview/slide_19.png
