DuongNAD/Project_IoT/slides/preview/slide_20.png

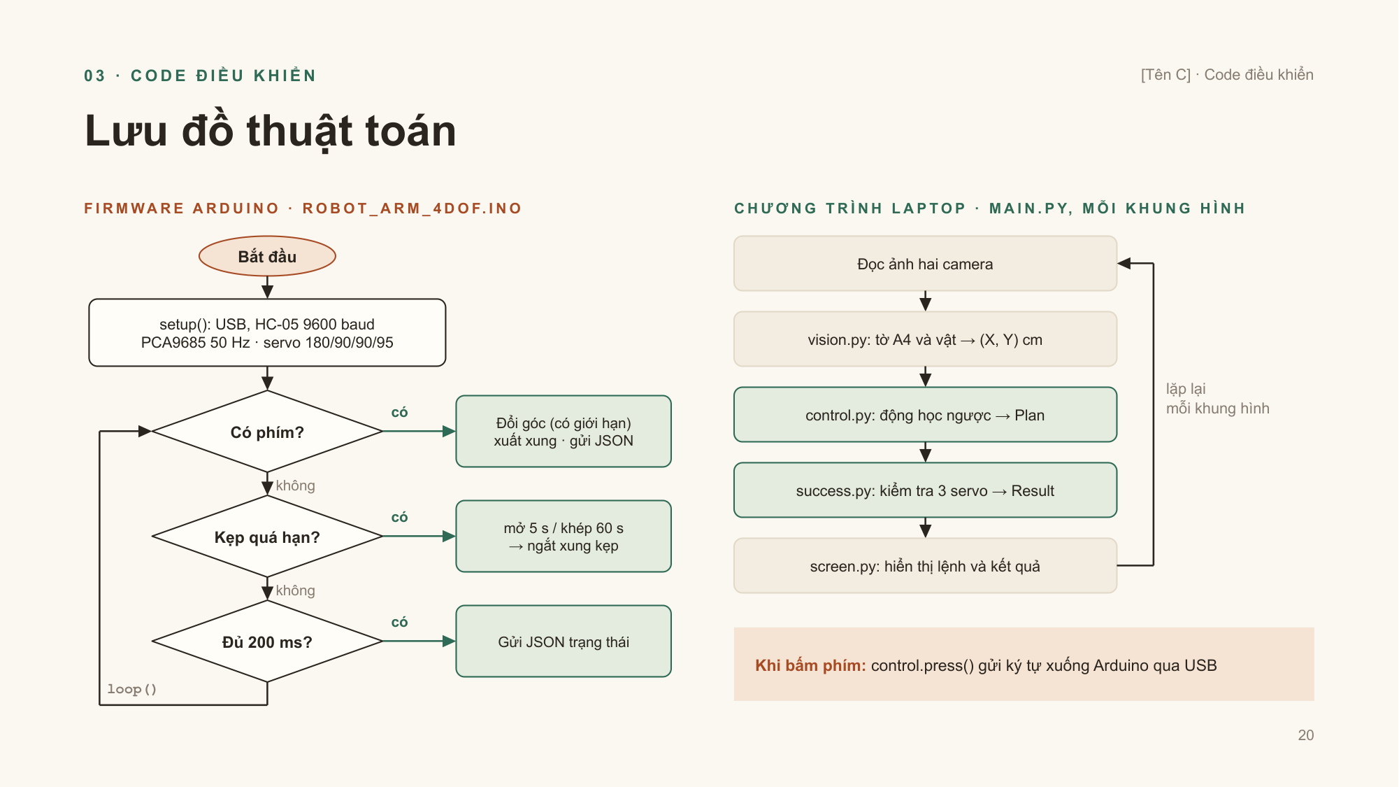
slides/preview/slide_20.png
