DuongNAD/Project_IoT/slides/preview/slide_21.png

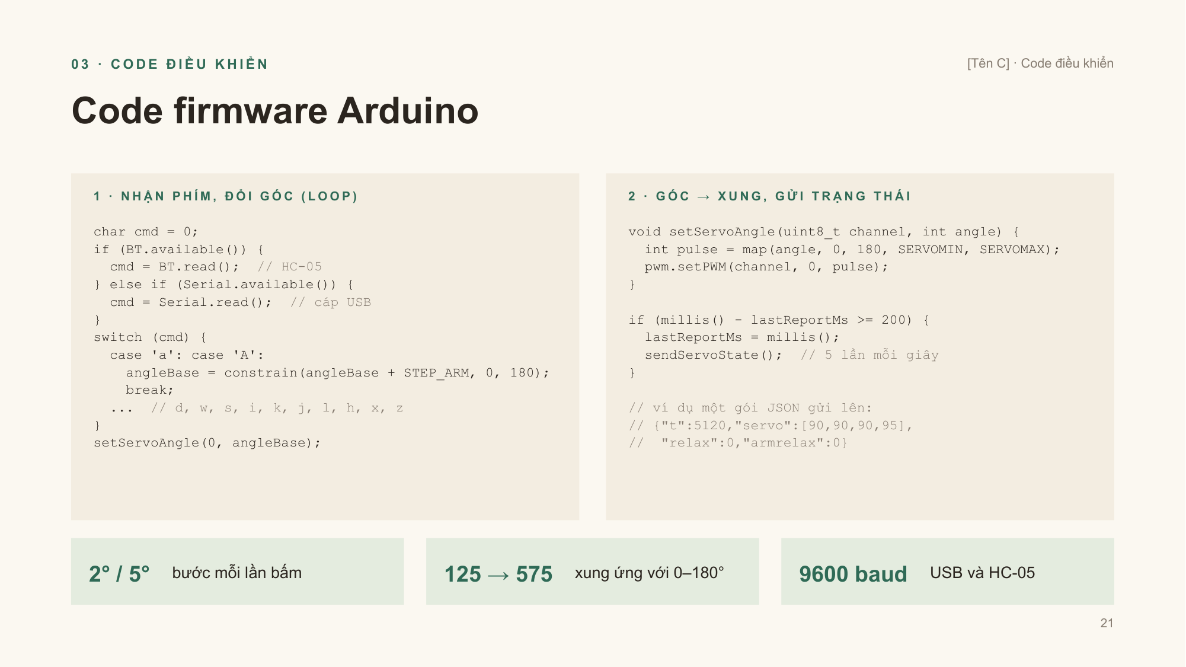
slides/preview/slide_21.png
