DuongNAD/Project_IoT/slides/preview/slide_22.png

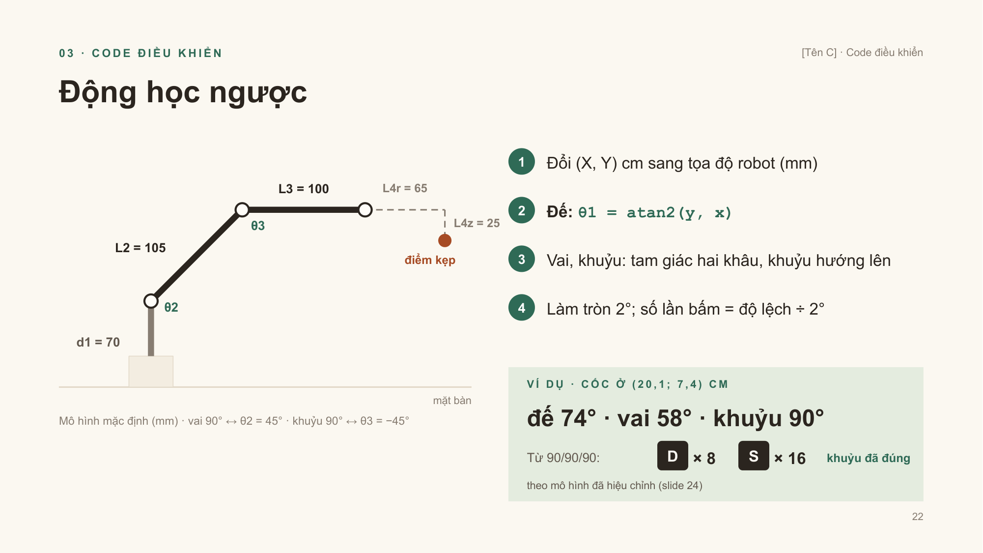
slides/preview/slide_22.png
