DuongNAD/Project_IoT/slides/preview/slide_23.png

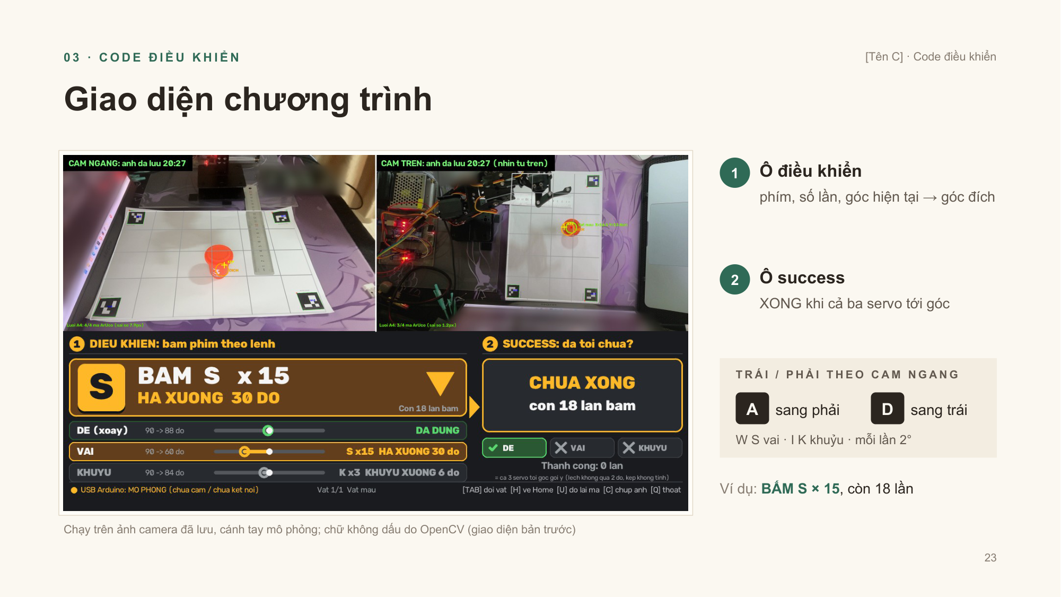
slides/preview/slide_23.png
