DuongNAD/Project_IoT/slides/preview/slide_24.png

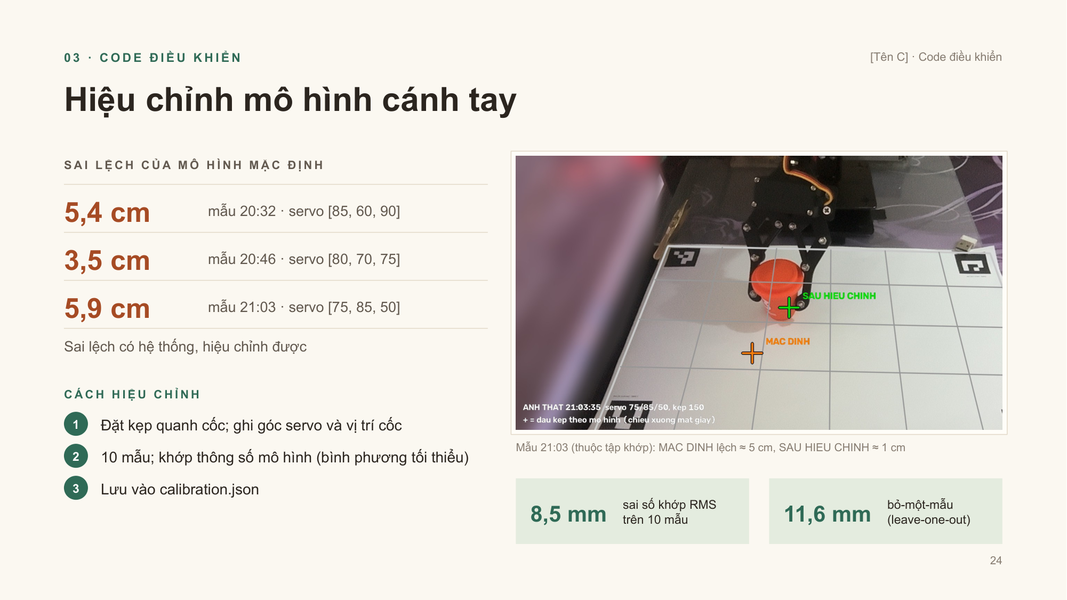
slides/preview/slide_24.png
