DuongNAD/Project_IoT/slides/preview/slide_25.png

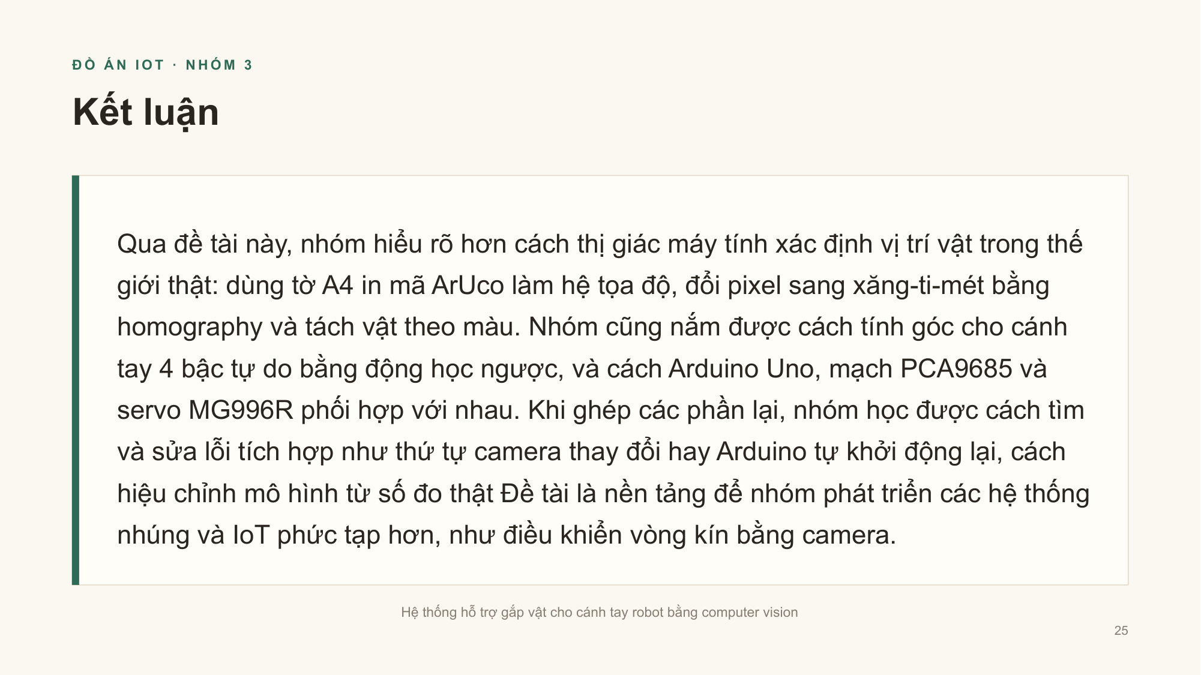
slides/preview/slide_25.png
