DuongNAD/Project_IoT/slides/preview/slide_26.png

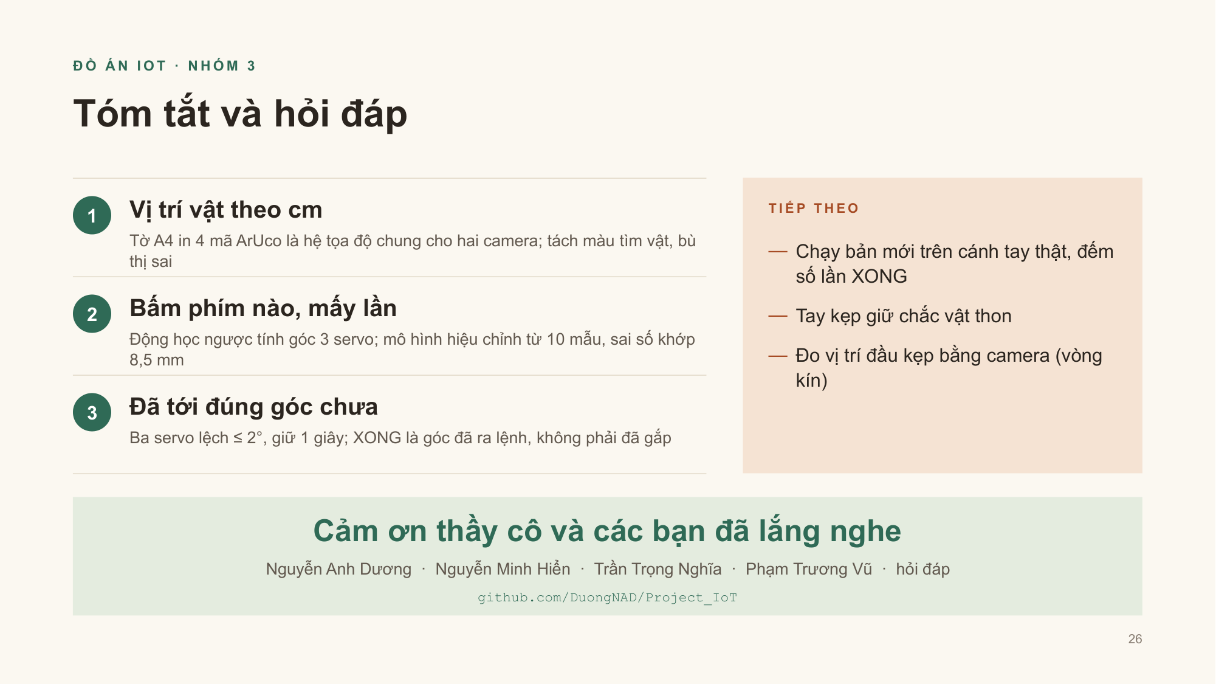
slides/preview/slide_26.png
