DuongNAD/Project_IoT/slides/preview_phan2/slide_02.png

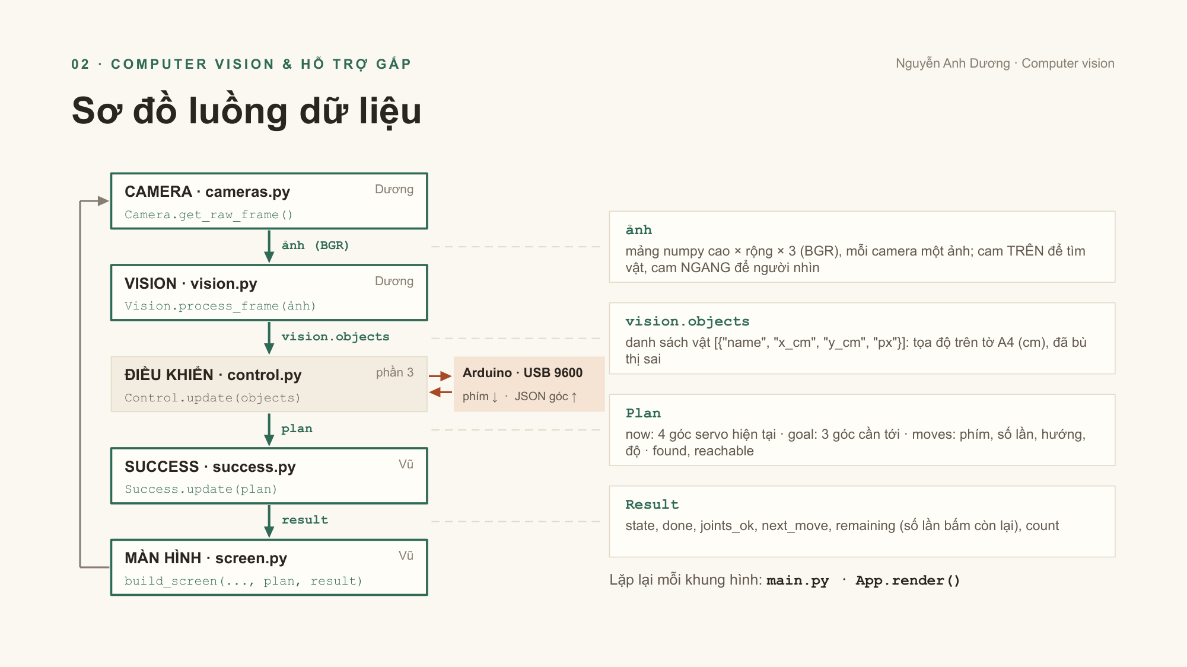
slides/preview_phan2/slide_02.png
