DuongNAD/Project_IoT/slides/preview_phan2/slide_03.png

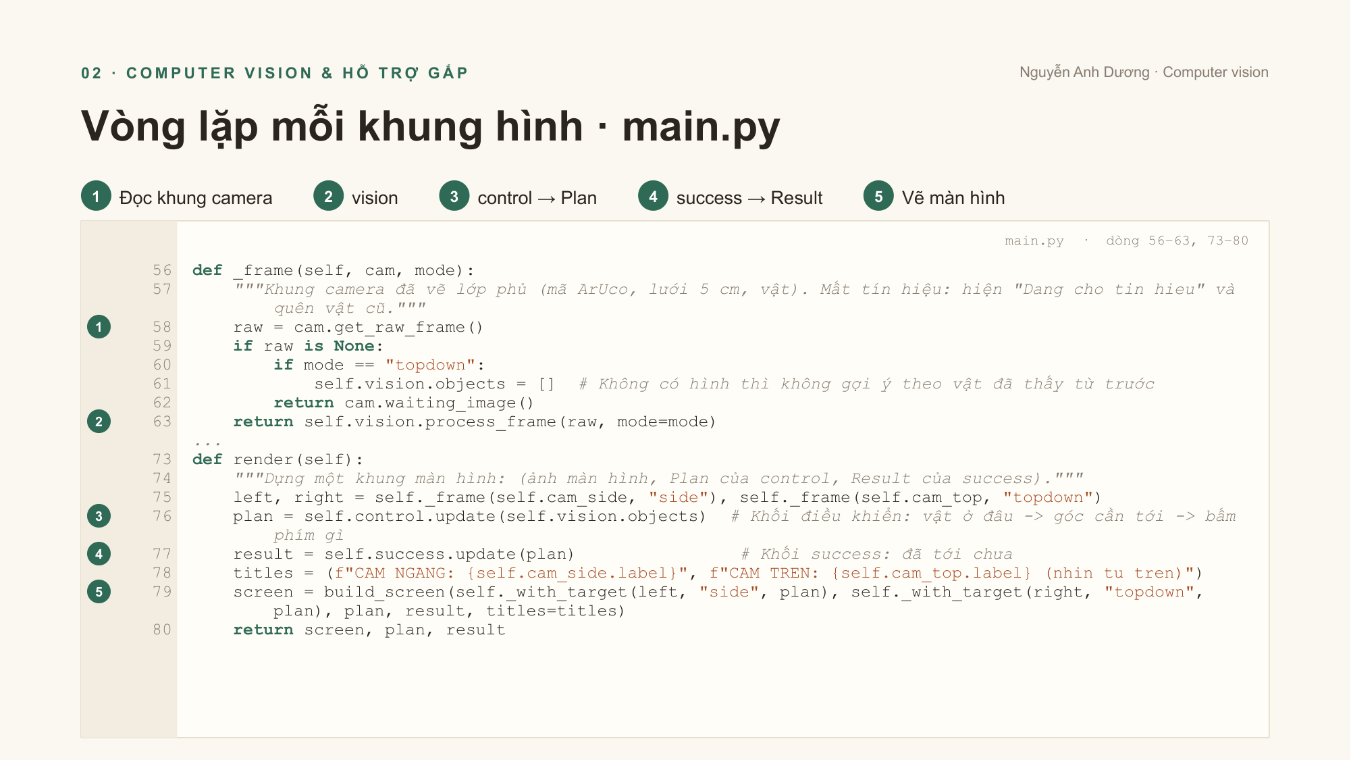
slides/preview_phan2/slide_03.png
