DuongNAD/Project_IoT/slides/preview_phan2/slide_04.png

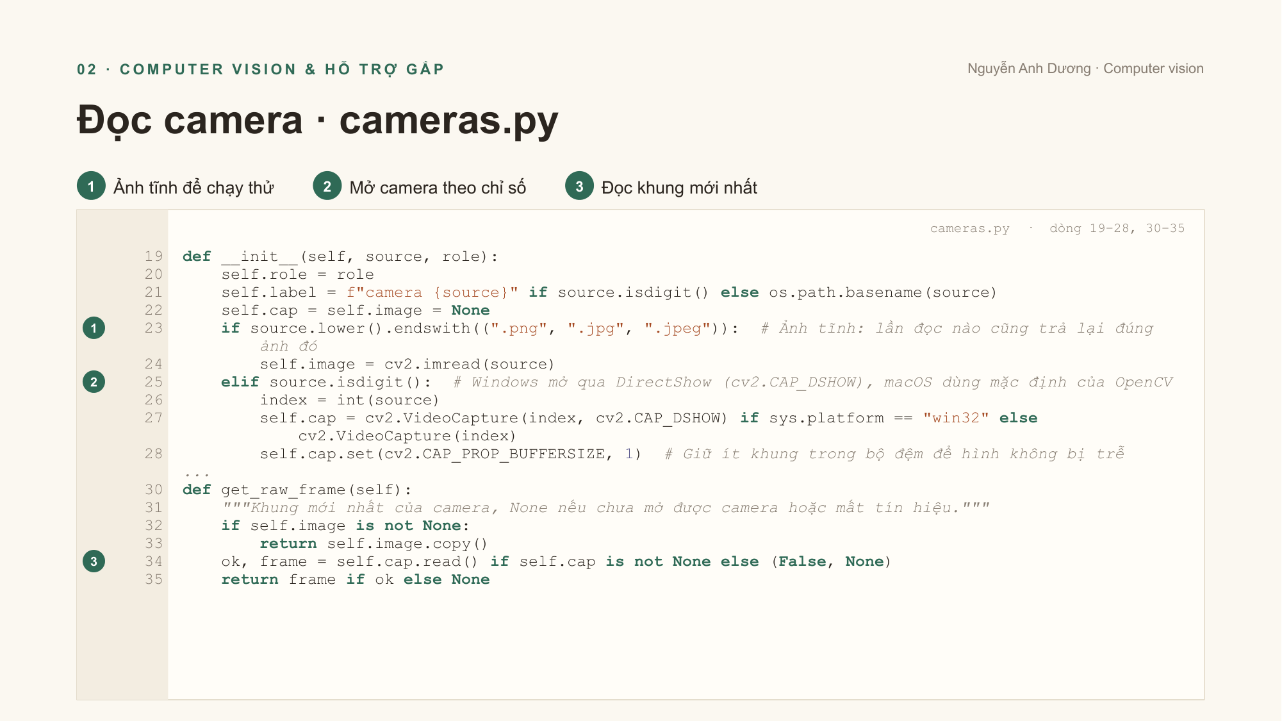
slides/preview_phan2/slide_04.png
