DuongNAD/Project_IoT/slides/preview_phan2/slide_05.png

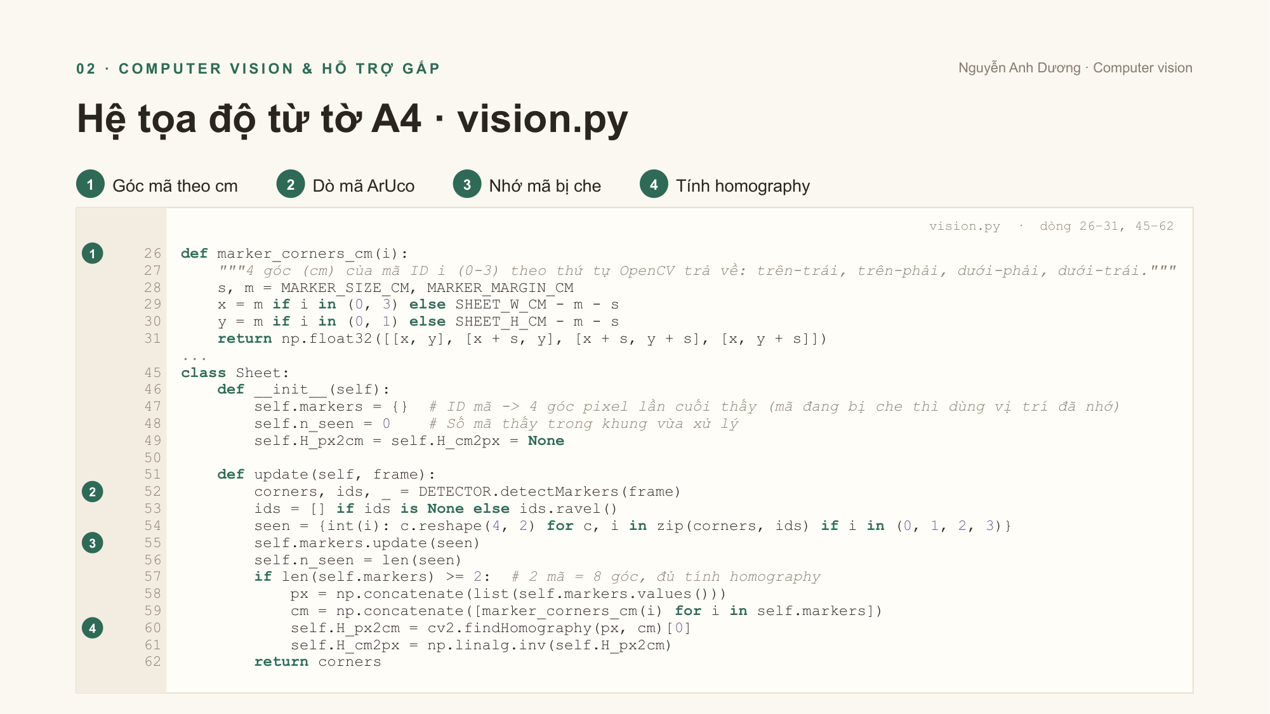
slides/preview_phan2/slide_05.png
