DuongNAD/Project_IoT/slides/preview_phan2/slide_07.png

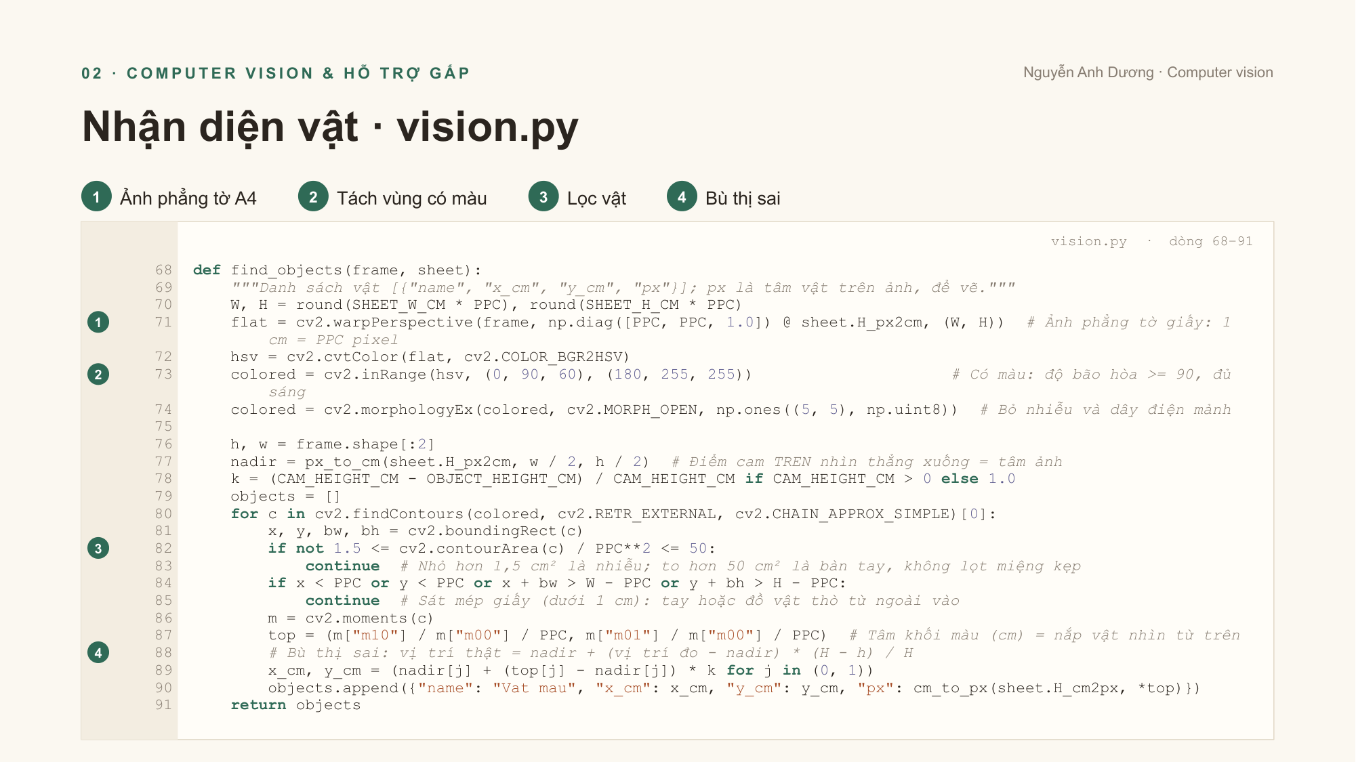
slides/preview_phan2/slide_07.png
