DuongNAD/Project_IoT/slides/preview_phan2/slide_08.png

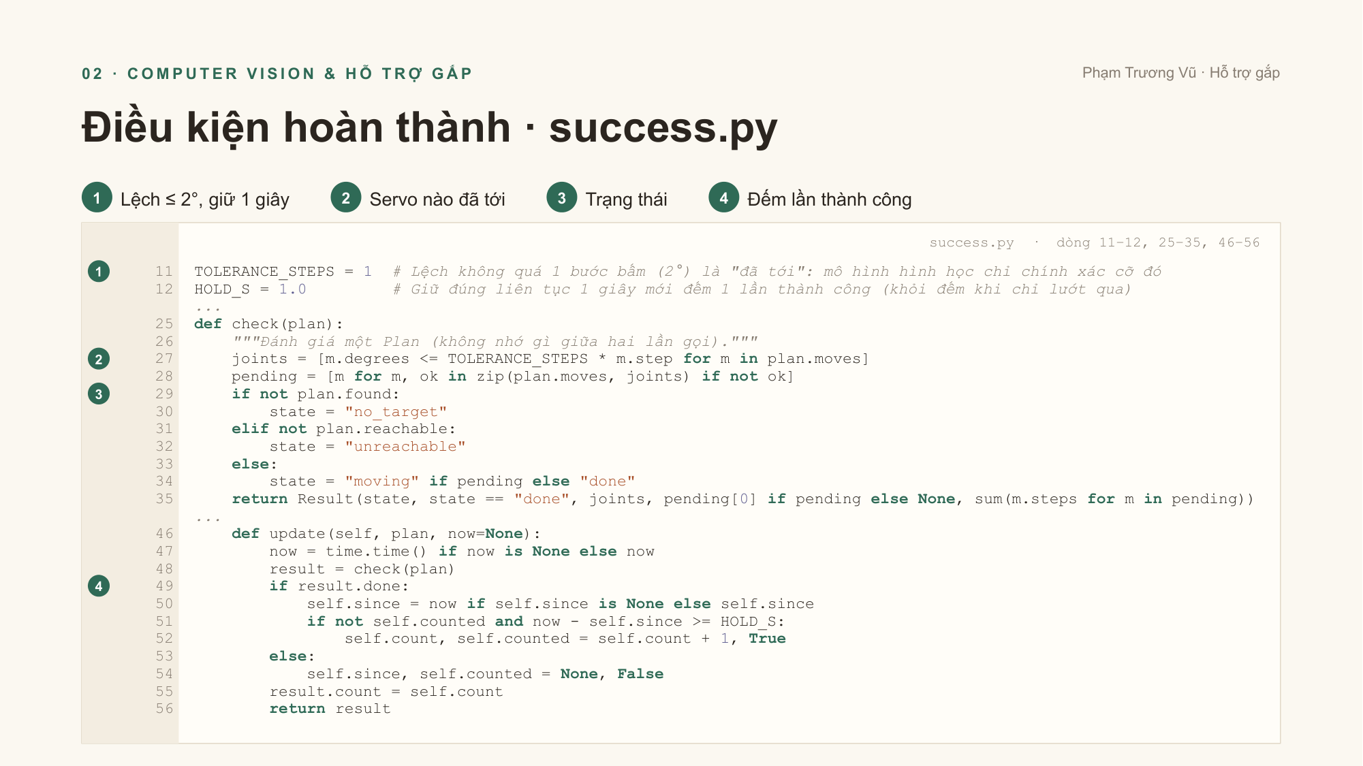
slides/preview_phan2/slide_08.png
