DuongNAD/Project_IoT/slides/preview_phan2/slide_09.png

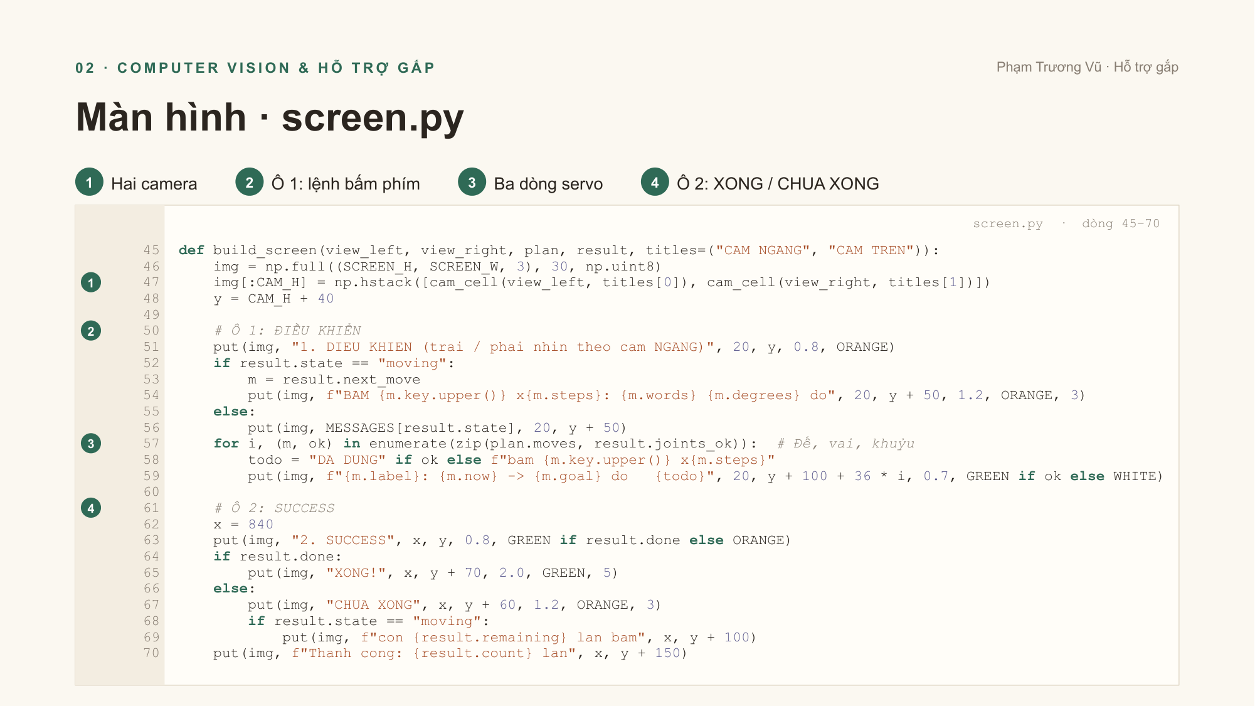
slides/preview_phan2/slide_09.png
