DuongNAD/Project_IoT/(commit log)

2026-10-29 feat: import 4-DOF robot arm grasp assistant (Python + Arduino)
    Camera-guided grasp assistant for a 4-servo arm (MG996R on a PCA9685,
    driven by an Arduino over USB serial / Bluetooth).
    - grasp_assist_4dof.py: inverse kinematics, serial link, ArUco + YOLO11
    detection, 5-step grasp state machine with a two-camera success check
    - main.py, guide_screen.py: entry point with camera capture (including a
    phone camera over adb) and the on-screen grasp guide
    - robot_arm_4dof/robot_arm_4dof.ino: servo firmware
    - generate_aruco_a4.py: printable A4 ArUco marker sheets
    - test_ik.py, test_base_servo.py: IK and base-servo test scripts
2026-11-03 refactor: simplify the app into two chained groups (control -> success)
    main.py now only glues camera -> vision -> control -> success -> screen.
    - control.py (group 1): FK/IK, Arduino serial link, target choice, Plan/Move
    (which key, how many times, which way)
    - success.py (group 2): the three arm servos within 2 degrees of the suggested
    angles, held for 1 s, count one success; the gripper is ignored
    - screen.py: two cameras on top, command (part 1) -> result (part 2)
    - vision.py, cameras.py, calibration.py, arm_fit.py: ArUco sheet + homography,
    colour-blob objects (YOLO only with --yolo), top-camera parallax correction,
    cameras found by name, hand-fitted arm geometry saved to calib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
    [calibration.py, cameras.py, control.py, main.py, robot_arm_4dof.ino, screen.py, success.py, vision.py]
2026-11-03 docs: rebuild the 15-slide deck for the two-group code
    The deck built on the Windows machine (merged in e3f2d85) described the
    old 5-step flow: S1/S2 camera checks, Auto-Step, attempts.csv, keys sent
    through the HC-05 and test_ik.py. The two-group refactor removed all of
    these, and build_slides.py no longer ran because it imported the deleted
    modules.
    - build_slides.py: rewritten for control.py -> success.py; same dark
    palette as screen.py, real photos from assets/real/ (a "[Ảnh: ...]"
    box when one is missing), text sized with the Arial font files,
    speaker notes of about 12 minutes with "Nếu được hỏi" and "Nguồn",
    clean title and author metadata
    - verify_slides.py: check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
    [build_slides.py, export_pdf.py, verify_slides.py]
2026-11-03 docs: Gamota palette, 16 slides for four presenters, Keynote-safe deck
    Keynote refused the 70571c4 deck ("Định dạng tệp không hợp lệ"),
    although LibreOffice, python-pptx and Spotlight read it. Its import log
    failed 7 ms after starting. Two changes made Keynote Creator Studio
    import it:
    - lines and arrows are drawn as rotated thin rectangles plus a
    triangle instead of python-pptx connectors (<p:cxnSp>)
    - presentation.xml gets the <p:notesMasterIdLst> that python-pptx
    leaves out when it adds speaker notes
    Also: 16:9 slide size without type="screen4x3", a non-empty
    lastModifiedBy, and the zip repacked like PowerPoint (a precaution:
    re-zipping alone did not fix the import).
    Re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
    [build_slides.py, verify_slides.py]
2026-11-04 docs: 25 slides in four clear parts, with components, circuit and flowcharts
    Following two IOT102 decks the user sent as references (components
    list, one slide per component, circuit diagram, algorithm flowchart,
    code), the deck now has four parts, each opened by a divider slide
    that shows the part number, the presenter and the slides it covers:
    - 01 components: parts table; the real control-board photo with
    numbered markers plus Arduino Uno R3 and PCA9685 specs and roles;
    cards for MG996R, the 5-6 V supply, HC-05 and the two cameras;
    a drawn wiring diagram (I2C on A4/A5, PCA9685 V+ from the supply,
    channels 0-3 to the servos, HC-05 TXD->D2 RXD<-D3, USB to the
    laptop); the gripper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
2026-11-04 docs: shorter slide text, neutral wording, plainer notes
    Group feedback: too much text, long-winded, not neutral enough.
    - Titles are short noun phrases (Bảo vệ servo kẹp khỏi quá nhiệt,
    Hiệu chỉnh mô hình cánh tay, Kết quả, ...); cards and bullets cut to a
    few words; emotive or claim wording removed. On-slide words drop
    about 30% (3344 -> 2340).
    - Honesty facts stay, phrased neutrally: "mô phỏng" on the two screen
    slides, "Chưa thực hiện" list, calibration photo marked as a fit sample.
    - Speaker notes rewritten in plain sentences with digits; every
    "Nguồn:" line kept. Spoken part about 16% shorter.
    - Fixed awkward line breaks (ranges split at the d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
    [build_slides.py]
2026-11-10 refactor: shrink part 2 code to 445 lines, archive unused files
    Part 2 (computer vision + grasp assist) is now short enough to explain
    line by line: vision.py 691 -> 163, cameras.py 415 -> 118,
    screen.py 271 -> 77, success.py 75 -> 58, generate_aruco_a4.py 225 -> 29.
    Removed: YOLO and its worker thread, phone camera over adb / IP Webcam,
    image rotation, sheet fallback without markers, ArUco-tagged objects,
    the swapped-camera warning and the T / 0-3 keys, marker smoothing and
    bump detection. Kept: marker memory when the arm covers a marker,
    parallax correction, the hand / wire / robot-body filters, finding
    cameras by name (system_profiler on macOS, pygrabber on Windows).
    - screen.py: plain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
    [cameras.py, main.py, screen.py, success.py, vision.py]
2026-11-10 docs: 24 slides in three parts, part 2 = computer vision & grasp assist
    The Success part joins part 2, now "Computer vision & Hỗ trợ gắp",
    presented by Nguyễn Anh Dương (computer vision) and Phạm Trương Vũ
    (grasp assist: success, trial, results, limits). Part 3 (control code)
    follows. 25 -> 24 slides; "Phần 0x / 03" and three section tabs.
    - Section divider: two-line title, both presenter names, six-item list
    that still fits the card.
    - Team slide: cards in speaking order (hw, cv, succ, ctrl) with the
    section number of each person; long names shrink to one line.
    - Notes: new hand-offs (Dương -> Vũ -> part 3 -> summary); the success
    slide points ahead to part 3 for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
2026-11-10 feat: bring remote control back onto the refactored main
    The part-2 cleanup (3ec9f78) dropped the Wi-Fi screen share and the Dell
    app. Port them back unchanged from feature/remote-control: phone.py and
    remote.py only need the standard library and OpenCV, and the Plan/Result
    fields that status_of reads are all still there.
    - main.py: start the screen share on launch (--no-phone, --phone-port),
    send every rendered frame, take keys from the web page, close on exit;
    success is still recomputed from the live cameras on every frame
    - remote.py: Dell views the Mac screen over Wi-Fi and sends keys over
    Bluetooth to the HC-05 on the Uno (firmware unchanged)
    - tests: test_phone.py and test_remo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
2026-11-10 feat: R key locks the goal to the current camera view
    By default the goal follows the live cameras (10-frame average, kept for
    120 s when the claw hides the cup). R freezes the cup position seen at
    that moment, so the goal angles stay put while the arm moves; R again
    goes back to live tracking. Success itself is unchanged: it still
    compares the servo angles from the Arduino with the goal.
    - control.py: Control.toggle_lock(), Plan.locked; TAB moves the lock to
    the newly selected object
    - main.py: R on the Mac keyboard or from the Dell over Wi-Fi
    - screen.py: "DICH: DA CHOT / THEO CAMERA" line and [R] in the footer
    - phone.py / remote.py: Dell sends R to the Mac over Wi-Fi
    (POST /<code>/k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
2026-11-10 docs: part 2 slides with a data-flow diagram and real code
    New standalone deck slides/Phan2_LuongDuLieu_Code.pptx (+ .pdf and
    preview_phan2/) for importing into Canva, built by slides/build_part2.py
    with the same palette and helpers as build_slides.py:
    - divider for part 2 (Nguyễn Anh Dương, Phạm Trương Vũ) listing the
    new slides;
    - data-flow diagram: camera -> vision -> control -> success -> screen,
    each arrow named after the real variable (vision.objects, plan,
    result) with a card describing the data; Arduino (keys down, JSON
    angles up) and phone.py beside it;
    - six code slides quoted verbatim from the repo: main.py _frame/render,
    cameras.py list_camera_names/find_camer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
2026-11-10 refactor: drop the TAB key; part 2 deck gets the object-detection slide
    Code: TAB (switch target) is gone. control.py loses next_target() and
    selected_idx (only used to cycle), main.py the TAB/V branch and its
    help line, screen.py "[TAB] doi vat" in the footer, README the key row
    and the troubleshooting hint. The program still picks the object
    nearest to the base and keeps tracking it across frames; R still locks
    the target. Tests follow (nearest object chosen and kept; no TAB
    press): 93 tests, 85 pass here, all 93 with the OpenCV window calls
    stubbed.
    Slides: the "Nhận diện vật" slide (3 colour-detection steps, top-camera
    photo, target selection) lists "R chốt đích" instead of TA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
2026-11-10 docs: conclusion slide (Kết luận), also exported for Canva
    The closing "Tổng kết" slide becomes "Kết luận": three takeaways
    (object position in cm from the ArUco sheet; which key and how many
    presses from inverse kinematics, model fitted on 10 samples at 8,5 mm;
    reached or not: three servos within 2° held 1 s, XONG meaning commanded
    angles, not a grasp), a "Tiếp theo" box (run the new version on the
    real arm and count XONG, grip thin objects, camera feedback on the
    gripper tip), and a thank-you band with all four members as on the
    Canva member slide (MEMBERS in build_slides.py), Q&A and the repo link.
    Notes give the closing words and answers for "how many successful
    grasps" (n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
2026-11-11 chore: drop _luu_tru/ and start the base at 180 degrees
    _luu_tru/ held only archived material (Antigravity agent logs, old slide
    scripts and AI image prompts, the gridded A4 sheet, a manual servo
    script); nothing in the app, tests or slide build used it.
    The base servo now starts and returns Home (key H) at 180 degrees,
    turned fully right as seen from the side camera, so the arm no longer
    covers the object in the top camera. Firmware, the simulated link in
    control.py, tests, README and slide notes follow; the firmware has to
    be flashed again on the Arduino.
    [build_slides.py, control.py, main.py, robot_arm_4dof.ino]
2026-11-11 docs: separate conclusion slide (25 slides), decks rebuilt for Home 180
    The main deck gets a "Kết luận" slide (what the group learned) before
    "Tóm tắt và hỏi đáp"; KetLuan.pptx for Canva now carries both slides.
    Slide count, checker and docs say 25. The main deck, its PDF and
    previews are rebuilt so slides 19 and 21 match the base Home of 180°.
2026-11-11 feat: remote control from the Dell again, and R snaps the target once
    Remote control comes back in a trimmed form. share.py (92 lines, was
    phone.py at 341) only serves the Mac screen as /screen.jpg over Wi-Fi
    and accepts no commands; main.py starts it from the window loop, so
    --headless runs and tests never open it. remote.py (262 lines) shows
    that screen on the Dell and sends A D W S I K J L H X Z over the
    HC-05 Bluetooth link; H and Z need a second press within 2 s, a
    status bar shows the Wi-Fi and Bluetooth links, and the COM port is
    always given with --port. The phone page, QR code, 6-digit code,
    ngrok hints, R over Wi-Fi and HC-05 port auto-detection are left out.
    R is pressed on the Ma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
    [build_part2.py, build_slides.py, control.py, main.py, remote.py, screen.py, share.py]
2026-11-11 refactor: trim the USB link, name the two blocks, drop the C key
    Code that is easier to explain, firmware (.ino) untouched; the eight
    main modules go from 1586 to 1509 lines.
    - control.py: the USB link reads only the JSON packet the firmware
    sends after every key. Gone: parsing "Phím bấm: x", the "Robot Arm
    Ready" banner handler, the old-firmware Z warning and its flag, and
    the unused last_cmd. The simulated keys become one KEY_MOVES table
    (key -> servo, +1 / -1) instead of 30 lines of if/elif. Kept: port
    search, opening the new handle before closing the old one, and
    reset detection from the firmware uptime "t".
    - Move loses the unused arrow field.
    - "NHÓM 1 / NHÓM 2" becom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
    [build_slides.py, calibration.py, control.py, main.py, screen.py, success.py]
2026-11-11 refactor: drop the tests and the parts that can be done by hand
    Less code to learn and explain; firmware (.ino) untouched. All Python
    modules together go from about 1890 to 1418 lines.
    Removed, now done by hand or with existing tools:
    - tests/ and pytest: the program is checked by eye while it runs
    (grid on the sheet, green ring on the cup, the arm follows the keys).
    - generate_aruco_a4.py (and Pillow): the printed sheet
    aruco_A4_clean.pdf stays; the markers are OpenCV's DICT_4X4_50.
    - arm_fit.py and the calibration save helpers: the fitted values stay
    in calibration.json; calibration.py only loads it.
    - B key (base calibration by mouse click): measure the base with a
    ruler and edit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
2026-11-11 refactor: trim the app down to the five-block flow
    - cameras.py: read frames in the main loop (no reader thread, no auto-reopen)
    - control.py: open the USB port once and let pyserial raise on errors; drop
    unused Plan fields, the Z key and the relaxed state; move forward
    kinematics (the KEP marker) to slides/tools/fk.py for the slide tools
    - success.py: four states (relaxed removed); screen.py, vision.py and
    main.py no longer draw the KEP marker
    - remote.py / share.py: keep viewing the Mac screen and sending keys,
    drop reconnects, the status bar and the Z confirmation
    [cameras.py, control.py, main.py, remote.py, screen.py]
2026-11-11 docs: update guides, facts and decks for the trimmed code
    - hoc_phan2 guides, README and 05_SO_LIEU_VA_NGUON: new line numbers,
    four success states, no Z key, no KEP marker, 992 lines of Python
    - Phan2 deck: slides 3-4 rewritten for the simpler main.py and cameras.py;
    slide 8 marks the new state order
    - Full deck: fixes in the Duong / Vu slides (caption overlap on slide 16,
    notes on slides 11, 17, 18) and decks, PDFs and previews rebuilt
    [build_part2.py, build_slides.py, verify_slides.py]
2026-11-12 refactor: drop the robot-body filter; slides say "Kiểm tra"
    find_objects no longer builds a mask of the dark arm and no longer
    drops colour blobs that overlap it by more than 30%. The target is
    snapped once when R is pressed (normally with the arm at Home), so
    the filter only mattered for a re-press with the arm over the sheet.
    find_objects is now vision.py:68-91 and process_frame 135-157.
    Slides follow the code: the object-detection slide (both decks)
    drops "dính thân robot" from the filter card and notes, the part-2
    code slide shows lines 68-91, and the eye-check slide is titled
    "Kiểm tra" with "Chạy chương trình, kiểm tra bốn điều". Line refs
    and code size (823 lines) u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
    [build_part2.py, build_slides.py, vision.py]
2026-11-14 refactor: drop the X and Z keys and trim unused arm-relax code
2026-11-14 refactor: set base Home to 0 deg and update arm/object dimensions
    - Change base Home angle from 180 deg (right) to 0 deg (left) in firmware, flash.sh, control.py, main.py, and README.md
    - Update arm geometry in control.py (d1_mm = 90.0, L3_mm = 145.0 for 40 mm object grasp, L4_r_mm = L4_z_mm = 0.0, GRASP_Z_MM = 20.0)
    - Update OBJECT_HEIGHT_CM to 4.0 in vision.py
2026-11-14 refactor: align A/D left/right direction and trim unused firmware output
    - Align base rotation wording to match .ino: A (+2 deg) = left, D (-2 deg) = right, Home 0 deg = fully right across control.py, screen.py, main.py, flash.sh, and README.md
    - Trim unused fields (t, relax), banner/echo prints, startup delay, and redundant relax report from robot_arm_4dof.ino; ignore unknown serial chars
    - Update line references and 4 cm object height in README.md and hoc_phan2/ guides
